Djoko-cli/haier-cchp21ebb-hotte-matter/docs/photos/1.jpg

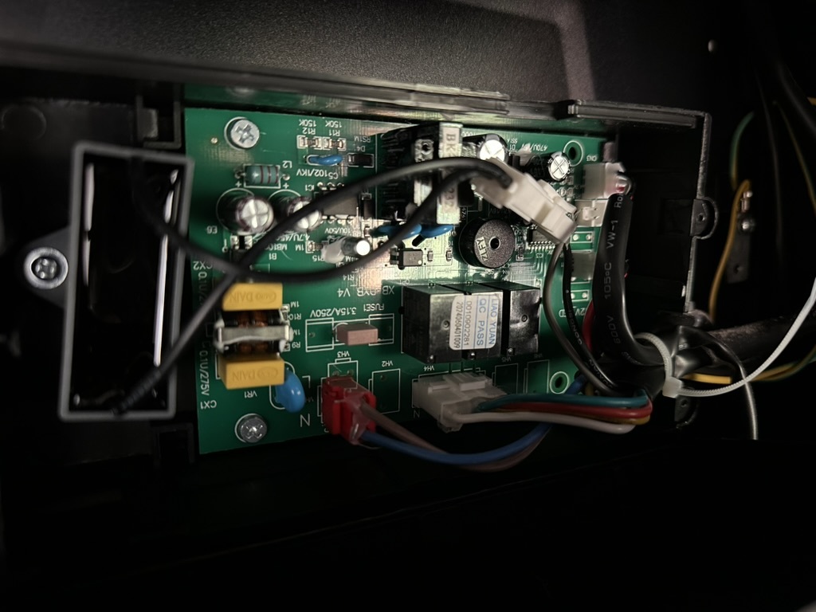
docs/photos/1.jpg
