Djoko-cli/haier-cchp21ebb-hotte-matter/docs/photos/etape0-relais.jpg

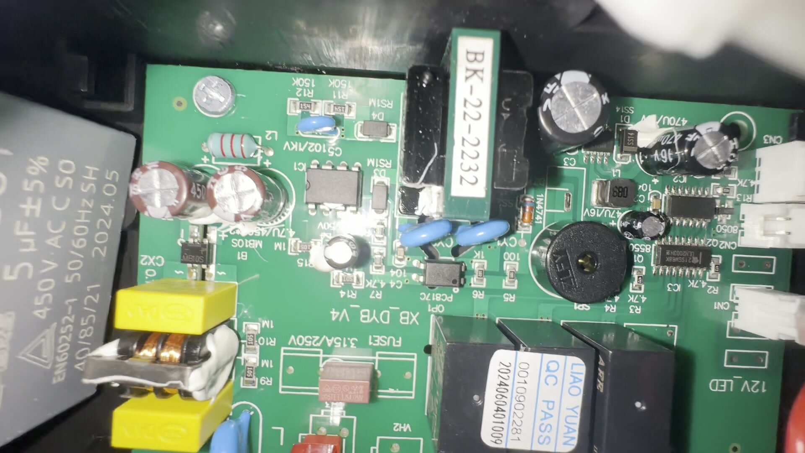
docs/photos/etape0-relais.jpg
