Djoko-cli/haier-cchp21ebb-hotte-matter/docs/RECONNAISSANCE.md

# Journal de la reconnaissance

Journal du sous-projet 1 (déroulé : §6 de
[SPEC-RECONNAISSANCE.md](SPEC-RECONNAISSANCE.md)). Chaque étape consigne ce
qu'elle a relevé : date, conditions, mesures, photos et décision. **On ne passe à
l'étape suivante que si son critère de sortie est rempli.**

Règles de sécurité : [SECURITE.md](SECURITE.md). Montage, points de test et
valeurs : [WIRING.md](WIRING.md).

**Comment remplir :**
- une ligne par mesure ; « Relevé » : la valeur lue, avec son unité ;
  « Décision » : la suite, ou **ARRÊT** (on ne raccorde rien, on ne met pas sous
  tension, on revient à la conception) ;
- les pinces se posent et se déplacent hotte débranchée (règle 4) ;
- photos dans `docs/photos/`, nom proposé `etapeN-sujet.jpg`, sans métadonnées
  EXIF ;
- ce journal est versé dans un **dépôt public** : ni SSID, ni mot de passe, ni
  clé, ni adresse, ni numéro de série.

## Installation et instruments

| Élément | Relevé |
|---|---|
| Hotte | Haier CCHP21EBB, fabrication 06/2024 |
| Prise et différentiel 30 mA (repère au tableau électrique) | |
| Multimètre : modèle ; calibre ohmmètre le plus élevé ; fréquence et rapport cyclique ? | |
| Batterie USB : modèle ; essai de 30 min, sonde en Wi-Fi, sans coupure (date, résultat) | Anker Prime Power Bank 250 W (99,54 Wh) ; 09/11/2026, 30 min avec le motif `krona`, un seul boot, aucun trou de plus de 0,3 s : OK ([BANC.md §7](BANC.md)) |
| Analyseur FX2 : reçu le ; version de PulseView | clone « Saleae » 24 MHz 8 voies (FX2, AliExpress), commandé le 27/09/2026 ; reçu le ____ ; PulseView ____ (pilote `fx2lafw` ; **pas** le logiciel Saleae Logic 2, qui refuse les clones) |
| Oscilloscope, optionnel (niveaux bas chiffrés aux étapes 5b et 7) : modèle, ou « aucun » | aucun : niveau bas jugé fonctionnellement (choix de l'utilisateur, 27/09) |
| Firmware de la sonde (`fw` de `hello`) | `0.1.0-8edfb6a` (banc 21, 10/11/2026) ; à relever de nouveau à l'étape 5 |
| Couleurs du câble de sortie : fil 1 `−`, fil 2 `+`, fil 3 `D_panneau`, fil 4 `D_carte` | prévu (UL1007 22 AWG commandé le 27/09) : noir `−`, rouge `+`, blanc `D_panneau`, marron `D_carte`, comme le câble d'origine du panneau (noir `−`, blanc `D`, rouge `+`) |
| `R_be` de l'étage d'écoute (100k par défaut ; changements notés à l'étape 5b) | |
| Carte de la sonde : modèle (le produit prévoit la SuperMini violette, antenne céramique) | |
| Point d'accès Wi-Fi pour M1 : pièce, distance à la hotte, canal 2,4 GHz (ni SSID ni adresse : dépôt public) | |
| Routeurs de bordure Thread : modèles, distance à la hotte | dans la même pièce, à moins de 5 m (l'utilisateur, 28/09) ; modèles : ____ |

## Tests du différentiel (règle 2)

Avant la première mise sous tension de chaque montage, juste avant de le poser,
hotte dans son état précédent, déjà contrôlé : hotte branchée, lumière allumée,
bouton T. **La lumière doit s'éteindre**, sinon **ARRÊT**. Réarmer, puis
débrancher pour poser le montage.

| Date | Avant quel montage | Lumière éteinte par T ? | Décision |
|---|---|---|---|
| | adaptateur (première mise sous tension : étape 2c) | | |
| | fuite en charge (étape 3a) | | |
| | sonde (étape 5) | | |
| | analyseur (étape 5b) | | |
| | étage d'injection (étape 7) | | |

## Journal des anomalies (règle 12)

Anomalie : déclenchement du différentiel ou du disjoncteur, odeur, fumée,
claquements de relais répétés, bip continu, panneau mort, fil chaud. On
débranche ; on ne réarme et on ne rebranche qu'une fois la cause comprise et
notée ici.

| Date, heure | Étape | Ce qui était branché ; ce qu'on a vu, entendu, senti | Cause comprise | Reprise (date) |
|---|---|---|---|---|
| | | | | |

## Étape −1 : observation d'usage

**Date :** 27/09/2026, vidéo de l'utilisateur `IMG_9091.MOV` (35 s, 19 h 43), analysée image par image (toutes les 0,5 s, puis toutes les 0,1 s pour le clignotement) et au spectrogramme pour les bips et le bruit du moteur. La vidéo n'est pas versée dans le dépôt (58 Mo) ; les états du panneau sont dans [photos/panneau-etats.jpg](photos/panneau-etats.jpg).

**Conditions :** hotte en usage normal, fermée ; aucun outil.

**Disposition du panneau**, de gauche à droite : **vitesse 3** (ventilateur à 5-6 pales), **vitesse 2** (4 pales), **vitesse 1** (3 pales), **lumière** (soleil), **marche** (⏻). L'ordre des vitesses est confirmé par le bruit du moteur (bande 100-1 500 Hz, en régime) : environ −39 dBFS en V1 (après 2 s d'accélération), −33 en V2, −29 en V3.

| # | Mesure | Calibre | Attendu | Relevé | Décision |
|---|---|---|---|---|---|
| 1 | depuis la veille, un appui sur une vitesse sans passer par « marche » | — | rien, un bip, ou un démarrage | **rien, et pas de bip** (réponses de l'utilisateur, 27/09) : une vitesse n'agit que si « marche » a été appuyée avant | une vitesse injectée depuis l'arrêt devra être précédée de « marche » (séquence de l'avenant). Sans bip, deux lectures restent possibles : le panneau n'envoie rien (il garde l'état « marche »), ou la carte reçoit la touche et l'ignore sans bip. La capture de l'étape 5 tranchera : une trame apparaît-elle sur `D` pour une vitesse appuyée sans marche ? |
| 2 | la lumière s'allume-t-elle sans « marche » ? | — | oui ou non | **oui** : à 16,7 s, lumière allumée voyant ⏻ éteint ; éteinte à 18,6 s. Elle reste aussi allumée quand on coupe la marche (33,0 s) | la lumière est indépendante de la marche |
| 3 | « marche » quand le moteur tourne | — | arrêt immédiat, **marche prolongée** (arrêt différé natif, comme les 15 min de la CDA : durée ?), ou rien | **marche prolongée** (27,7 s, en V3) : le moteur continue à la même vitesse, le voyant V3 reste fixe, le voyant ⏻ **clignote à 1 Hz** (0,5 s allumé, 0,5 s éteint). Durée : **15 min** (réponse de l'utilisateur, 27/09). Dans la vidéo, interrompue à 31,2 s par un appui sur V3, qui arrête le moteur tout de suite ; le voyant ⏻ redevient alors fixe (marche maintenue) | **arrêt différé natif de 15 min** : à exploiter au sous-projet 2 |
| 4 | nouvel appui sur la vitesse active | — | | **arrêt du moteur** (12,9 s, en V3) : voyant de vitesse éteint, marche maintenue (⏻ fixe) ; le moteur ralentit en environ 1,5 s | les vitesses sont des bascules sur elles-mêmes |
| 5 | l'état « armé » après « marche » s'éteint-il seul ? Au bout de combien de temps ? | — | | **non**, ou pas avant 30 min (réponse de l'utilisateur, 27/09) | « marche » peut rester armée longtemps : le produit ne peut pas compter sur une extinction seule |
| 6 | **voyants** : lesquels s'allument, et quand ? Fixes, clignotants, intensité ? Voyant de « marche » ? | — | | ⏻ **fixe** = marche ; ⏻ **clignotant à 1 Hz** = marche prolongée ; **un seul** voyant de vitesse à la fois, on passe directement de V1 à V2 puis V3 sans arrêt ; ☼ allumé = lampe allumée ; éteints, les pictogrammes restent visibles en gris | à comparer au panneau seul (étape 4) : qui pilote ces voyants ? |
| 7 | **bips** : lesquels, et quand ? (le buzzer est sur la carte : chaque bip prouve que la carte a reçu quelque chose) | — | | **un seul bip, toujours le même**, pour **chaque** appui (16 bips pour 16 appuis) : environ 200 ms à 4,11 kHz, qu'il s'agisse de marche, d'une vitesse ou de la lumière, avec ou sans marche | chaque appui du panneau passe par la ligne `D` jusqu'à la carte |
| 8a | appui long (3 s) sur la lumière : effet caché ? comment l'annuler ? | — | verrouillage, rappel de filtre, arrêt différé, ou rien | **rien** (réponse de l'utilisateur, 27/09) | aucune fonction cachée |
| 8b | appui long (3 s) sur « marche » | — | idem | **rien** | idem |
| 8c | appui long (3 s) sur la vitesse 1 | — | idem | **rien** | idem |
| 8d | appui long (3 s) sur la vitesse 2 | — | idem | **rien** | idem |
| 8e | appui long (3 s) sur la vitesse 3 | — | idem | **rien** | idem |
| 9 | **reprise après coupure** : vitesse 2 et lumière allumée, fiche débranchée 10 s, rebranchée : quel état revient ? | — | | **rien ne se rallume** ; un seul bip au rebranchement (réponse de l'utilisateur, 27/09) | l'état n'est pas gardé : après une coupure, la hotte est éteinte (moteur, lumière, marche). Le bip de mise sous tension vient de la carte |
| 10 | **délai prudent entre deux changements de vitesse**, d'après ce qu'on entend des relais | — | 3 s par défaut | pas mesuré : les relais ne se distinguent pas dans la vidéo. L'utilisateur a changé de vitesse toutes les 1,5 à 2,5 s sans incident | fixe la valeur de l'étape 7 |

**Chronologie de la vidéo du 27/09** (temps de la vidéo ; « bip » = pic à 4,11 kHz) :

| Temps | Appui | Effet observé |
|---|---|---|
| 1,8 s | marche | bip ; voyant ⏻ fixe |
| 3,9 s | marche | bip ; voyant ⏻ éteint |
| 5,8 s | marche | bip ; voyant ⏻ fixe |
| 7,6 s | V1 | bip ; voyant V1 ; le moteur accélère pendant environ 2 s |
| 9,8 s | V2 | bip ; voyant V2 à la place de V1 ; moteur plus fort |
| 11,5 s | V3 | bip ; voyant V3 ; moteur au plus fort |
| 12,9 s | V3 (active) | bip ; voyant V3 éteint ; le moteur s'arrête ; ⏻ reste fixe |
| 15,1 s | marche | bip ; voyant ⏻ éteint |
| 16,7 s | lumière | bip ; lampe et voyant ☼ allumés, sans marche |
| 18,6 s | lumière | bip ; lampe éteinte |
| 20,2 s | marche | bip ; voyant ⏻ fixe |
| 20,9 s | lumière | bip ; lampe allumée |
| 21,6 s | V1 | bip ; voyant V1 ; le moteur démarre |
| 24,0 s | V2 | bip ; voyant V2 |
| 25,8 s | V3 | bip ; voyant V3 |
| 27,7 s | marche (moteur en V3) | bip ; **marche prolongée** : le moteur continue, ⏻ clignote à 1 Hz |
| 31,2 s | V3 (active) | bip ; le moteur s'arrête ; ⏻ redevient fixe ; la lampe reste allumée |
| 33,0 s | marche | bip ; voyant ⏻ éteint ; la lampe reste allumée |
| 33,6 s | lumière | bip ; lampe éteinte |

**Complété le 27/09** par les réponses de l'utilisateur : lignes 1, 5, 8a à 8e, 9 et la durée de la marche prolongée (15 min). Seule la ligne 10 reste sans mesure : on garde les 3 s par défaut.

**Sortie :**
- [x] le tableau des comportements est rempli (27/09 : vidéo pour les lignes 2, 3, 4, 6 et 7, réponses de l'utilisateur pour 1, 5, 8 et 9 ; ligne 10 : 3 s par défaut).

## Étape −1b : marche prolongée (ajout du 28/09)

Complète les lignes 3 et 4 de l'étape −1 : les transitions de la marche
prolongée que la vidéo du 27/09 n'a pas montrées. L'étape 5 (lignes 7b1 à 7b5)
en capturera les trames.

**Date :**

**Conditions :** hotte en usage normal, fermée (l'adaptateur peut être en place,
`J1` fermé) ; un téléphone filme le panneau, avec le son ; chronomètre. On ne
touche qu'aux touches du panneau.

**Départ de chaque ligne :** hotte éteinte (⏻ éteint) ; « marche », V2, 10 s
d'attente ; puis « marche » moteur tournant : la prolongation commence (⏻
clignote), et l'on lance le chronomètre. **Retour à l'état éteint entre deux
lignes :** vitesse active, moteur arrêté (⏻ fixe), puis « marche ».

| # | Mesure | Calibre | Attendu | Relevé | Décision |
|---|---|---|---|---|---|
| 11 | fin de la prolongation, **lampe allumée avant le départ**, sans rien toucher ; vidéo de 14 min 30 à 16 min après l'appui | chronomètre ; vidéo | fin vers 15 min (ligne 3) ; état final inconnu | fin à ____ min ____ s ; moteur : ____ ; ⏻ : ☐ éteint ☐ fixe ☐ clignote ; voyant de vitesse : ____ ; lampe : ☐ allumée ☐ éteinte ; bip à la fin : ☐ oui ☐ non | transition « prolongée → fin » de l'automate. Pas de fin à 16 min : on filme jusqu'à la fin, 30 min au plus après l'appui, puis on éteint au panneau et on le note |
| 12 | vitesse active (V2), 5 s après le début de la prolongation | vidéo | état armé : moteur arrêté, ⏻ fixe (vidéo du 27/09, 31,2 s) | | confirme la ligne 3 |
| 13 | « marche », 5 s après le début de la prolongation | vidéo | inconnu : éteinte (sur la CDA, un 2e appui arrête : brief §1.2, ligne 25), état armé, prolongation relancée, ou rien | moteur : ____ ; ⏻ : ____ ; bip : ☐ oui ☐ non | transition de l'automate |
| 14 | autre vitesse (V3), 5 s après le début de la prolongation | vidéo | inconnu : V3 en marche normale (⏻ fixe), prolongation poursuivie en V3 (⏻ clignote), ou rien | moteur : ____ ; ⏻ : ____ ; bip : ☐ oui ☐ non | transition de l'automate |

**Sortie :**
- [ ] les lignes 11 à 14 sont remplies ; l'automate du sous-projet 2 reprend ces transitions.

## Étape 0 : photos, inventaire et cheminements

**Date :** 28/09/2026 (vidéos `IMG_9111` et `IMG_9112` de l'utilisateur, 15 h 19 et 15 h 22 ; lignes 1a à 4) ; lignes 5 et 6 : à faire.

**Conditions :** hotte débranchée depuis 5 min (débranchée à : ____).

| # | Mesure | Calibre | Attendu | Relevé | Décision |
|---|---|---|---|---|---|
| 1a | IC2 : marquage, nombre de broches | photo macro | SOP-14 sans marquage (comme la CDA) | SOP-14, sans marquage visible (`etape0-ic.jpg`) | comme la CDA : le microcontrôleur, protocole de `D` inconnu, à apprendre |
| 1b | IC3 : marquage, nombre de broches | photo macro | `ULN2003` | `ULN2003H`, SOP-16 (`etape0-ic.jpg`) | conforme : il commande les relais |
| 1c | IC4 : marquage, nombre de broches | photo macro | abaisseur, SOP-8 | `XL1509-5.0` (XLSEMI), SOP-8 : abaisseur 5 V, avec `D1` SS14 et `L1` 68 µH (`etape0-ic.jpg`) | côté basse tension : le `+` de `CN3` est sans doute à 5 V, à mesurer (3b) |
| 1d | relais : marquage | photo macro | 3 relais L, M, H | 3 relais noirs ; leur marquage est caché par une étiquette « LIAO YUAN QC PASS » (`etape0-relais.jpg`) | sans objet : on ne touche pas aux relais |
| 2a | `CN3` : fiche collée ? | visuel | | non : la fiche du panneau se débranche ; elle porte un dépôt de colle translucide à la sortie des fils (28/09) | on la tient par le boîtier, jamais par les fils ni par la colle |
| 2b | pas de `CN3`, entre les broches extrêmes | règle ou pied à coulisse en plastique | 5,0 mm : JST XH ; 4,0 mm : JST PH | 28/09 : fiche du panneau au pied à coulisse, **8,32 mm** (mesure difficile : la fiche déborde des mâchoires sur la photo) ; embase `CN3` photographiée à côté d'une règle : **environ 10,2 mm** (19,7 px/mm sur la règle, 203 px pour l'embase). Fiches techniques JST, 3 broches : XH = fiche 9,8 mm, embase 9,9 mm ; PH = fiche 7,8 mm, embase 7,9 mm | **JST XH, pas de 2,5 mm** : deux mesures sur photo avec règle concordent, l'embase `CN3` (environ 10,2 mm) et la fiche du panneau posée près de la règle (corps d'environ 10,4 mm, 2e photo du 28/09). Le PH (7,8 à 7,9 mm) est exclu ; la mesure de 8,32 mm au pied à coulisse était fausse. Achats : XH 3P et 4P ; les PH 3P sont inutiles |
| 3 | accès : comment retirer le filtre, où est le boîtier, comment s'ouvre son couvercle | — | | filtre : on tire la languette avant, il bascule vers le bas et se retire (`IMG_9112`) ; boîtier : plastique noir sous le moteur ; couvercle à charnière côté avant, clipsé côté moteur : on le tire vers soi, il bascule, sans outil (`IMG_9111`, 0 à 3 s) | accès sans outil, filtre retiré |
| 4 | trajet des fils du condensateur et du connecteur blanc, par rapport à `CN3` et au passage de sortie | photo | | boîtier ouvert, avant toute manipulation (`etape0-fils.jpg`) : condensateur du moteur CBB61 5 µF 450 V à gauche, gros connecteur blanc du moteur en bas à droite, `CN3` en haut à droite de la carte ; les câbles sortent par la droite du boîtier | à revoir avec le cheminement (ligne 6a) |
| 5a | câble du panneau : longueur libre | mètre | | | |
| 5b | comment sa fiche peut sortir du boîtier ; ruban et colliers à refaire à l'identique | photo | | | placement de l'adaptateur (WIRING.md §2) |
| 5c | connecteur intermédiaire sur le câble du panneau ? | visuel | | | |
| 5d | le panneau se démonte-t-il, sans forcer ? Si oui, référence de la puce tactile | visuel | | | décide si C est possible |
| 6a | cheminement possible du câble de sortie jusqu'au boîtier de mesure | photo | par exemple le long du câble du panneau vers l'avant, ou au bord du filtre sans pincement | | |
| 6b | longueur nécessaire du câble de sortie | mètre | | | |
| 6c | emplacement du boîtier de mesure | — | à côté de la hotte, visible, hors de l'aplomb de la plaque de cuisson | | 28/09 : l'utilisateur confirme le boîtier de mesure **provisoire, dehors**, le temps de la reconnaissance ; le module final ira dans le boîtier électronique de la hotte, en boîtier imprimé 3D (sous-projet 2) |

**Photos :**
- [x] Photo IC2, IC3, IC4 (macro) : `docs/photos/etape0-ic.jpg` (image de la vidéo `IMG_9111`, 37 s ; on y voit aussi `CN3`)
- [x] Photo relais : `docs/photos/etape0-relais.jpg` (`IMG_9111`, 10,5 s : vue d'ensemble de la carte)
- [ ] Photo `CN3` de près : `docs/photos/etape0-cn3.jpg`
- [x] Photo fils du condensateur et connecteur blanc, avant toute manipulation : `docs/photos/etape0-fils.jpg` (`IMG_9111`, 3,1 s)
- [ ] Photo câble du panneau, sa sortie, ruban et colliers : `docs/photos/etape0-cable.jpg`
- [ ] Photo cheminement choisi et emplacement du boîtier de mesure : `docs/photos/etape0-cheminement.jpg`

**Sortie :**
- [ ] le pas de `CN3` et les longueurs sont connus : connectique ☒ XH (28/09) ☐ PH ; longueurs : à relever ;
- [ ] on sait si le panneau s'ouvre : ☐ oui (C possible) ☐ non, ou résiné ;
- [ ] le cheminement est choisi, avec une photo.

## Étape 1 : test d'isolation

Procédure pas à pas : [SECURITE.md](SECURITE.md), « Procédure : étape 1 ».

**Date :** 28/09/2026. Multimètre de l'utilisateur, à calibre automatique : `OL` avec
« MΩ » pointes dans le vide, 0 pointes l'une contre l'autre (repères relevés
avant la mesure).

**Conditions :** hotte débranchée depuis 5 min ; broches rondes de la fiche
reliées par le fil à pinces crocodile ; `CN3` piqué par l'arrière avec
l'aiguille, ou, si la colle gêne, fiche du panneau retirée et pointe posée sur
la broche de `CN3` ; aucune partie métallique des pointes touchée.

| # | Mesure | Calibre | Attendu | Relevé | Décision |
|---|---|---|---|---|---|
| a1 | broches reliées vers `CN3 −` | le plus élevé (20 MΩ ou plus) | OL après 10 s (une valeur qui monte vers OL est normale) | OL (MΩ), calibre automatique | isolé |
| a2 | `CN3 −` vers broches reliées (cordons inversés) | idem | OL | OL (MΩ) | isolé |
| a3 | broches reliées vers `D` | idem | OL | OL (MΩ) | isolé |
| a4 | `D` vers broches reliées | idem | OL | OL (MΩ) | isolé |
| a5 | broches reliées vers `+` | idem | OL | OL (MΩ) | isolé |
| a6 | `+` vers broches reliées | idem | OL | OL (MΩ) | isolé |
| b | contact de terre de la fiche vers `CN3 −` | le plus élevé | OL : secondaire flottant ; environ 0 Ω : relié à la terre (pas un défaut, on le note) | 0 Ω : **le `−` de `CN3` est relié à la terre** | noté : pas un défaut |
| c0 | cordons court-circuités | 200 Ω | valeur à soustraire | 0 après quelques instants (calibre automatique) | rien à soustraire à cette résolution |
| c | contact de terre de la fiche vers la vis de terre de la carcasse (ou une vis nue) | 200 Ω | moins de 1 Ω, après soustraction | vers le point de masse prévu dans la hotte : fluctue un instant, puis 0 | moins de 1 Ω : liaison de terre bonne |

**Sortie :** ☒ feu vert pour construire l'adaptateur (28/09/2026) ☐ **ARRÊT** (raison : ____).
Aussi vu sur la carte (`etape0-ic.jpg`, `etape0-relais.jpg`) : transformateur `BK-22-2232`, optocoupleur `PC817C` et condensateurs Y `CY1` à la frontière, alimentation isolée comme prévu ; près de `CN3`, `R13` 4,7 kΩ et `R1` 1 kΩ (pull-up et résistance série de `D` ? à vérifier en 3c) ; `CN1` marqué `12V_LED`.

## Étape 2 : adaptateur et boîtier de mesure

**Date :**

**Conditions :** hotte débranchée depuis 5 min (on ouvre le boîtier).

| Construction | Relevé |
|---|---|
| connectique (XH ou PH, références) | |
| fiche et embase XH 4 broches du câble de sortie vers le boîtier de mesure (références) | |
| fil du câble de sortie (référence, tension, température) | |
| gaine (type, nombre d'épaisseurs) | |
| longueur du câble de sortie | |

Contrôles au multimètre **avant la pose** (WIRING.md §12, mêmes numéros).
Adaptateur et câble : hotte débranchée, adaptateur pas encore posé, fiche XH 4 br.
du câble de sortie enfichée sur le boîtier de mesure (sauf ligne 10).

| # | Mesure | Calibre | Attendu | Relevé | Décision |
|---|---|---|---|---|---|
| 1 | continuité côté carte vers côté panneau : `−`, `D` (`J1` fermé), `+` | 200 Ω | environ 0 Ω chacune | | sinon on corrige avant la pose |
| 2 | court-circuit `−`/`D`, `−`/`+`, `D`/`+` | le plus élevé | OL (100 à 200 kΩ entre `D` et `−` si l'étage d'écoute est relié) | | court-circuit : on corrige avant la pose |
| 3 | `TP−` vers la broche « − » (fil noir) de la fiche qui ira sur `CN3` | 200 Ω | environ 0 Ω | | sinon on corrige avant la pose |
| 4 | `TP+` vers la broche « + » (fil rouge) | 200 Ω | environ 0 Ω | | idem |
| 5 | `TP_Dc` vers la broche `D` de la fiche ; `TP_Dp` vers la broche `D` de l'embase | 200 Ω | environ 0 Ω | | idem |
| 6 | `J1` fermé : `TP_Dp` vers `TP_Dc` | 200 Ω | environ 0 Ω | | idem |
| 7 | `J2` ouvert : `TP+` vers la broche `5V` des barrettes | le plus élevé | OL | | idem |
| 8 | ordre des contacts de la fiche XH 3 br. identique à celui de la fiche du panneau (noir, blanc, rouge) | visuel | détrompeur du même côté | | idem |
| 9 | fiche XH 4 br. : contacts dans l'ordre `−`, `+`, `D_panneau`, `D_carte` (broches 1 à 4), comme l'embase du boîtier | visuel | détrompeur : elle n'entre que dans un sens | | idem |
| 10 | fiche XH 4 br. retirée : `TP−` vers la broche « − » de la fiche qui ira sur `CN3`, puis `TP_Dp` vers la broche `D` de l'embase de l'adaptateur | le plus élevé | OL (boîtier détaché) ; fiche remise ensuite | | idem |

Boîtier de mesure : sonde retirée des barrettes.

| # | Mesure | Calibre | Attendu | Relevé | Décision |
|---|---|---|---|---|---|
| 11 | `TP−` vers la broche `GND` des barrettes | 200 Ω | environ 0 Ω | | sinon on corrige avant la pose |
| 12 | broche `3V3` vers la broche 6 des barrettes | 20 kΩ | environ 10 kΩ (collecteur de Q1) | | idem |
| 13 | `TP_Dp` vers la broche 6 des barrettes, dans les deux sens | le plus élevé | OL dans un sens au moins (règle 10) | | valeur finie dans les deux sens : liaison du bus vers une GPIO, on corrige avant la pose |
| 14 | collecteur de Q1 sur la broche 6 ; le 4,7k de base de Q2 sur la broche 7 | visuel | GPIO6 et GPIO7 non interverties | | sinon on corrige avant la pose |
| 15 | brochage de Q1 et Q2 | visuel | conforme à la fiche du transistor (BC547 = C-B-E, 2N3904 = E-B-C) | | idem |
| 16 | coque de l'USB-C isolée ; USB-C accessible | visuel | | | idem |
| 17 | contrôle électrique du module (WIRING.md §9) | 20 V continu | broche 6 à environ 3,3 V, broche 7 à 0 V | 03/11 : broche 6 à 3,3 V, broche 7 à 0 V ; `3V3` à 3,3 V, `5V` à 5 V ; pas de continuité `5V`-`GND` (module seul, firmware `sonde` 0.1.0-5d01e4a, pointes sur les soudures du module) | conforme : on peut souder |

**Pose :**
- [ ] 1. fiche de l'adaptateur sur `CN3`, fiche du panneau sur l'embase de l'adaptateur ;
- [ ] 2. câble de sortie selon la règle 5 et le cheminement choisi à l'étape 0 ; sa fiche XH 4 br. enfichée sur le boîtier de mesure ;
- [ ] 3. couvercle fermé, en vérifiant qu'il ne pince rien ;
- [ ] 4. filtre remis, en vérifiant qu'il ne pince rien.

**Photos :**
- [ ] Photo adaptateur posé sur `CN3` : `docs/photos/etape2-adaptateur.jpg`
- [ ] Photo câble de sortie au passage de sortie : `docs/photos/etape2-cable.jpg`
- [ ] Photo boîtier de mesure en place : `docs/photos/etape2-boitier.jpg`

### Étape 2b : isolation revérifiée depuis les points de test

Procédure pas à pas : [SECURITE.md](SECURITE.md), « Procédure : étape 2b ».

**Date :**

**Conditions :** hotte débranchée, couvercle fermé, filtre remis ; fiche XH 4 br.
du câble de sortie enfichée sur le boîtier de mesure (retirée, tout lirait OL
sans rien prouver) ; broches de la fiche reliées.

| # | Mesure | Calibre | Attendu | Relevé | Décision |
|---|---|---|---|---|---|
| 1 | broches reliées vers `TP−` | le plus élevé (20 MΩ ou plus) | OL après 10 s | | sinon **ARRÊT** |
| 2 | `TP−` vers broches reliées | idem | OL | | idem |
| 3 | broches reliées vers `TP+` | idem | OL | | idem |
| 4 | `TP+` vers broches reliées | idem | OL | | idem |
| 5 | broches reliées vers `TP_Dp` | idem | OL | | idem |
| 6 | `TP_Dp` vers broches reliées | idem | OL | | idem |
| 7 | broches reliées vers `TP_Dc` | idem | OL | | idem |
| 8 | `TP_Dc` vers broches reliées | idem | OL | | idem |

**Où est le pull-up de `D` ?** `J1` ouvert (hotte débranchée, filtre retiré, sans
ouvrir le boîtier), chaque mesure dans les deux sens.

**Date :**

| # | Mesure | Calibre | Attendu | Relevé | Décision |
|---|---|---|---|---|---|
| p1 | `TP_Dp` vers `TP+` | 20 kΩ ou automatique | quelques kΩ : pull-up côté panneau | | |
| p2 | `TP_Dp` vers `TP−` | idem | l'étage d'écoute y ajoute 100 à 200 kΩ : n'indique rien | | |
| p3 | `TP_Dc` vers `TP+` | idem | quelques kΩ : pull-up côté carte | | |
| p4 | `TP_Dc` vers `TP−` | idem | | | |
| p5 | `J1` refermé, filtre remis | visuel | | | |

Conclusion : pull-up côté ☐ carte ☐ panneau ☐ aucun trouvé ; valeur environ
____ kΩ (sert à l'étape 4 et à la voie 2 si B).

**Nouveaux passages de la mesure 1** (après chaque ouverture du boîtier, et à la
sortie de l'étape 4) :

| Date | Pourquoi le boîtier a été ouvert | `TP−`, `TP+`, `TP_Dp`, `TP_Dc` : OL dans les deux sens ? | Décision |
|---|---|---|---|
| | | | |

### Étape 2c : essai à vide

**Date :**

**Conditions :** hotte branchée ; différentiel testé (tableau plus haut).

| # | Mesure | Calibre | Attendu | Relevé | Décision |
|---|---|---|---|---|---|
| 1 | touche lumière | — | exactement comme avant (étape −1) : lumière, voyant, bip | | |
| 2 | touche « marche » | — | comme avant | | |
| 3 | vitesse 1 | — | comme avant | | |
| 4 | vitesse 2 | — | comme avant | | |
| 5 | vitesse 3 | — | comme avant | | |

**Sortie :**
- [ ] les étapes 2b et 2c sont concluantes ;
- [ ] les photos du montage sont dans ce journal (étape 2).

## Étape 3 : mesures au multimètre

Toutes les pinces se posent et se déplacent **hotte débranchée** (règle 4), avec
des grippe-fils sur le boîtier de mesure. Sous tension, on ne fait que lire
l'afficheur et toucher les touches du panneau.

### 3a. Fuite en charge, avant tout Mac ou analyseur

Procédure pas à pas : [SECURITE.md](SECURITE.md), « Procédure : étape 3a ».

**Date :**

**Conditions :** fiche XH 4 br. du câble de sortie enfichée sur le boîtier ; COM
sur `TP−`, l'autre pince sur la vis de terre de la carcasse, résistance de
10 kΩ / 2 W en parallèle entre les deux pinces ; différentiel testé.

| # | Mesure | Calibre | Attendu | Relevé | Décision |
|---|---|---|---|---|---|
| 1 | tension aux bornes de 10 kΩ / 2 W, lue dans les 5 s après le branchement | tension alternative | 3 V au plus, soit 0,3 mA au plus | ____ V, soit ____ mA (tension / 10 kΩ) | au-delà de 5 V (0,5 mA), ou différentiel déclenché : **ARRÊT** ; entre 3 et 5 V : on le note, et on en rediscute avant de relier un Mac ou l'analyseur |

### 3b. Tensions

**Date :**

**Conditions :** hotte débranchée pour poser les pinces : COM sur `TP−`, V sur
`TP+` (lignes 1 à 7), puis V sur `TP_Dp` (lignes 8 à 18).

| # | Mesure | Calibre | Attendu | Relevé | Décision |
|---|---|---|---|---|---|
| 1 | `+` en veille | 20 V continu | environ 5 V ou environ 12 V, positif | | négatif : adaptateur inversé, **ARRÊT** |
| 2 | `+` après « marche » | 20 V continu | stable | | |
| 3 | `+` lumière allumée | 20 V continu | stable | | |
| 4 | `+` vitesse 1 | 20 V continu | stable | | |
| 5 | `+` vitesse 2 | 20 V continu | stable | | |
| 6 | `+` vitesse 3 | 20 V continu | stable | | |
| 7 | `+` pendant un appui bref (1 à 2 s) | 20 V continu | stable | | |
| 8 | `D` en veille (et fréquence, rapport cyclique si possible) | 20 V continu ; Hz ; % | voir la lecture ci-dessous | | |
| 9 | `D` après « marche » | idem | | | |
| 10 | `D` lumière allumée | idem | | | |
| 11 | `D` vitesse 1 | idem | | | |
| 12 | `D` vitesse 2 | idem | | | |
| 13 | `D` vitesse 3 | idem | | | |
| 14 | `D` pendant un appui bref sur la lumière | idem | | | |
| 15 | `D` pendant un appui bref sur « marche » | idem | | | |
| 16 | `D` pendant un appui bref sur la vitesse 1 | idem | | | |
| 17 | `D` pendant un appui bref sur la vitesse 2 | idem | | | |
| 18 | `D` pendant un appui bref sur la vitesse 3 | idem | | | |

Lecture (cocher ce qui s'applique) :

| Observation | Lecture probable | ☐ |
|---|---|---|
| `V(+,−)` négatif | adaptateur inversé : **ARRÊT** | ☐ |
| `+` ≈ 5 V | sortie de l'abaisseur IC4 : l'étape 4 est possible | ☐ |
| `+` ≈ 12 V | rail du flyback : on saute l'étape 4 | ☐ |
| `D` stable à `+`, avec des creux seulement pendant les appuis | trafic sur événement, repos haut : plutôt A | ☐ |
| `D` entre 40 et 60 % de `+` en permanence | trames continues : plutôt B | ☐ |
| `D` ≈ 0 V au repos, avec de l'activité | UART inversé, repos bas (type Krona) | ☐ |
| une tension continue stable, différente pour chaque touche maintenue | échelle de résistances | ☐ |

### 3c. Test du pull-up

**Date :**

**Conditions :** hotte débranchée pour poser 47 kΩ entre `TP_Dp` et `TP−` sur le
boîtier de mesure ; branchée pour la lecture ; débranchée pour la retirer.

| # | Mesure | Calibre | Attendu | Relevé | Décision |
|---|---|---|---|---|---|
| 1 | `D` au repos, sans la résistance (ligne 8 de 3b) | 20 V continu | | | |
| 2 | `D` au repos, avec 47 kΩ entre `TP_Dp` et `TP−` | 20 V continu | sur 5 V : chute d'environ 0,45 V (pull-up d'environ 4,7 kΩ) ; environ 0,9 V (pull-up d'environ 10 kΩ) ; aucune chute (push-pull, ou pull-up très fort) | | |
| 3 | chute = ligne 1 − ligne 2 ; pull-up estimé ≈ 47 kΩ × chute / ligne 2 | — | | | |
| 4 | résistance retirée, hotte débranchée | visuel | | | |

**Sortie :**
- [ ] `+` connu : ____ V ; ☐ étape 4 possible (`+` ≈ 5 V) ☐ étape 4 sautée (`+` ≈ 12 V) ;
- [ ] repos connu : ☐ haut ☐ bas ;
- [ ] première idée du trafic : ____.

## Étape 4 : panneau seul, hotte débranchée

Seulement si `+` ≈ 5 V. **Il n'y a aucun secteur** : la sonde peut être sur
l'USB du Mac. ☐ Étape sautée (`+` ≈ 12 V).

**Date :**

**Conditions :** hotte débranchée depuis 5 min, boîtier ouvert.

Capture par l'USB (lignes 5 à 10), un fichier par ligne, 30 s chacun :
`python3 tools/serie_enregistre.py <port> <scénario> "capture tout" --duree 30`
(port : `ls /dev/cu.usbmodem*` ; ni `pio device monitor` ni autre outil sur ce
port), qui écrit `logs/AAAA-MM-JJ-hhmm-<scénario>.jsonl` ; résumé à suivre avec
`tail -f logs/live.log`.

| # | Mesure | Calibre | Attendu | Relevé | Décision |
|---|---|---|---|---|---|
| 1 | fiche de l'adaptateur retirée de `CN3` (sinon le 5 V de la sonde alimenterait aussi la carte) | visuel | | | |
| 2 | polarité sans le panneau : fiche du panneau retirée de l'embase, `J2` fermé, USB de la sonde branché ; `TP+` par rapport à `TP−` | 20 V continu | de +4,5 à +5,3 V, positif (un port USB peut monter à 5,25 V) | | sinon **ARRÊT** ; puis débrancher l'USB |
| 3 | USB débranché : en option, 10 kΩ entre `TP_Dp` et `TP+`, si le pull-up est côté carte (étape 2b) | visuel | | ☐ posée ☐ non | |
| 4 | fiche du panneau sur l'embase, puis USB branché, sans toucher les touches (le circuit tactile se calibre) | — | | | |
| 5 | le panneau émet-il tout seul ? Comment ? (`etape4-repos`, sans toucher) | fichier de capture | | | |
| 6 | voyants quand on touche la lumière (`etape4-lumiere`) | — | s'allument seuls : le panneau pilote ses voyants ; restent éteints : la carte les pilote (cas favorable) | | |
| 7 | voyants quand on touche « marche » (`etape4-marche`) | — | idem | | |
| 8 | voyants quand on touche la vitesse 1 (`etape4-v1`) | — | idem | | |
| 9 | voyants quand on touche la vitesse 2 (`etape4-v2`) | — | idem | | |
| 10 | voyants quand on touche la vitesse 3 (`etape4-v3`) | — | idem | | |

**Sortie, dans cet ordre :**
- [ ] 1. débrancher l'USB ;
- [ ] 2. ouvrir `J2` ; retirer la 10 kΩ si elle a été posée ;
- [ ] 3. remettre la fiche de l'adaptateur sur `CN3` ;
- [ ] 4. fermer le couvercle et remettre le filtre, sans rien pincer ;
- [ ] 5. refaire l'étape 2b, qui se mesure couvercle fermé et filtre remis (ligne
  ajoutée au tableau des nouveaux passages).

Le couvercle et le filtre passent avant l'étape 2b : elle se mesure ainsi, et
repère un câble pincé à la fermeture.

**Photos :**
- [ ] Photo montage du panneau seul : `docs/photos/etape4-montage.jpg`
- [ ] Photo voyants pendant un appui : `docs/photos/etape4-voyants.jpg`

## Étape 5 : capture en place

**Date :**

**Conditions :**
- [ ] banc validé (tâches 16 et 21 : critères 1, 2 sans l'analyseur, 3, 4 et 6 dans `BANC.md`) ;
- [ ] batterie vérifiée (30 min) : modèle et essai notés dans « Installation et instruments » ;
- [ ] contrôles de la règle 7 (étapes 1, 2b, 3a) et test du différentiel faits ;
- [ ] sonde sur son boîtier de mesure, fiche XH 4 br. du câble de sortie enfichée, **sur batterie** (modèle vérifié), `J2` ouvert ;
- [ ] session réseau par Wi-Fi ; RSSI au boîtier de mesure : ____ dBm.

Un fichier par scénario, 10 s chacun sauf 7b2, 7c1 et 7c2 (commandes sous le
tableau), dans cet ordre :
`python3 tools/hotte_udp.py enregistre hotte-sonde.local <scénario> "capture tout" --duree 10`,
qui écrit `logs/AAAA-MM-JJ-hhmm-<scénario>.jsonl` ; résumé à suivre avec
`tail -f logs/live.log`. La commande `capture tout` remet le mode `tout` : la
sonde garde en NVS le dernier mode choisi, peut-être `changements`.

| # | Mesure | Calibre | Attendu | Relevé | Décision |
|---|---|---|---|---|---|
| 1 | veille (`veille`) | — | un fichier de 10 s | | |
| 2 | marche (`marche`) | — | idem | | |
| 3 | lumière allumée (`lumiere-on`) | — | idem | | |
| 4 | lumière éteinte (`lumiere-off`) | — | idem | | |
| 5a | vitesse 1 (`v1`) | — | idem | | |
| 5b | vitesse 2 (`v2`) | — | idem | | |
| 5c | vitesse 3 (`v3`) | — | idem | | |
| 6 | arrêt (`arret`) : depuis V2 (moteur en marche depuis 10 s au moins) ; appui sur V2 vers 1 s ; moteur arrêté et ⏻ fixe, appui sur « marche » vers 6 s | — | idem ; hotte éteinte, ⏻ éteint, sans clignotement | | ⏻ qui clignote : « marche » est partie moteur tournant ; on éteint (V2, puis « marche ») et on refait le scénario |
| 6b | vitesse appuyée **sans** marche (`v-sans-marche`) : marche éteinte, appui sur V2 | — | idem ; pas de bip (étape −1, ligne 1) | | une trame sur `D` : la carte reçoit la touche et l'ignore ; aucune trame : c'est le panneau qui garde l'état « marche » |
| 7 | chaque bip entendu (`bip-<touche>`) | — | idem | | |
| 7b1 | début de la marche prolongée (`prol-debut`) : « marche », V2, 10 s d'attente ; enregistrement lancé, appui sur « marche » vers 2 s | — | un fichier de 10 s ; moteur toujours en V2, ⏻ clignote à 1 Hz, bip (étape −1, ligne 3) | | trame de « marche » moteur tournant, identique ou non à celle de « marche » moteur arrêté. Une activité à 1 Hz sur `D` pendant le clignotement est un indice que la carte pilote ⏻ (test 4 de l'étape 6) |
| 7b2 | fin de la marche prolongée (`prol-fin`) : lampe allumée, « marche », V2, 10 s d'attente ; enregistrement de 17 min lancé (commande sous le tableau), appui sur « marche » vers 5 s, chronomètre lancé ; plus aucun appui ; vidéo du panneau de 14 min 30 à 16 min | chronomètre ; vidéo | fin vers 15 min ; état final : celui de l'étape −1b, ligne 11 | fin à ____ min ____ s (heure du Mac : ____) ; moteur : ____ ; ⏻ : ____ ; lampe : ____ ; bip : ☐ oui ☐ non ; trame à la fin : ☐ oui ☐ non | test 6 de l'étape 6. Pas de fin à 17 min : nouvel enregistrement (`prol-fin-suite`) et vidéo jusqu'à la fin, 30 min au plus après l'appui |
| 7b3 | vitesse active pendant la prolongation (`prol-vactive`) : « marche », V2, 10 s d'attente ; enregistrement lancé ; « marche » vers 1 s, puis V2 vers 6 s | — | un fichier de 10 s ; moteur arrêté, ⏻ fixe, bip (étape −1, ligne 3) | | trames de la transition « prolongée → armée » |
| 7b4 | « marche » pendant la prolongation (`prol-marche`) : même départ ; « marche » vers 1 s, puis de nouveau « marche » vers 6 s | — | un fichier de 10 s ; effet relevé à l'étape −1b, ligne 13 (sinon, le noter ici) | | trames de cette transition |
| 7b5 | autre vitesse pendant la prolongation (`prol-autre-v`) : même départ ; « marche » vers 1 s, puis V3 vers 6 s | — | un fichier de 10 s ; effet relevé à l'étape −1b, ligne 14 (sinon, le noter ici) | | trames de cette transition |
| 7c1 | repos moteur tournant (`repos-v2`) : « marche », V2, lampe allumée, 10 s d'attente ; enregistrement de 60 s, **sans aucun appui** | — | un fichier de 60 s : trames périodiques, ou silence | réceptions en 60 s : ____ ; période : ____ s | test 5 de l'étape 6 |
| 7c2 | repos armé (`repos-arme`) : « marche » seule (⏻ fixe, moteur arrêté), lampe éteinte ; 60 s sans appui | — | idem | réceptions en 60 s : ____ ; période : ____ s | test 5 : armée ou éteinte, l'automate doit le savoir pour choisir la séquence |
| 8 | panneau déconnecté (`panneau-off`) : **hotte débranchée**, filtre retiré (si cela ouvre le boîtier : 5 min d'attente), fiche du panneau retirée de l'embase ; couvercle fermé et filtre remis (règle 5), étape 2b si le boîtier a été ouvert ; puis hotte rebranchée | — | on voit si la carte émet seule | | |
| 8b | après `panneau-off` : **hotte débranchée**, filtre retiré (si cela ouvre le boîtier : 5 min d'attente), fiche du panneau remise sur l'embase ; couvercle fermé et filtre remis (règle 5), étape 2b si le boîtier a été ouvert | visuel | à la remise sous tension, le panneau marche comme avant (étape 2c) | | |
| 9 | compteurs de la sonde après la série : `debord`, `lignes_perdues`, `sautes` | — | 0 partout | | sinon on refait le scénario |

**Lignes 7b et 7c (ajout du 28/09).** Départ de chaque ligne : hotte éteinte
(⏻ éteint). Entre deux lignes, on revient à l'état éteint au panneau : vitesse
active, moteur arrêté (⏻ fixe), puis « marche ». Jamais « marche » moteur
tournant : elle lance la prolongation. Deux commandes changent :
- 7b2 : `python3 tools/hotte_udp.py enregistre hotte-sonde.local prol-fin "capture changements" --duree 1020`.
  Le mode `changements` garde le fichier petit si la carte répète ses trames.
  En mode `tout`, un trafic continu donnerait jusqu'à 90 Mo en 17 min
  (100 lignes par seconde). Une réception identique à la précédente n'est pas
  émise, mais elle se voit dans `etat.capture.rep_en_cours`. La ligne suivante
  remet `capture tout` ;
- 7c1 et 7c2 : `python3 tools/hotte_udp.py enregistre hotte-sonde.local <scénario> "capture tout" --duree 60`.

Pendant les 17 min de 7b2, on reste dans la pièce (règle 12). La batterie est
chargée avant la séance.

Captures versées dans `captures/`, une par scénario (l'outil refuse un fichier
qui contient une clé) :
- [ ] `python3 tools/verse_capture.py logs/<fichier>.jsonl etape5-<scénario>`

**Photos :**
- [ ] Photo sonde sur le boîtier de mesure, sur batterie : `docs/photos/etape5-sonde.jpg`

**Sortie :**
- [ ] un fichier par scénario, versé dans `captures/` ;
- [ ] les compteurs de la sonde sans perte ni débordement ;
- [ ] fin de séance : hotte débranchée, sonde et batterie retirées avant toute cuisson (règle 13).

## Étape 5b : validation croisée à l'analyseur

Obligatoire avant l'étape 6.

**Date :**

**Conditions :**
- [ ] différentiel testé avant de poser l'analyseur (tableau plus haut), puis hotte débranchée ;
- [ ] hotte débranchée pour poser les pinces : masse de l'analyseur **d'abord**, sur `TP−` ;
- [ ] voie 1 sur la sortie de l'étage d'écoute, le même nœud que GPIO6 (3,3 V) ;
- [ ] voie 2 sur `TP_Dp` à travers le diviseur (WIRING.md §8) : ☐ 47k/68k (`+` = 5 V) ☐ 100k/33k (`+` = 12 V) ;
- [ ] Mac sur batterie, sans aucun autre câble (règle 8), analyseur **en USB direct** (pas d'isolateur ADuM3160 : limité au Full Speed, il bride l'échantillonnage) ;
- [ ] USB de l'analyseur branché au Mac **hotte encore débranchée**, après les pinces (règle 4) ; puis hotte branchée ;
- [ ] PulseView, fréquence d'échantillonnage : ____ ;
- [ ] la sonde enregistre en même temps, par le Wi-Fi : `python3 tools/hotte_udp.py enregistre hotte-sonde.local etape5b-<scénario> "capture tout" --duree 10` (fichier : ____).

L'analyseur FX2 est numérique : il ne mesure pas de tension. Le niveau bas de
`D` (lignes 4 et 5) se juge donc fonctionnellement ; une mesure chiffrée, à
l'oscilloscope, est optionnelle.

| # | Mesure | Calibre | Attendu | Relevé | Décision |
|---|---|---|---|---|---|
| 1 | voie 1 : durées de la sonde contre celles de l'analyseur | — | écart de ±2 µs au plus, plus le quantum de 1 µs | | |
| 2 | voie 1 : trames décodées par la sonde et par l'analyseur | — | identiques | | |
| 3 | écarts entre réceptions (`t_us`) contre l'analyseur | — | quelques dizaines de µs | | |
| 4 | niveau bas de `D` pendant les trames du panneau | — | jugement fonctionnel : lignes 1 et 2 concluantes, capture propre, chaque impulsion de la voie 2 retrouvée sur la voie 1 ; si mesuré : sous 0,6 V | | sinon : relever le seuil (`R_be`, WIRING.md §5), puis refaire l'étape 5 |
| 5 | niveau bas de `D` pendant les trames de la carte | — | idem | | idem |
| 6 | voie 2 : temps de montée de `D` | — | c'est la tolérance de la voie 2 | | |

Instrument qui a donné les niveaux des lignes 4 et 5 : ☐ jugement fonctionnel
(analyseur) ☐ oscilloscope : ____.

Captures de la sonde versées dans `captures/` :
- [ ] `python3 tools/verse_capture.py logs/<fichier>.jsonl etape5b-<scénario>`

**Fin de séance, dans cet ordre (règle 8) :**
- [ ] 1. débrancher la hotte ;
- [ ] 2. retirer l'analyseur (USB et pinces) ;
- [ ] 3. ensuite seulement, rebrancher le chargeur du Mac.

**Photos :**
- [ ] Photo montage de l'analyseur : `docs/photos/etape5b-analyseur.jpg`
- [ ] Photo capture PulseView (copie d'écran) : `docs/photos/etape5b-pulseview.png`

**Sortie :**
- [ ] critères de la voie 1 remplis, niveaux bas jugés (lignes 4 et 5) : étape 6 permise ;
- [ ] le cas échéant : seuil relevé (`R_be` = ____) et étape 5 refaite.

## Étape 6 : décodage et choix de l'architecture

**Date :**

**Conditions :** captures des étapes 5 et 5b ; `tools/analyse.py`.

| # | Mesure | Calibre | Attendu | Relevé | Décision |
|---|---|---|---|---|---|
| 1 | seuil de silence choisi après coup (`analyse.py trames --silence`) | µs | | | |
| 2 | `analyse.py auto` : hypothèse retenue et taux d'erreur | — | UART (débits bas de 300 à 1 200 bauds compris, repos bas compris), distance d'impulsion (type WTC6534), ou Manchester | | |
| 3 | `analyse.py diff` : bits de chaque touche et de chaque état | — | | | |
| 4 | test 1 : après le relâchement, la trame revient-elle à « aucune touche » ? | — | oui : la carte détient l'état de la hotte | | |
| 5 | test 2 : la carte répond-elle après chaque trame ? Avec quel délai ? | — | | | |
| 6 | test 3 : y a-t-il des silences plus longs qu'une trame, où l'on pourrait injecter ? | — | | | |
| 7 | test 4 : la carte émet-elle son état ou un paquet de voyants ? | — | | | |
| 8 | test 5 : au repos sans appui (7b2, 7c1, 7c2), la carte répète-t-elle son état ? Avec quelle période ? | s | trames périodiques qui portent l'état (moteur, vitesse, ⏻, lampe), ou silence | | répété : au démarrage, le module du produit relira l'état sur `D` avant de publier. Silence : l'état ne se relit pas par `D` ; la parade (lecture d'état annexe) est à cadrer au sous-projet 2 |
| 9 | test 6 : la fin de la marche prolongée laisse-t-elle une trame sur `D` (7b2) ? | — | | | oui : le module du produit lira la fin sur le bus ; non : il la verra à la répétition suivante de l'état (test 5), ou, sans répétition, par la lecture d'état annexe (arrêt du moteur ; spec du produit, §5.9) |

### Décision de l'étape 6

Entrées (en croisant avec l'étape 4) :

| Entrée | Source | Relevé |
|---|---|---|
| voyants du panneau seul quand on touche | étape 4 | ☐ s'allument seuls ☐ restent éteints ☐ étape sautée : seul le test 4 renseigne |
| état ou paquet de voyants émis par la carte | test 4 | ☐ oui ☐ non |
| `D` en drain ouvert ou en push-pull | étapes 3c et 5b | |
| silences exploitables | test 3 | |
| trafic continu, ou réponse attendue dans un délai court | étape 3b, tests 2 et 3 | |
| le panneau s'ouvre ; il est résiné | étape 0 | |
| échelle de résistances au lieu d'un bus de données | étape 3b | |

Règle de choix (§4 de la spec) :

| Résultat de la reconnaissance | Choix | ☐ |
|---|---|---|
| **la carte pilote les voyants** (voyants éteints à l'étape 4, ou paquet de voyants émis par la carte), `D` en drain ouvert avec des silences exploitables | **A** | ☐ |
| **la carte pilote les voyants**, mais trafic continu, réponse attendue dans un délai court, ou `D` en push-pull | **B** | ☐ |
| **le panneau pilote ses voyants** (il les allume seul et la carte n'émet aucun état), ou `D` unidirectionnel sans état renvoyé | **C**, si le panneau s'ouvre | ☐ |
| le panneau pilote ses voyants **et** il est résiné | pas de solution propre qui respecte la contrainte des voyants : on en rediscute avec l'utilisateur, faits en main | ☐ |
| échelle de résistances au lieu d'un bus de données | **A**, avec une résistance commutée vers `−`, si la carte pilote les voyants | ☐ |

**Choix retenu :** ☐ A ☐ B ☐ C ☐ aucune (on en rediscute avec l'utilisateur)

**Argumentaire** (critère 3 du §1) :

> (à rédiger : faits relevés, règle appliquée, ce qui reste incertain)

**Avenant d'injection**, écrit quel que soit le choix, chiffré d'après
`PROTOCOL.md`, et relu par l'utilisateur avant l'étape 7 :

| Valeur fixée par l'avenant | Valeur |
|---|---|
| syntaxe de `injecte` | |
| durée basse maximale par impulsion (`bas_max_us`) | |
| durée totale maximale par trame (`total_max_us`) | |
| silence minimal avant d'émettre (`silence_min_us`) | |
| attente maximale (`attente_max_ms`) | |
| délai minimal entre deux changements d'état du moteur (`delai_min_ms`, d'après l'étape −1, ligne 10) | |
| séquence d'arrêt de l'étape 7 : signe qui confirme l'arrêt du moteur avant « marche » (trame d'état de la carte, ou constat de l'utilisateur) et attente maximale de ce signe | |
| pour B : le mode relais ; pour C : le prototype PhotoMOS | |

**Sortie :**
- [ ] `docs/PROTOCOL.md` est rédigé ;
- [ ] le choix est argumenté ci-dessus ;
- [ ] l'avenant est écrit (lien : ____) ;
- [ ] l'avenant est relu par l'utilisateur (date : ____).

## Étape 7 : premier essai d'injection

**En présence de l'utilisateur** (règle 11), sous tension, sonde sur batterie. L'utilisateur se
tient à portée de la fiche, voit le panneau, et débranche au moindre doute.

**Date :**

**Conditions :** choix ☐ A ☐ B ☐ C ; avenant relu ; ☐ critère 5 du banc validé
(collision détectée et émission arrêtée, `BANC.md`).

Préparation (choix A) :

| # | Mesure | Calibre | Attendu | Relevé | Décision |
|---|---|---|---|---|---|
| 1 | différentiel testé, hotte dans son état précédent (tableau plus haut), puis hotte débranchée | — | lumière éteinte par T | | sinon **ARRÊT** |
| 2 | hotte débranchée : étage d'injection monté (WIRING.md §6), contrôles avant pose faits ; voie 2 de l'analyseur sur `TP_Dp` par le diviseur, masse d'abord sur `TP−` | visuel | | | |
| 3 | USB branché, `injection monte 1` envoyé | — | réponse `ok` | | |
| 4 | charger les valeurs de l'avenant : `injection regle <nom> <valeur>` (USB, hotte débranchée), une commande par valeur | — | chacune acceptée | | refusée (hors bornes) : l'avenant sort de l'enveloppe de sécurité du firmware, on le revoit |
| 5 | `config` : valeurs de l'avenant chargées | — | égales à celles de l'avenant | | sinon on corrige avant d'aller plus loin |
| 6 | USB débranché, sonde passée sur batterie | visuel | | | |
| 7 | contrôles de la règle 7 à jour (étape 2b refaite si le boîtier a été ouvert) ; Mac sur batterie, sans aucun autre câble | — | | | |
| 8 | hotte branchée ; `injection on` envoyé par `hotte_udp.py`, depuis un terminal, après la confirmation que l'utilisateur tape lui-même : « je suis devant la hotte » (jamais un script ni un agent) | — | injection armée | | |
| 9 | niveau bas obtenu par l'injection, pendant les premiers essais | — | jugement fonctionnel : la carte réagit (bip), et l'impulsion se retrouve sur la voie 2 de l'analyseur et dans `relu_us` de l'événement `injection` ; si mesuré (oscilloscope) : sous 0,8 V | | sinon : on arrête, `injection off`, hotte débranchée, puis 470 Ω remplacées par 220 Ω |

Instrument qui a donné le niveau de la ligne 9 : ☐ jugement fonctionnel
☐ oscilloscope : ____.

Analyseur : pinces puis USB posés hotte débranchée (règle 4) ; fin de séance
comme à l'étape 5b : hotte débranchée, analyseur retiré, puis seulement le
chargeur du Mac (règle 8).

Essais, dans cet ordre, **20 fois sur 20 chacun**. Chaque essai se compte par son
événement `injection` (même `id` que la commande, résultat `ok`). Le firmware
impose le délai minimal entre deux changements d'état du moteur. Une case par
essai : « Essais réussis » si l'on entend le bip, voit l'effet (lumière ou
moteur) et retrouve la trame sur le bus ; « Voyants qui suivent » si **le voyant
du panneau change** comme il faut.

**L'arrêt** est une séquence de deux injections : la vitesse active, puis
« marche ». « Marche » ne part qu'après **la confirmation de l'arrêt du
moteur**, par le signe que fixe l'avenant (trame d'état de la carte si elle en
émet, sinon constat de l'utilisateur : voyant de vitesse éteint, ⏻ fixe, moteur
silencieux), et au moins `delai_min_ms` après la première injection.
**Jamais « marche » moteur tournant** : elle lancerait la marche prolongée
(⏻ clignote). Un essai compte deux événements `injection`. Il est réussi si
les deux sont `ok` et si la hotte finit éteinte : moteur arrêté, ⏻ éteint,
sans clignotement, lampe inchangée. Si ⏻ clignote, c'est un échec : on revient
à l'état éteint au panneau (vitesse active, puis « marche ») et on note la
cause.

| Action | Essais réussis | Voyants qui suivent | Total |
|---|---|---|---|
| touche lumière | ☐☐☐☐☐ ☐☐☐☐☐ ☐☐☐☐☐ ☐☐☐☐☐ | ☐☐☐☐☐ ☐☐☐☐☐ ☐☐☐☐☐ ☐☐☐☐☐ | ____ / 20 |
| vitesse 1 | ☐☐☐☐☐ ☐☐☐☐☐ ☐☐☐☐☐ ☐☐☐☐☐ | ☐☐☐☐☐ ☐☐☐☐☐ ☐☐☐☐☐ ☐☐☐☐☐ | ____ / 20 |
| vitesse 2 | ☐☐☐☐☐ ☐☐☐☐☐ ☐☐☐☐☐ ☐☐☐☐☐ | ☐☐☐☐☐ ☐☐☐☐☐ ☐☐☐☐☐ ☐☐☐☐☐ | ____ / 20 |
| vitesse 3 | ☐☐☐☐☐ ☐☐☐☐☐ ☐☐☐☐☐ ☐☐☐☐☐ | ☐☐☐☐☐ ☐☐☐☐☐ ☐☐☐☐☐ ☐☐☐☐☐ | ____ / 20 |
| « marche » puis une vitesse | ☐☐☐☐☐ ☐☐☐☐☐ ☐☐☐☐☐ ☐☐☐☐☐ | ☐☐☐☐☐ ☐☐☐☐☐ ☐☐☐☐☐ ☐☐☐☐☐ | ____ / 20 |
| arrêt : vitesse active, arrêt du moteur confirmé, puis « marche » (depuis V1, V2 et V3 à tour de rôle) | ☐☐☐☐☐ ☐☐☐☐☐ ☐☐☐☐☐ ☐☐☐☐☐ | ☐☐☐☐☐ ☐☐☐☐☐ ☐☐☐☐☐ ☐☐☐☐☐ | ____ / 20 |

Fichiers d'enregistrement des essais : ____.

**Si le choix est B** (on suit l'avenant) :
- [ ] voie 2 montée (WIRING.md §7), hotte débranchée ;
- [ ] hotte débranchée, filtre retiré (sans ouvrir le boîtier) : `J1` ouvert ; filtre
  remis avant de rebrancher (règle 5) ;
- [ ] mode relais transparent : le panneau marche à travers la sonde ;
- [ ] puis mêmes injections (tableau ci-dessus) et même critère.

**Si le choix est C** (on suit l'avenant) :
- [ ] prototype PhotoMOS sur une touche ; le critère porte sur la touche prototypée.

**Photos :**
- [ ] Photo étage d'injection monté : `docs/photos/etape7-injection.jpg`

**Sortie :**
- [ ] 20 fois sur 20 pour chaque action, et les voyants du panneau suivent ;
- [ ] aucun comportement anormal de la carte ;
- [ ] le vrai panneau fonctionne toujours après l'essai (chaque touche) ;
- [ ] `injection off` ; entre deux sessions, sonde et batterie retirées, `J1` fermé
  (règle 13).

## Mesure M1 pour le produit : radio comparative, hotte débranchée (ajout du 28/09)

Elle prépare le sous-projet 2 et ne conditionne aucune étape de la
reconnaissance (spec §6, « Mesure M1 »). On la fait avant le dessin du boîtier
et avant tout achat de carte.

**Date :**

**Conditions :**
- [ ] hotte **débranchée pendant toute la séance** (débranchée à : ____), fiche à vue ; boîtier ouvert après 5 min ;
- [ ] sonde (modèle : ____) seule, hors du boîtier de mesure, sur sa batterie vérifiée, dans un sachet non métallisé ;
- [ ] point d'accès noté dans « Installation et instruments » ; personne ne passe entre lui et la hotte pendant les relevés.

Une commande par position, 30 s après avoir posé la sonde et refermé :
`python3 tools/hotte_udp.py enregistre hotte-sonde.local m1-<position> "json reseau 10000" --duree 180`.
Médiane du RSSI d'un fichier :

```
python3 -c 'import json,sys,statistics as s
v=[l["l"]["wifi"]["rssi_dbm"] for l in map(json.loads,open(sys.argv[1])) if l["l"].get("t")=="reseau" and (l["l"].get("wifi") or {}).get("rssi_dbm") is not None]
print(len(v),"releves ; mediane",s.median(v),"dBm ; min",min(v),"; max",max(v)) if v else print("aucun releve")' logs/<fichier>.jsonl
```

Les fichiers restent dans `logs/` : seules les médianes vont dans ce journal.

| # | Mesure | Calibre | Attendu | Relevé | Décision |
|---|---|---|---|---|---|
| 1 | P0 (`m1-p0`) : sous la hotte, sur un support isolant posé sur la plaque éteinte et froide, environ 10 cm sous le filtre, à l'aplomb du boîtier électronique, bord de l'antenne vers l'avant de la hotte | RSSI Wi-Fi, médiane sur 3 min | 15 relevés au moins | médiane ____ dBm (min ____, max ____) | |
| 2 | P1a (`m1-p1a`) : dans le boîtier, à l'emplacement prévu du module (quart haut-droit), bord de l'antenne vers l'avant de la hotte ; couvercle fermé, filtre remis, aucun câble sortant | idem | | | aucun relevé : Wi-Fi perdu, la ligne 8 décide |
| 3 | P1b (`m1-p1b`) : même endroit, bord de l'antenne vers le bas (vers le filtre) | idem | | | idem |
| 4 | P0 de nouveau (`m1-p0bis`), comme à la ligne 1 | idem | à 3 dB au plus de la ligne 1 | | plus de 3 dB : série à refaire |
| 5 | *facultatif :* P1, meilleure orientation, couvercle fermé, **filtre retiré** (`m1-p1-sansfiltre`) | idem | | | dit si le filtre est la principale barrière |
| 6 | *facultatif, boîtier ouvert :* quart haut-droit photographié avec une règle en plastique, posée sans toucher la carte ni les zones interdites, dans deux directions (`docs/photos/m1-volume.jpg`) | photo | | | volume libre pour le dessin du boîtier ; évite une ouverture de plus |
| 7 | `A` = ligne 1 − meilleure des lignes 2 et 3 | dB | | `A` = ____ dB ; orientation retenue : ____ | |
| 8 | `R_T` : RSSI moyen du lien Thread vers le routeur de bordure, lu par la C6 du banc Matter en MED (`parent_rssi`), médiane sur 3 min, en P0 ; ou directement en P1 si la C6 du banc peut y être posée | dBm | | `R_T` = ____ dBm, en ☐ P0 ☐ P1 (date du banc : ____) | en attente tant que le banc Matter n'est pas prêt |
| 9 | `M` = ligne 8 − `A` + 104 (mesure en P0), ou ligne 8 + 104 (mesure directe en P1) | dB | | `M` = ____ dB | tableau ci-dessous |

| Marge `M` | Décision | ☐ |
|---|---|---|
| plus de 20 dB | SuperMini violette gardée ; routeur Thread par défaut | ☐ |
| de 10 à 20 dB | SuperMini gardée, en MED ; essai de 48 h du lien avant de figer le boîtier | ☐ |
| moins de 10 dB, ou Wi-Fi perdu en P1 sans mesure Thread directe | carte à antenne déportée (par exemple XIAO ESP32-C6, u.FL) vers une partie non métallique ; M1 refaite avec elle | ☐ |

À moins de 3 dB d'un seuil : série refaite ; si l'écart demeure, la branche la
plus prudente.

**Fin de séance, hotte toujours débranchée :**
- [ ] sonde, batterie et sachet retirés du boîtier et comptés ;
- [ ] couvercle fermé, filtre remis, sans rien pincer ;
- [ ] étape 2b refaite si l'adaptateur est posé (tableau des nouveaux passages) ;
- [ ] sonde remise sur le boîtier de mesure dans le même sens, si elle en venait.

**Sortie :**
- [ ] `A` et `M` notées ; carte décidée (tableau ci-dessus).

## Critères de sortie du sous-projet

- [ ] 1. **Protocole documenté** dans `docs/PROTOCOL.md` : couche physique
  (tension de `+`, niveau de repos, niveau bas de chaque émetteur, jugé à
  l'étape 5b, drain ouvert ou push-pull, pull-up et son côté), codage, trame de
  chaque action, qui détient l'état et qui pilote les voyants ; **validé par la
  capture croisée de l'étape 5b**.
- [ ] 2. **Injection prouvée** : lumière, chaque vitesse, « marche » puis vitesse,
  arrêt (vitesse active, arrêt du moteur confirmé, puis « marche »), 20 fois sur
  20 chacune, et les voyants du panneau suivent (avec C : la touche prototypée).
- [ ] 3. **Architecture du produit choisie** et argumentée ci-dessus, ou constat
  argumenté qu'aucune ne respecte la contrainte des voyants.
