Djoko-cli/haier-cchp21ebb-hotte-matter/docs/PROTOCOLE-JSON.md

# Protocole compagnon v1 : profil « hotte »

Ce document décrit le protocole machine de la **sonde de la ligne `D`**
(ESP32-C6, env `sonde`) **par différence** avec celui de la ScreenBar. La
référence est le protocole de `benq-screenbar-halo-matter` au commit
**`c58a506`** :
[docs/PROTOCOLE-JSON.fr.md](https://github.com/Djoko-cli/benq-screenbar-halo-matter/blob/c58a506/docs/PROTOCOLE-JSON.fr.md)
(noté « ScreenBar » ci-dessous, avec le numéro de section). Tout ce que ce
document ne dit pas est **identique** à la ScreenBar.

- Code : `src/json_out.*` (briques pures, testées sur l'hôte),
  `src/json_mode.*` (sessions, instantanés, événements), `src/cli.cpp`
  (lignes de l'hôte), `src/net_wifi.*` et `src/net_udp_wifi.*` (transport
  réseau), `src/h1_proto.*` (enveloppe H1, copiée de la ScreenBar),
  `src/injection_regles.*` (garde-fous de l'injection, testés sur l'hôte) et
  `src/injection.*` (émission).
- Vérification : `tools/json_check.py` contrôle toute ligne machine contre ce
  profil (capture série brute, ou `.jsonl` avec `--jsonl`). Les exemples des
  sections 8 et 9 sont vérifiés par
  `python3 tools/json_check.py --strict --exemples docs/PROTOCOLE-JSON.md`,
  lancé par `sh tools/tests/test_hote.sh`.
- État : transports USB et UDP sur le Wi-Fi (section 9) ; injection bornée
  de l'étape 7 (sections 5.1 et 6.2), avec la seule syntaxe d'avant
  l'avenant de l'étape 6 : `injecte durees ...`.

## 1. Ce qui ne change pas

| ScreenBar | Ici |
|---|---|
| §2 Tramage : RS + JSON compact ASCII + LF, 1 024 octets au plus, budget de pire cas de 896, découpage par le dernier RS, sens app → carte | identique, sauf le tampon d'émission de l'USB : **8 Ko** au lieu de 4 (section 2) |
| §3 Session : ouverture du port, **DTR = RTS = 0 en un seul appel** (§3.2), séquence de connexion, bail et `json ping`, battement, aucune persistance, écho et invite | identique ; la commande `json` a ses bornes en section 3 |
| §4 Enveloppe : `v`, `t`, `n`, `ms`, puis `bloc` ; entiers seulement | identique, plus `t_us` sur 64 bits (section 2) |
| §6 Commandes : préfixe `id=<n>`, message `reponse`, cadence de 20 lignes par seconde, une commande en vol | identique ; ce qui a une réponse sans texte est en section 5 |
| §9 Versionnage : `v` majeure, ajouts sans changer `v`, l'app ignore l'inconnu | identique ; `rev` = 4 |
| §5, §7, §8, §11, §12 : messages et exemples de la lampe | remplacés par les sections 4 à 8 |
| §10 Transport réseau : UDP sur Thread, enveloppe H1, liste blanche, profil distant | UDP sur le **Wi-Fi**, en IPv4, nom mDNS ; enveloppe H1 **identique** ; liste blanche et profil de la sonde (section 9) |

## 2. Écarts généraux

- **`appareil`** : nouveau champ de `hello` `identite`, `"hotte"` ici. Une app
  multi-appareils choisit sa vue d'après lui ; absent, il vaut `"screenbar"`.
- **`t_us` est un entier sur 64 bits** (`esp_timer_get_time()`, en µs depuis le
  démarrage). Il déroge à la convention « uint32 » de la ScreenBar (§4) ; il
  reste sûr en JSON jusqu'à 2^53 − 1 (285 ans). `Writer::u64` l'écrit ;
  `json_check.py` l'accepte jusqu'à 2^53 − 1.
- **Tampon d'émission de l'USB : 8 Ko** (`Serial.setTxBufferSize(8192)`), pour
  qu'une dizaine de lignes `trame` tiennent pendant que le Mac lit. Les règles
  de la ScreenBar §2.3 sont inchangées : une ligne qui ne tient pas est perdue
  et comptée, jamais écrite à moitié ; une ligne périodique ne part que s'il
  reste ensuite 1 024 octets libres.
- **`rev` = 4** : la révision de la ScreenBar au commit `c58a506`, dont le
  profil hotte part. `build` = `sonde`, `reseau_build` = `aucun`.
- **Codes de `reponse`** : `ok`, `accepte`, `en_cours`, `execute` (avec `ok`
  vrai) ; `usage`, `refuse`, `inconnue`, `trop_long`, `cadence`, `interdite`,
  `deja_traite` (avec `ok` faux). Les codes de la lampe (`differe`,
  `radio_absente`, `radio_perdue`) n'existent pas ici. `suite` ne prend
  qu'une valeur, `injection`, avec le code `accepte`.

## 3. Session : la commande `json`

Comme la ScreenBar §3.4, avec ces bornes :

| Commande | Effet | Bornes (USB) |
|---|---|---|
| `json` | état de la session, en texte | |
| `json 1 [bail <s>]` | mode machine ; `hello`, `config` et l'instantané complet par la file des périodiques, puis la `reponse` | bail 0 (aucun) ou 10..600 s, défaut 30 |
| `json 0` | retour au mode humain : `fin`, puis l'invite | |
| `json etat` | instantané : `etat` (4 blocs) et `compteurs` | |
| `json hello` | `hello` (2 blocs) et `config` | |
| `json ping` | renouvelle le bail ; la `reponse` porte `bail_s` et `up_s` | |
| `json periode <ms>` | période des `etat` | 0 ou 200..60000, défaut **1 000** |
| `json compteurs <ms>` | période des `compteurs` | 0 ou 200..60000, défaut **1 000** |
| `json reseau <ms>` | période des `reseau` (bloc `ip`, section 4.6) | 0 ou 1000..60000, défaut **5 000** |
| `json trames 0\|1` | événements `trame` | défaut 1 |
| `json log 0\|1` | annonces du firmware en messages `log` | défaut 0 |
| `json cle ...` | clé du transport réseau (section 9.3) | USB seulement ; `nouvelle` avec un `id` seulement |

`json trames 0` coupe l'envoi des `trame` à cette session ; `capture off`
arrête la capture elle-même. Les trames ne se coupent jamais seules (écart à
la ScreenBar §10.5 : elles sont la raison d'être de la sonde).

Le bail compte comme à la ScreenBar (§3.5). Pour un enregistrement long par
l'USB, `tools/serie_enregistre.py` ouvre la session par `json 1 bail 0` et la
ferme par `json 0`.

## 4. Messages périodiques et de session

Les blocs `etat` portent `boot` et `up_s` en tête, comme à la ScreenBar : ils
servent de battement (`hb` toutes les 2 s si `periode_ms` vaut 0 ou plus de
2 000) et révèlent un redémarrage (§3.6).

### 4.1 `hello`

**Bloc `base`** : **tous** les champs de la ScreenBar §5.1, dans le même ordre.
Valeurs propres : `build` = `sonde`, `reseau_build` = `aucun` (pas de réseau
Matter ; le transport UDP est dit par `caps`), `env` = `sonde`,
`session.transport` = `usb` ou `udp`. `fw` doit égaler `fw_desc`.

**Bloc `identite`** : **tous** les champs de la ScreenBar, puis `appareil`,
puis `caps`.

| Champ | Valeur |
|---|---|
| `mac` | MAC-48 d'usine, 12 hexa |
| `id.fabricant` | `Djoko-CLI` |
| `id.produit` | `Sonde hotte Haier` |
| `id.serie` | `HOTTE-` + MAC en 12 hexa majuscules |
| `id.nom` | `Sonde hotte` |
| `id.hw`, `id.hw_txt` | `1`, `C6 SuperMini, etages v1` |
| `appareil` | `hotte` |
| `caps` | `sonde` (capture de la ligne `D`), `injection` (présente dans ce build), `trames`, `log`, `udp` (transport UDP, section 9), `cle` (`json cle`), `mdns` (résoudre `reseau.ip.mdns.nom` au lieu de `srp.nom`) |

### 4.2 `config`

Émise avec `hello`, et de nouveau après chaque `capture tout`,
`capture changements`, `seuils <valeurs>`, `injection monte 0|1` ou
`injection regle <nom> <valeur>` accepté, même si les valeurs ne changent pas
(`sondeAppliquer`). `capture on` et `capture off` ne changent pas la `config` :
l'état se lit dans `etat.capture.active` ; de même, `injection on` et
`injection off` se lisent dans `etat.injection.armee`.

| Champ | Type | Sens |
|---|---|---|
| `capture.gpio` | entier | broche d'écoute (6) |
| `capture.resol_hz` | entier | 1 000 000 ou 500 000 |
| `capture.filtre_us` | entier 0..3 | filtre anti-parasites du RMT |
| `capture.silence_us` | entier | silence de fin de réception : 1 000 µs à 32 767 ticks |
| `capture.mode` | `tout` ou `changements` | mode d'émission (spec §8.2) |
| `capture.inverse` | booléen | étage d'écoute inverseur : les niveaux publiés sont ceux **du bus** |

Objet `injection` : les valeurs de l'avenant de l'étape 6 (spec §6), et avant
lui les valeurs par défaut ci-dessous. Elles se règlent par l'USB seulement
(`injection regle <nom> <valeur>`, section 5.1), sont vérifiées avant d'être
écrites en NVS (espace `hotte`, clé `inj_params`), et de nouveau au démarrage :
un jeu hors bornes y est remplacé tout entier par les valeurs par défaut.

| Champ | Bornes | Défaut | Sens |
|---|---|---|---|
| `injection.gpio` | | 7 | base de l'étage d'injection |
| `injection.bas_max_us` | 10..20 000 | 3 000 | durée basse maximale d'une impulsion |
| `injection.total_max_us` | 100..200 000, et au moins `bas_max_us` | 200 000 | durée totale maximale d'une trame injectée (la borne haute est le défaut : `relu_us` n'est jamais tronqué, section 6.2) |
| `injection.silence_min_us` | 1 000..1 000 000 | 20 000 | silence exigé avant d'émettre : aucun front, bus haut |
| `injection.attente_max_ms` | 10..10 000 | 1 000 | attente maximale de ce silence, puis résultat `delai` |
| `injection.delai_min_ms` | 1 000..60 000 | 3 000 | délai minimal entre deux injections (toutes, avant l'avenant) |
| `injection.arme_max_s` | 10..600 | 600 | désarmement automatique après `injection on` |
| `injection.tol_us` | 1..500 | 20 | tolérance de la surveillance des fronts (délai des étages, mesuré au banc) |

### 4.3 `etat`

Période `periode_ms` (1 000 ms sur l'USB). Quatre blocs.

**Bloc `bus`** :

| Champ | Type | Sens |
|---|---|---|
| `repos` | `haut`, `bas` ou null | niveau du bus lu hors réception (aucun front depuis le silence de fin) ; null s'il n'a jamais été lu |
| `fronts` | entier | fronts de la ligne vus depuis le démarrage (interruption GPIO) |
| `derniere_ms` | entier ou null | âge du dernier front ; null avant le premier |
| `receptions_s` | entier | réceptions pendant la dernière seconde complète |

**Bloc `capture`** :

| Champ | Type | Sens |
|---|---|---|
| `active` | booléen | canal RMT en réception (`capture on`, `capture off`) |
| `mode` | `tout` ou `changements` | |
| `debord` | entier | blocs perdus depuis le démarrage, tampon circulaire plein |
| `rep_en_cours` | entier | mode `changements` : réceptions identiques depuis la dernière émise |

**Bloc `injection`** :

| Champ | Type | Sens |
|---|---|---|
| `montee` | booléen | étage d'injection déclaré monté (`injection monte 1`, NVS) |
| `armee` | booléen | injection armée (`injection on`) ; fausse au démarrage, et d'elle-même après `arme_max_s` |
| `arme_reste_s` | entier 0..600 | secondes avant le désarmement automatique ; 0 si désarmée |
| `derniere` | objet ou null | dernière injection terminée depuis le démarrage : `id` (celui de la commande dans sa session, ou null) et `resultat` (section 6.2) ; null avant la première |

**Bloc `sys`** : un objet `sys` **identique** à celui de la ScreenBar (§5.3,
bloc `sante`) : `heap`, `heap_min`, `heap_bloc`, `pile_boucle`,
`boucle_max_ms`, `json_perdus`, `json_trop_longs`, `rejets`, comptés pour la
session qui reçoit la ligne.

### 4.4 `compteurs`

Période `compteurs_ms` (1 000 ms sur l'USB). Un bloc, `sonde`, de compteurs
cumulés depuis le démarrage (l'app trace des différences) :

| Champ | Sens |
|---|---|
| `receptions` | réceptions commencées (numéro `num` de la dernière) |
| `parties` | parties produites par le découpeur (lignes `trame` possibles) |
| `blocs`, `symboles` | blocs et symboles rendus par le pilote RMT, perdus compris |
| `debord` | blocs perdus, tampon circulaire plein |
| `rep` | mode `changements` : réceptions identiques non émises |
| `lignes_perdues` | lignes machine perdues, toutes sessions (tampon d'émission plein, retard, file pleine) |
| `sautes` | lignes `trame` non produites, toutes sessions (plafond de 100 par seconde) |
| `rejets` | lignes de l'hôte refusées, toutes origines (`trop_long`, `cadence`, `interdite`) |

Critère 4 du banc (spec §10) : `lignes_perdues`, `debord` et `sautes` à 0.

### 4.5 `hb` et `fin`

Identiques à la ScreenBar §5.6.

### 4.6 `reseau`

Période `reseau_ms` (5 000 ms sur l'USB, 30 000 ms à distance). Un bloc,
`ip`, avec le **schéma de la ScreenBar** (§5.5, bloc `ip`), plus `mdns` et
`wifi`. Il part aussi sur l'USB : l'app y lit l'adresse, le nom et
l'empreinte de la clé avant d'ouvrir une session réseau.

| Champ | Sens |
|---|---|
| `frais_ms` | 0 : les valeurs sont lues à la production de la ligne |
| `srp` | toujours null : pas de SRP, le nom se résout en mDNS (`mdns.nom`) |
| `adresses` | l'adresse IPv4 de la station (`type` `autre`, `pref` vrai) ; vide sans Wi-Fi |
| `udp.port` | 5480 |
| `udp.ouvert` | socket ouvert : une clé existe, et le Wi-Fi a eu une adresse depuis le démarrage |
| `udp.empreinte` | empreinte de la clé (section 9.3), null sans clé |
| `udp.sessions`, `udp.provisoire` | sessions H1 établies (0..2), poignée de main en cours |
| `udp.rx`, `udp.rejets`, `udp.rx_perdus`, `udp.defis` | messages acceptés ; datagrammes refusés en silence (forme, clé, sid, MAC, rejeu, limite des `DEFI`) ; perdus avant lecture (plus de 256 octets, erreur de lwIP) ; `DEFI` émis |
| `udp.tx`, `udp.tx_perdus`, `udp.tx_erreurs` | datagrammes remis à lwIP ; perdus après leur mise en file (4 s sans départ, refus durable de lwIP, file vidée par un changement de clé, session partie) ; refus de lwIP (une fois par datagramme). Une ligne qui ne trouve pas de place dans la file compte dans le `json_perdus` de sa session et dans `compteurs.sonde.lignes_perdues` |
| `udp.tampons_libres`, `udp.tampons_min` | toujours null (tampons d'OpenThread : sans objet) |
| `mdns.nom` | `hotte-sonde.local` |
| `wifi.connecte` | station connectée, avec une adresse |
| `wifi.rssi_dbm`, `wifi.ip` | force du signal du point d'accès et adresse IPv4 ; null hors connexion |
| `wifi.canal`, `wifi.pa` | canal du point d'accès (1 à 14) et son empreinte : 4 chiffres hexadécimaux en minuscules, tirés de son BSSID (FNV-1a 32 bits replié sur 16 bits). Deux points d'accès du même réseau se distinguent sans que leur adresse MAC sorte de la sonde ; null hors connexion. Ajout du 09/11/2026 : absents des captures antérieures |
| `wifi.balayage` | balayage fait une fois au démarrage, avant la première connexion (actif, tous les canaux, 120 ms par canal). `vus` : points d'accès captés, tous réseaux confondus (255 au plus) ; `points` : ceux du réseau de la sonde, 4 au plus, du plus fort au plus faible, chacun avec `canal`, `pa` (même empreinte que `wifi.pa`) et `rssi_dbm`. Dit ce que la sonde voyait quand elle a choisi son point d'accès (banc 21 : sur batterie, elle rejoignait parfois un point d'accès lointain). null sans balayage (identifiants absents, échec) ; admis hors connexion. Ajout du 10/11/2026 : absent des captures antérieures |
| `wifi.pertes` | connexions perdues depuis le démarrage |

Pire cas : environ 785 octets.

## 5. Commandes de l'app

Même forme que la ScreenBar §6 : texte de la console préfixé par `id=<n> `.

| Commande avec `id` | Déroulement | Messages |
|---|---|---|
| famille `json` | comme la ScreenBar | lignes produites, puis `reponse` `fin` |
| `capture on\|off\|tout\|changements`, `seuils <filtre_us> [silence_us] [resol_hz]` | **sans texte** : la réponse porte le résultat | `reponse` `fin` : `ok` (avec un `msg` si le mode n'a pas pu être écrit en NVS), `usage` (mot inconnu ou valeur hors bornes, avec `msg`) ou `refuse` (RMT ou NVS en échec) ; puis `config` après `tout`, `changements` et `seuils` |
| `injection on\|off`, `injection monte 0\|1`, `injection regle <nom> <valeur>` | **sans texte** (section 5.1) | `reponse` `fin` : `ok` (`on` porte un `msg`), `usage` (avec `msg`) ou `refuse` (`on` sans étage monté, NVS en échec) ; puis `config` après `monte` et `regle` |
| `injecte durees <d1> <d2> ...` | **asynchrone**, sans texte (section 5.1) | `reponse` `fin` tout de suite : `accepte` avec `suite` = `injection`, ou `refuse` (`msg` : `non montee`, `non armee`, `delai minimal`), ou `usage` (syntaxe, bornes) ; puis, si acceptée, l'événement `injection` avec le même `id` (section 6.2) |
| toute autre commande (`info`, `bus`, `stats`, `help`, `seuils` seul, `injection` seul...) | inchangée : texte humain | `reponse` `debut`, le texte, puis `reponse` `fin` `execute` (ou `inconnue`) |

Sans `id`, rien ne change : texte humain, aucune `reponse`. `seuils` vérifie
toutes les valeurs **avant** d'écrire en NVS (spec §8.2).

### 5.1 Injection

Spec §8.3 et §8.4. Tous les garde-fous sont dans le firmware.

- **`injecte durees <d1> <d2> ...`** : la seule syntaxe avant l'avenant de
  l'étape 6. Durées en µs, entiers > 0, alternées, la première au niveau
  **bas** du bus ; 64 au plus (et la ligne fait 127 caractères au plus) ;
  chaque durée basse (rang pair) au plus `bas_max_us`, la somme au plus
  `total_max_us`. Sinon `usage`, avec un `msg`.
- **Refus**, dans cet ordre : `non montee` (`injection monte 1` jamais
  envoyé), `non armee`, `delai minimal` (moins de `delai_min_ms` depuis la fin
  de la dernière émission ; une injection encore en attente du silence compte
  aussi).
- **Acceptée** : elle attend le silence (`silence_min_us` sans front, bus
  haut), part en une seule transaction RMT sur GPIO7 (GPIO7 haut = bus tiré
  bas, par Q2), sous la surveillance des fronts de GPIO6, puis l'événement
  `injection` donne le résultat (section 6.2).
- **`injection on`** n'arme que si l'étage est déclaré monté. L'injection est
  désarmée au démarrage, par `injection off`, par `injection monte 0`, et
  d'elle-même après `arme_max_s` (annonce `log` `injection`). Une injection
  en attente du silence n'est pas émise si l'injection est désarmée entre-temps
  (résultat `erreur`).
- **`injection monte 0|1`** et **`injection regle <nom> <valeur>`** (noms :
  les champs de `config.injection`, sauf `gpio`) : USB seulement, vérifiés avant
  la NVS. `injection` seul affiche l'état et les valeurs en texte.
- À distance, seuls `injection on|off` et `injecte ...` passent (section 9.4) ;
  `tools/hotte_udp.py` n'envoie `injection on` qu'après une confirmation tapée
  dans un terminal, la phrase exacte « je suis devant la hotte » (règle 11 de la
  spec) ; sans terminal (script, agent), il refuse.

## 6. Événements

Plafonds par type et par session (au-delà, l'événement n'est pas produit pour
cette session, ne consomme pas de `n`, et le suivant du même type porte
`sautes`) :

| Type | Plafond | Condition |
|---|---|---|
| `trame` | 100 par seconde | `json trames 1` (défaut) |
| `log` | 20 par seconde | `json log 1` |
| `injection` | aucun | toujours ; `id` pour la seule session qui a envoyé la commande |

### 6.1 `trame` : une partie de réception

La sonde ne découpe pas en trames : elle publie des **parties** horodatées de
durées consécutives. Une réception va du premier front jusqu'au silence de
fin ; au-delà de 110 durées, elle part en plusieurs parties au fil de l'eau.
Le découpage en trames se fait sur le Mac (`tools/analyse.py`).

| Champ | Type | Sens |
|---|---|---|
| `num` | entier | numéro de réception depuis le démarrage (à partir de 1) |
| `part` | entier | rang de la partie dans la réception (à partir de 0) |
| `fin` | booléen | dernière partie de la réception |
| `t_us` | entier 64 bits | début de la partie (µs depuis le démarrage) |
| `niv0` | `haut` ou `bas` | niveau **du bus** pendant `dur_us[0]` ; les niveaux alternent ensuite |
| `dur_us` | tableau d'entiers ≥ 1 | 110 durées au plus, en µs ; vide seulement pour clore une réception (`fin`) ou signaler une perte (`debord`) |
| `debord` | booléen | des symboles ont été perdus juste avant cette partie (tampon plein) |
| `rep` | entier, facultatif | mode `changements` : réceptions identiques non émises avant celle-ci |
| `sautes` | entier, facultatif | lignes `trame` non produites (plafond) depuis la précédente produite pour cette session |

Règles :
- **Les parties d'une réception sont produites ou sautées ensemble** : le
  plafond se juge à la première partie vue de chaque réception.
- `t_us` : heure de fin du bloc RMT, moins la somme de ses durées, moins le
  silence si c'est la dernière partie (spec §8.2). La partie suivante d'une
  même réception commence à la fin de la précédente.
- Pire cas : 860 octets (110 durées de 65 534 µs, compteurs au maximum), sous
  le budget de 896 (test hôte `test_json`).

### 6.2 `injection` : fin d'une injection

Suit la `reponse` `accepte` d'un `injecte` : une ligne par demande acceptée,
vers chaque session en mode machine. Seule la session qui a envoyé la commande
reçoit son `id`, même hors mode machine si la commande en portait un ; les
autres voient `id` null (mêmes règles que la `livraison` de la ScreenBar §7.3).
Une commande de la console sans `id`, en mode humain, reçoit le résultat en
texte : `injection : ok, attente 412 us ; emises 750 750 750 2250 ; relues 752 748 751`.

| Champ | Type | Sens |
|---|---|---|
| `id` | entier ou null | id de la commande dans la session qui l'a envoyée ; null dans les autres sessions, et pour une commande de la console sans id |
| `cmd` | chaîne, 40 caractères au plus | la commande |
| `resultat` | `ok`, `collision`, `delai`, `erreur` | voir ci-dessous |
| `niv0` | `bas` | niveau du bus pendant `dur_us[0]` (toujours `bas` avec `injecte durees`) |
| `dur_us` | tableau de 1 à 64 entiers | durées demandées, en µs : émises en entier si `ok`, jusqu'à l'arrêt si `collision`, pas du tout si `delai` ou `erreur` |
| `attente_us` | entier | de l'acceptation au début de l'émission (ou à l'abandon) |
| `relu_us` | tableau de 64 entiers au plus | durées entre fronts successifs lus sur GPIO6 pendant l'émission, depuis son premier front : n − 1 valeurs pour n durées en nombre pair (le dernier palier haut se fond dans le repos), n en nombre impair ; vide si rien n'a été émis |

Résultats :
- **`ok`** : émise en entier, sans front anormal. Sans aucune durée relue, un
  `log` `injection` le signale (étage d'injection, ligne ou étage d'écoute à
  vérifier).
- **`collision`** : un front anormal pendant l'émission (le bus change de
  niveau loin de tout front programmé, à `tol_us` près, vers un autre niveau
  que celui émis), ou un premier front qui n'est pas celui de l'émission (vers
  le haut, ou plus de 500 µs après le départ). L'émission est arrêtée tout de
  suite (`rmt_disable`) et GPIO7 revient à l'état bas ; `relu_us` s'arrête au
  front anormal.
- **`delai`** : le bus ne s'est pas tu dans `attente_max_ms` ; rien n'est émis.
- **`erreur`** : rien n'est émis, ou l'émission n'a pas pu finir (RMT
  indisponible, interruption des fronts absente, injection désarmée ou étage
  déclaré démonté pendant l'attente du silence) ; un `log` `injection` en
  donne la cause.

La trame injectée est aussi capturée comme toute trame du bus (`trame`,
section 6.1) : c'est ainsi qu'on « retrouve la trame sur le bus » (spec §6,
étape 7). La ligne tient le budget de 896 octets : à la borne haute de
`total_max_us` (200 000 µs), une commande `injecte` de 64 durées garde toutes
ses durées relues (test hôte `test_json`). `relu_us` ne serait coupé qu'au-delà
du budget, ce qu'aucune commande acceptée n'atteint.

### 6.3 `log` : annonces du firmware

Comme la ScreenBar §7.10, avec `src` = `sonde`, `capture`, `injection` ou
`reseau`, et `niv` = `notice` ou `trace`. Les modules y passent leurs
annonces par `jsonLog()` (Wi-Fi, injection : avec eux) ; sans `json log 1`,
elles restent du texte.

Une annonce part sans `json log 1` : si des réglages lus en NVS au démarrage
étaient hors bornes (remplacés par leur valeur par défaut, spec §8.2), chaque
ouverture de session (`json 1`) le dit par un `log` `sonde` `notice`, après
l'instantané et sa réponse, hors plafond (exemple en 8.3). Le texte
`[reglages] ...` du démarrage part en général avant que l'app n'ouvre le port.

## 7. Débit sur l'USB

| Situation | Débit |
|---|---|
| Au repos (`etat` et `compteurs` à 1 Hz, tailles de la section 8) | ~0,7 Ko/s |
| Trames de type WTC (une réception de 33 durées toutes les 100 ms, 258 octets par ligne) | + ~2,6 Ko/s |
| Plafond des trames (100 lignes pleines par seconde) | + ~86 Ko/s |

L'USB full-speed n'est pas le goulot : ce sont le tampon de 8 Ko et la
lecture du Mac. Une ligne perdue se voit à un trou de `n` et dans
`lignes_perdues`.

## 8. Exemples

`<RS>` note l'octet 0x1E ; le LF final est omis. Chaque ligne `<RS>{...}` est
vérifiée par `json_check.py --strict --exemples`.

### 8.1 Connexion

App → sonde (`\x15` : l'octet 0x15, Ctrl-U, suivi de LF) :

```
\x15
id=1 json 1
```

Sonde → app :

```
<RS>{"v":1,"t":"hello","n":0,"ms":12031,"bloc":"base","rev":4,"fw":"0.1.0-1a2b3c4","fw_desc":"0.1.0-1a2b3c4","date":"Sep 27 2026","heure":"14:02:11","env":"sonde","build":"sonde","reseau_build":"aucun","puce":"esp32c6","idf":"v5.5.5","arduino":"3.3.12","boot":"3FA2C901","reset":"mise_sous_tension","reset_n":1,"up_s":12,"session":{"transport":"usb","periode_ms":1000,"compteurs_ms":1000,"reseau_ms":5000,"bail_s":30,"trames":true,"log":false},"limites":{"ligne_max":1024,"cmd_max":127}}
<RS>{"v":1,"t":"hello","n":1,"ms":12032,"bloc":"identite","boot":"3FA2C901","mac":"F0F5BD012345","id":{"fabricant":"Djoko-CLI","produit":"Sonde hotte Haier","serie":"HOTTE-F0F5BD012345","nom":"Sonde hotte","hw":1,"hw_txt":"C6 SuperMini, etages v1"},"appareil":"hotte","caps":["sonde","injection","trames","log","udp","cle","mdns"]}
<RS>{"v":1,"t":"config","n":2,"ms":12033,"capture":{"gpio":6,"resol_hz":1000000,"filtre_us":1,"silence_us":5000,"mode":"tout","inverse":true},"injection":{"gpio":7,"bas_max_us":3000,"total_max_us":200000,"silence_min_us":20000,"attente_max_ms":1000,"delai_min_ms":3000,"arme_max_s":600,"tol_us":20}}
<RS>{"v":1,"t":"etat","n":3,"ms":12034,"bloc":"bus","boot":"3FA2C901","up_s":12,"repos":"haut","fronts":1520,"derniere_ms":3,"receptions_s":10}
<RS>{"v":1,"t":"etat","n":4,"ms":12035,"bloc":"capture","boot":"3FA2C901","up_s":12,"active":true,"mode":"tout","debord":0,"rep_en_cours":0}
<RS>{"v":1,"t":"etat","n":5,"ms":12036,"bloc":"injection","boot":"3FA2C901","up_s":12,"montee":false,"armee":false,"arme_reste_s":0,"derniere":null}
<RS>{"v":1,"t":"etat","n":6,"ms":12037,"bloc":"sys","boot":"3FA2C901","up_s":12,"sys":{"heap":247812,"heap_min":241600,"heap_bloc":110580,"pile_boucle":5316,"boucle_max_ms":2,"json_perdus":0,"json_trop_longs":0,"rejets":0}}
<RS>{"v":1,"t":"compteurs","n":7,"ms":12038,"bloc":"sonde","receptions":118,"parties":118,"blocs":118,"symboles":1947,"debord":0,"rep":0,"lignes_perdues":0,"sautes":0,"rejets":0}
<RS>{"v":1,"t":"reseau","n":8,"ms":12039,"bloc":"ip","frais_ms":0,"srp":null,"adresses":[{"adr":"192.0.2.42","type":"autre","pref":true}],"udp":{"port":5480,"ouvert":true,"empreinte":"630DCD29","sessions":0,"provisoire":false,"rx":0,"rejets":0,"rx_perdus":0,"defis":0,"tx":0,"tx_perdus":0,"tx_erreurs":0,"tampons_libres":null,"tampons_min":null},"mdns":{"nom":"hotte-sonde.local"},"wifi":{"connecte":true,"rssi_dbm":-58,"ip":"192.0.2.42","canal":6,"pa":"3f2a","pertes":0,"balayage":{"vus":7,"points":[{"canal":6,"pa":"3f2a","rssi_dbm":-58},{"canal":1,"pa":"9c1e","rssi_dbm":-88}]}}}
<RS>{"v":1,"t":"reponse","n":9,"ms":12040,"id":1,"etape":"fin","cmd":"json 1","ok":true,"code":"ok","duree_ms":9,"bail_s":30,"up_s":12}
```

Puis `etat` et `compteurs` chaque seconde, `reseau` toutes les 5 s, et les
`trame`.

### 8.2 Trames

Une réception courte, d'une partie (motif `wtc` du banc : départ de 2T bas,
16 bits, T = 750 µs ; le dernier 1T haut se fond dans le repos) :

```
<RS>{"v":1,"t":"trame","n":214,"ms":15506,"num":57,"part":0,"fin":true,"t_us":15472110,"niv0":"bas","dur_us":[1500,749,751,748,748,752,748,750,752,748,752,749,748,748,751,751,2248,749,748,752,751,748,752,748,749,752,748,752,752,751,748,749,748],"debord":false}
```

Une longue réception (motif `rafale` : un front toutes les 100 µs) part en
parties de 110 durées, sans `fin` jusqu'au silence :

```
<RS>{"v":1,"t":"trame","n":301,"ms":16020,"num":61,"part":0,"fin":false,"t_us":16003300,"niv0":"haut","dur_us":[102,99,100,101,99,102,98,102,100,102,99,98,102,102,99,100,98,102,98,102,98,102,99,101,102,101,100,101,102,101,100,100,99,99,99,98,102,100,102,101,100,101,100,102,98,98,102,101,99,100,99,101,101,98,98,102,102,100,100,100,102,101,102,101,98,98,100,101,98,98,100,102,101,100,101,100,98,101,100,99,102,98,101,98,99,100,99,99,101,101,101,98,99,101,101,102,100,99,101,102,100,101,100,101,99,99,98,99,99,99],"debord":false}
```

Mode `changements` : douze réceptions identiques n'ont pas été émises avant
celle-ci. Plus loin, 37 lignes ont été sautées (plafond de 100 par seconde),
et un bloc a été perdu juste avant la partie :

```
<RS>{"v":1,"t":"trame","n":420,"ms":31002,"num":190,"part":0,"fin":true,"t_us":30975310,"niv0":"bas","dur_us":[1500,750,750,750,2250,751],"debord":false,"rep":12}
<RS>{"v":1,"t":"trame","n":988,"ms":52001,"num":4102,"part":0,"fin":false,"t_us":51990112,"niv0":"haut","dur_us":[100,101,99,100],"debord":true,"rep":0,"sautes":37}
```

### 8.3 Réglages de capture

```
id=2 capture changements
id=3 seuils 2 40000
```

```
<RS>{"v":1,"t":"reponse","n":502,"ms":40002,"id":2,"etape":"fin","cmd":"capture changements","ok":true,"code":"ok","duree_ms":14}
<RS>{"v":1,"t":"config","n":503,"ms":40003,"capture":{"gpio":6,"resol_hz":1000000,"filtre_us":1,"silence_us":5000,"mode":"changements","inverse":true},"injection":{"gpio":7,"bas_max_us":3000,"total_max_us":200000,"silence_min_us":20000,"attente_max_ms":1000,"delai_min_ms":3000,"arme_max_s":600,"tol_us":20}}
<RS>{"v":1,"t":"reponse","n":510,"ms":40410,"id":3,"etape":"fin","cmd":"seuils 2 40000","ok":false,"code":"usage","msg":"seuils : silence 40000 us hors bornes a 1000000 Hz (1000..32767)","duree_ms":0}
```

Une valeur hors bornes lue en NVS au démarrage (écrite par un autre firmware,
par exemple) est remplacée par sa valeur par défaut. Chaque `json 1` le dit
ensuite, juste après sa réponse, même sans `json log 1` :

```
<RS>{"v":1,"t":"log","n":1208,"ms":305012,"src":"sonde","niv":"notice","txt":"1 valeur(s) hors bornes en NVS : valeurs par defaut"}
```

### 8.4 Commande à texte, refus

```
id=4 stats
```

```
<RS>{"v":1,"t":"reponse","n":530,"ms":42002,"id":4,"etape":"debut","cmd":"stats","ok":true,"code":"en_cours"}
receptions 1204, parties 1204, blocs 1204, symboles 20468, debord 0 (blocs perdus, tampon plein)
<RS>{"v":1,"t":"reponse","n":531,"ms":42003,"id":4,"etape":"fin","cmd":"stats","ok":true,"code":"execute","duree_ms":1}
<RS>{"v":1,"t":"reponse","n":588,"ms":43010,"id":25,"etape":"fin","cmd":"json ping","ok":false,"code":"cadence","msg":"plus de 20 lignes par seconde : rien n'est execute","duree_ms":0}
```

### 8.5 Mode `log`, battement, fin de session

Après `id=5 json log 1`, `id=6 json periode 0` et `id=7 json compteurs 0`
(battement `hb` toutes les 2 s), l'app se tait ; 30 s après sa dernière ligne,
le bail rend le mode humain.

```
<RS>{"v":1,"t":"log","n":640,"ms":200100,"src":"capture","niv":"notice","txt":"[capture] echec du RMT ('capture on' pour reessayer)"}
<RS>{"v":1,"t":"hb","n":641,"ms":202000,"boot":"3FA2C901","up_s":202,"json_perdus":0}
<RS>{"v":1,"t":"fin","n":662,"ms":231400,"cause":"bail"}
json : mode machine coupe (hote muet depuis 30 s)
>
```

### 8.6 Injection

Par l'USB, étage monté (au banc, tâche 24) ; `injection monte 1` a été envoyé
une fois (NVS) :

```
id=40 injection on
id=41 injecte durees 750 750 750 2250
id=42 injecte durees 750
```

L'injection est armée pour 600 s. La première demande est acceptée ; le bus est
au repos, elle part aussitôt. Ses trois premiers paliers sont relus (le dernier,
haut, se fond dans le repos), puis la capture rend la même trame. La seconde
arrive dans les 3 s : délai minimal.

```
<RS>{"v":1,"t":"reponse","n":898,"ms":122500,"id":40,"etape":"fin","cmd":"injection on","ok":true,"code":"ok","msg":"injection armee pour 600 s ('injection off' pour desarmer)","duree_ms":0}
<RS>{"v":1,"t":"reponse","n":900,"ms":123001,"id":41,"etape":"fin","cmd":"injecte durees 750 750 750 2250","ok":true,"code":"accepte","duree_ms":0,"suite":"injection"}
<RS>{"v":1,"t":"injection","n":901,"ms":123006,"id":41,"cmd":"injecte durees 750 750 750 2250","resultat":"ok","niv0":"bas","dur_us":[750,750,750,2250],"attente_us":412,"relu_us":[752,748,751]}
<RS>{"v":1,"t":"trame","n":902,"ms":123011,"num":2204,"part":0,"fin":true,"t_us":123001455,"niv0":"bas","dur_us":[751,749,751],"debord":false}
<RS>{"v":1,"t":"etat","n":903,"ms":124000,"bloc":"injection","boot":"3FA2C901","up_s":124,"montee":true,"armee":true,"arme_reste_s":599,"derniere":{"id":41,"resultat":"ok"}}
<RS>{"v":1,"t":"reponse","n":905,"ms":124100,"id":42,"etape":"fin","cmd":"injecte durees 750","ok":false,"code":"refuse","msg":"injecte : delai minimal (3000 ms entre deux injections)","duree_ms":0}
```

Collision (critère 5 du banc) : le générateur tire la ligne 500 µs toutes les
50 ms ; son impulsion tombe dans le second palier haut de 20 ms. L'émission
s'arrête au front anormal : la dernière impulsion basse n'est jamais émise.
Puis une demande pendant un trafic continu (motif `wtc`, pauses de 6 ms) :
aucun silence de 20 ms en 1 s. Une autre session, ouverte en même temps, voit
la même injection sans son `id`.

```
<RS>{"v":1,"t":"injection","n":1210,"ms":161052,"id":43,"cmd":"injecte durees 500 20000 500 20000 500","resultat":"collision","niv0":"bas","dur_us":[500,20000,500,20000,500],"attente_us":19630,"relu_us":[502,19998,503,8012]}
<RS>{"v":1,"t":"injection","n":1388,"ms":170230,"id":44,"cmd":"injecte durees 1000","resultat":"delai","niv0":"bas","dur_us":[1000],"attente_us":1000204,"relu_us":[]}
<RS>{"v":1,"t":"injection","n":77,"ms":161052,"id":null,"cmd":"injecte durees 500 20000 500 20000 500","resultat":"collision","niv0":"bas","dur_us":[500,20000,500,20000,500],"attente_us":19630,"relu_us":[502,19998,503,8012]}
```

Refus : sans `injection on`, et `injection regle` à distance (USB seulement) :

```
<RS>{"v":1,"t":"reponse","n":52,"ms":95012,"id":8,"etape":"fin","cmd":"injecte durees 750 750","ok":false,"code":"refuse","msg":"injecte : non armee ('injection on')","duree_ms":0}
<RS>{"v":1,"t":"reponse","n":53,"ms":95230,"id":9,"etape":"fin","cmd":"injection regle tol_us 30","ok":false,"code":"interdite","msg":"interdite a distance (10.5) : USB seulement","duree_ms":0}
```

## 9. Transport réseau : UDP sur le Wi-Fi

Par différence avec la ScreenBar §10 (UDP sur Thread). Client de banc :
`tools/hotte_udp.py` (clé par l'USB, session, enregistrement).

### 9.1 Chemin et découverte

- La sonde est une **station Wi-Fi** (`src/net_wifi.*`). Les identifiants se
  posent par `wifi <ssid> <mdp>`, par l'USB seulement ; ils sont vérifiés avant
  d'être écrits dans l'espace NVS `hotte` (clés `wifi_ssid` et `wifi_mdp`). Le
  modem ne dort jamais (`WiFi.setSleep(false)`, spec §8.7). Tant que la
  connexion manque, nouvel essai toutes les 10 s. Sans identifiants, la radio
  reste éteinte.
- **IPv4** en v1. Le Mac joint la sonde par son nom mDNS,
  **`hotte-sonde.local`** (cap `mdns`, `reseau.ip.mdns.nom`), ou par son
  adresse (`reseau.ip.wifi.ip`, commande `info`). Pas de SRP : `srp` vaut null.
- Les annonces du Wi-Fi (connexion, perte) partent en `log`, `src` `reseau`,
  avec `json log 1` ; sinon en texte sur l'USB.

### 9.2 Datagrammes

- Port **5480**, socket UDP de lwIP (`src/net_udp_wifi.*`). Il s'ouvre dès
  qu'une clé existe et que le Wi-Fi a une adresse, puis reste ouvert tant que
  la clé existe. Sans clé, lwIP répond « port injoignable ».
- Un message = un datagramme : en-tête H1 puis l'objet JSON seul (sans RS ni
  LF), ou la ligne de commande de l'app. 1 078 octets au plus (56 + 1 022),
  sous la MTU de 1 500 du Wi-Fi. La sonde jette tout datagramme reçu de plus
  de 256 octets (`udp.rx_perdus`).
- Tout se passe dans la tâche `loop` : lecture non bloquante (4 datagrammes par
  tour au plus ; lwIP en garde 6 en attente), commandes, émission. `h1::Peer`
  porte l'adresse de l'app en IPv4 mappée (`::ffff:a.b.c.d`).
- Émission : file de **32 datagrammes**, partagée par les sessions, remis à
  lwIP sans attente, 4 par tour au plus.
  - Débit moyen plafonné à **50 000 octets/s**, crédit de **8 192**.
  - Pas partis en 4 s (Wi-Fi coupé) : perdus et comptés (`udp.tx_perdus`).
  - File pleine : la ligne est perdue et comptée (`json_perdus`,
    `lignes_perdues`), jamais attendue.
  - Le `DEFI` d'une poignée de main passe en tête, hors plafond.
- Un événement fréquent (`trame`, `log`) vers une session réseau n'est produit
  que s'il reste deux datagrammes libres : la place d'une ligne périodique ou
  d'une réponse après lui. Sinon, il est perdu (trou de `n`, `lignes_perdues`).
- Le reste est **identique** à la ScreenBar §10.2 :
  - `id` strictement croissants dans une session H1 ;
  - les 8 dernières `reponse` gardées par session ; un `id` renvoyé est servi
    depuis ce cache, sans nouvelle exécution ; un `id` déjà traité reçoit
    `deja_traite` ;
  - 6 s de retard admis dans la file des périodiques ; sessions servies à tour
    de rôle.

### 9.3 Authentification

**Enveloppe H1 identique** à la ScreenBar §10.4 : poignée de main `SALUT` /
`DEFI`, HMAC-SHA256, 2 sessions établies et une provisoire, fenêtre de 32,
2 `DEFI` par seconde au plus, oubli après 10 min, place libérée par `json 0`.
Code : `src/h1_proto.*` et `src/h1_crypto.cpp`, copiés tels quels.

Écarts :
- la clé est gardée en NVS dans l'espace **`hotte`**, clé **`cle`** (32
  octets) ;
- elle se crée par `id=<n> json cle nouvelle <64 hexa>`, **par l'USB
  seulement**. Sur le Mac, `python3 tools/hotte_udp.py cle <port>` le fait et
  range la clé dans `~/.config/hotte-sonde/cle` (droits 0600), sans jamais
  l'afficher : seule l'empreinte l'est ;
- ni trousseau, ni effacement à une remise à zéro Matter (pas de Matter).
  `json cle efface` coupe le transport.

Vecteurs : les mêmes que la ScreenBar §10.4, `tools/tests/test_h1.cpp` et
`tools/tests/test_hotte_udp.py`.

```
PSK  000102030405060708090A0B0C0D0E0F101112131415161718191A1B1C1D1E1F
kid  630DCD29
na   A0A1A2A3A4A5A6A7A8A9AAABACADAEAF      nc  505152535455565758595A5B5C5D5E5F      sid 1234ABCD
SALUT  H1 SALUT 630DCD29 A0A1A2A3A4A5A6A7A8A9AAABACADAEAF 52D853E3FFE9E9CCEFFA98BB5304B32D
DEFI   H1 DEFI 1234ABCD 505152535455565758595A5B5C5D5E5F BFF13F71B42243E6017D2807F8E6171F
Ks   20D6D83D97ED44F2BBF8CE56389BD475CBE2B625CE6CE24768B6B4C1C625012F
A 1  H1 1234ABCD 1 FD97A0C9E604524B49C763452D0310CE id=1 json 1
C 1  H1 1234ABCD 1 347A2E6A129BC822ECFF39BEC910451C {"v":1,"t":"hb","n":7,"ms":1234}
```

### 9.4 Commandes à distance : liste blanche

Toute ligne reçue par le réseau porte un `id` ; sans lui, elle est ignorée et
comptée dans `rejets`. Sont autorisées (`jsonp::remoteRefusal`,
`src/json_out.cpp`) :
- `json 1 [bail 10..120]`, `json 0`, `json etat`, `json hello`, `json ping` ;
- `json periode 2000..60000`, `json compteurs 0|1000..60000`,
  `json reseau 0|10000..60000`, `json trames 0|1`, `json log 0|1` ;
- `capture on|off|tout|changements`, `seuils <valeurs>` (bornés, sans texte) ;
- `injection on|off`, `injecte ...` (section 5.1).

Tout le reste reçoit la `reponse` `interdite`, et rien n'est exécuté : en
particulier `json` seul, `json cle ...`, `wifi`, `injection` seul,
`injection monte`, `injection regle`, `reboot`, `bus`, `stats`, `info` et
`help`.

### 9.5 Profil distant

Il s'écarte volontairement de la ScreenBar §10.6 (spec §8.5) : ici, le Wi-Fi a
de la marge, et les trames sont la raison d'être de la sonde.

| Réglage | USB | UDP (Wi-Fi) |
|---|---|---|
| `periode_ms` (`etat`) | 1 000 | 2 000 |
| `compteurs_ms` | 1 000 | 5 000 |
| `reseau_ms` | 5 000 | 30 000 |
| `trames` après `json 1` | oui | oui, sans coupure automatique |
| plafond des `trame` | 100 par seconde | 100 par seconde, puis `sautes` |
| file d'émission | tampon de 8 Ko | 32 datagrammes, 50 000 octets/s, crédit de 8 192 |

`hello.base.session.transport` vaut `udp`. Débit : moins d'un Ko/s au repos ;
motif `krona` du banc (`seuils 1 19000`, une quinzaine de lignes `trame` de
~250 octets par seconde) : ~4 Ko/s. Au plafond des trames (100 lignes pleines
par seconde, ~86 Ko/s), la file se remplit : les lignes en trop sont perdues et
comptées.

### 9.6 Exemples

Datagrammes, en texte (l'en-tête H1, puis la charge) :

```
app   -> sonde : H1 SALUT 630DCD29 A0A1A2A3A4A5A6A7A8A9AAABACADAEAF 52D853E3FFE9E9CCEFFA98BB5304B32D
sonde -> app   : H1 DEFI 1234ABCD 505152535455565758595A5B5C5D5E5F BFF13F71B42243E6017D2807F8E6171F
app   -> sonde : H1 1234ABCD 1 FD97A0C9E604524B49C763452D0310CE id=1 json 1
sonde -> app   : H1 1234ABCD 1 <mac> {"v":1,"t":"hello","n":0,...}
```

Objets portés par les datagrammes de la sonde, notés comme des lignes machine
pour être vérifiés : le `hello` d'une session réseau, un refus de la liste
blanche, un `id` déjà traité.

```
<RS>{"v":1,"t":"hello","n":0,"ms":80210,"bloc":"base","rev":4,"fw":"0.1.0-1a2b3c4","fw_desc":"0.1.0-1a2b3c4","date":"Sep 27 2026","heure":"14:02:11","env":"sonde","build":"sonde","reseau_build":"aucun","puce":"esp32c6","idf":"v5.5.5","arduino":"3.3.12","boot":"3FA2C901","reset":"mise_sous_tension","reset_n":1,"up_s":80,"session":{"transport":"udp","periode_ms":2000,"compteurs_ms":5000,"reseau_ms":30000,"bail_s":30,"trames":true,"log":false},"limites":{"ligne_max":1024,"cmd_max":127}}
<RS>{"v":1,"t":"reponse","n":41,"ms":95002,"id":6,"etape":"fin","cmd":"reboot","ok":false,"code":"interdite","msg":"interdite a distance (10.5) : USB seulement","duree_ms":0}
<RS>{"v":1,"t":"reponse","n":42,"ms":95510,"id":4,"etape":"fin","cmd":"json ping","ok":false,"code":"deja_traite","msg":"id deja traite (reponse plus disponible) : rien n'est reexecute","duree_ms":0}
```

Clé, par l'USB (`tools/hotte_udp.py cle` : l'aléa de l'app n'est jamais
renvoyé, la clé ne part qu'une fois) :

```
id=900417 json cle nouvelle 5A0C...(64 hexa)
```

```
<RS>{"v":1,"t":"reponse","n":12,"ms":5012,"id":900417,"etape":"fin","cmd":"json cle nouvelle","ok":true,"code":"ok","msg":"nouvelle cle : les sessions reseau tombent","duree_ms":3,"cle":"000102030405060708090A0B0C0D0E0F101112131415161718191A1B1C1D1E1F","empreinte":"630DCD29"}
<RS>{"v":1,"t":"reponse","n":13,"ms":5230,"id":900418,"etape":"fin","cmd":"json cle","ok":true,"code":"ok","duree_ms":0,"empreinte":"630DCD29"}
```
