Djoko-cli/haier-cchp21ebb-hotte-matter/docs/AJOUTS-RECONNAISSANCE.md

# Ajouts à la reconnaissance (a) à (d) et correction F1, prêts à insérer

**Versé le 29/09/2026** dans SPEC-RECONNAISSANCE.md, RECONNAISSANCE.md et
SECURITE.md : ce sont eux qui font foi désormais. F1 était déjà appliqué dans
WIRING.md ; D4 est retiré par l'amendement.

28/09/2026, revu le 28/09 au soir. Ajouts approuvés par l'utilisateur : (a) marche
prolongée, (b) arrêt de l'étape 7, (c) repos de 60 s, (d) mesure sans risque.
**L'amendement de l'utilisateur du 28/09 au soir réduit (d) à la mesure radio
comparative M1** : le relevé de température en cuisson (l'ancienne M2) et
l'achat du thermomètre sont retirés. S'y ajoute une correction factuelle liée,
confirmée par l'utilisateur le 29/09 : le repérage de la SuperMini violette dans WIRING.md
(F1).

## 0. Mode d'emploi

- **Fichiers visés :** `docs/SPEC-RECONNAISSANCE.md` (« SPEC »),
  `docs/RECONNAISSANCE.md` (« JOURNAL »), `docs/SECURITE.md` (« FICHE ») et
  `docs/WIRING.md` (« WIRING »).
- **Numéros de ligne :** ceux du commit `efdece4`. Chaque bloc cite aussi sa
  ligne d'ancrage mot pour mot : c'est elle qui fait foi.
- **Ordre d'application :** dans chaque fichier, du bas vers le haut, pour que
  les numéros restent justes. Sinon, on se fie aux ancres citées. Quand deux blocs
  visent le même endroit, l'ordre est indiqué (« juste après le bloc X »).
- **« Insérer après »** ajoute le texte sans rien retirer. **« Remplacer »**
  retire les lignes citées et met le texte donné à leur place.
- Les numéros des nouvelles lignes suivent l'usage du journal (`6b`, `8a`,
  `a1`). L'étape 5 garde ses numéros 8 et 9.
- **SPEC fait foi** : chaque règle nouvelle y figure, et la FICHE la reprend.

| Bloc | Fichier | Endroit |
|---|---|---|
| A1 | SPEC | §6, nouvelle étape −1b, après la ligne 269 |
| A2 | JOURNAL | nouvelle étape −1b, après la ligne 113 |
| A3 | SPEC | §6, étape 5 : ligne 470 remplacée, puis scénario 7b après la ligne 477 |
| A4 | JOURNAL | étape 5 : ligne 429 remplacée, lignes 7b1 à 7b5 après la ligne 446 |
| A5 | SPEC | §6, étape 6 : test 6, juste après le bloc C3 |
| A6 | JOURNAL | étape 6 : ligne 9 du tableau, juste après le bloc C4 |
| A7 | SPEC | §1, « Hors périmètre », ligne 65 remplacée |
| B1 à B4 | SPEC | §1 (lignes 52-55), étape 5 (ligne 476), étape 6 (après la ligne 539), étape 7 (ligne 562) |
| B5 à B8 | JOURNAL | étape 5 (ligne 444), avenant (après la ligne 567), étape 7 (après les lignes 612 et 621), critères de sortie (lignes 652-654) |
| C1 | SPEC | §6, étape 5 : scénario 7c, juste après le bloc A3 |
| C2 | JOURNAL | étape 5 : lignes 7c1 et 7c2, juste après le bloc A4 |
| C3 | SPEC | §6, étape 6 : test 5, après la ligne 528 |
| C4 | JOURNAL | étape 6 : ligne 8 du tableau, après la ligne 525 |
| AC | JOURNAL | étape 5 : commandes des lignes 7b et 7c, après la ligne 449 |
| D1 | SPEC | §6, mesure M1, après la ligne 578 |
| D2 | SPEC | §5, règles 3 (après la ligne 175) et 13 (après la ligne 230) |
| D3 | SPEC | §1, « Hors périmètre », ligne 62 remplacée |
| D5 | JOURNAL | « Installation et instruments », après la ligne 33 |
| D6 | JOURNAL | nouvelle section M1, après la ligne 643 |
| D7 | FICHE | règles 3 (après la ligne 35) et 13 (après la ligne 86), liste avant mise sous tension (après la ligne 111) |
| E1 à E3 | SPEC | statut (après la ligne 8), §13 (après la ligne 1041), §14 (après la ligne 1052) |
| F1 | WIRING | **appliqué le 29/09**, sous une forme plus complète : nouveau §9 de WIRING.md |

L'amendement du 28/09 au soir retire le bloc D4 (achat du thermomètre) et la
partie M2 des blocs D1, D2, D5, D6 et D7, dont l'ajout au test du différentiel.
Les autres numéros ne changent pas.

---

## (a) Marche prolongée

Ce que l'on sait déjà (JOURNAL, étape −1, ligne 3) : en V3, « marche » moteur
tournant lance 15 min de marche prolongée, avec ⏻ qui clignote à 1 Hz ; la
vitesse active l'interrompt (retour à l'état armé). Ce qui manque : sa fin
(état final, bip, voyant, trame), « marche » et une autre vitesse pendant la
prolongation, et les trames de toutes ces transitions.

Deux temps :
- **étape −1b** (A1, A2) : observation sans montage, faisable tout de suite.
  L'automate `hotte_etat` (point 2 de l'ordre de l'utilisateur) a besoin de ces
  transitions avant l'étape 5 ;
- **étape 5, scénario 7b** (A3, A4) : les trames des mêmes transitions.

### A1. SPEC, §6 : nouvelle étape −1b

**Insérer après la ligne 269 :** `**Sortie :** le tableau des comportements est rempli dans `RECONNAISSANCE.md`.`
(avant la ligne 271, `### Étape 0 : photos, inventaire et cheminements`) :

````markdown

### Étape −1b : marche prolongée (ajout du 28/09)

- **État de la hotte :** en usage normal, fermée. L'adaptateur peut être en
  place, `J1` fermé.
- **Outils :** un téléphone qui filme le panneau, avec le son ; un chronomètre.

Elle complète les points 3 et 4 de l'étape −1. **Départ de chaque essai :**
hotte éteinte, puis « marche », V2, et, 10 s après, « marche » moteur tournant :
la marche prolongée commence (⏻ clignote). Relever :

11. **Sa fin**, lampe allumée avant le départ, sans rien toucher : au bout de
    combien de temps ? Quel état final (moteur, ⏻, voyant de vitesse, lampe) ?
    Un bip ?
12. **Une touche 5 s après le début de la prolongation**, une par essai : la
    vitesse active (vue le 27/09 : retour à l'état armé), « marche », puis une
    autre vitesse (V3).

Entre deux essais, on ramène la hotte à l'état éteint : vitesse active, moteur
arrêté, puis « marche ».

**Sortie :** les transitions de la marche prolongée sont notées dans
`RECONNAISSANCE.md`. L'automate du sous-projet 2 les reprend, et l'étape 5 en
capture les trames (scénario 7b).
````

### A2. JOURNAL : nouvelle étape −1b

**Insérer après la ligne 113 :** `- [x] le tableau des comportements est rempli (27/09 : vidéo pour les lignes 2, 3, 4, 6 et 7, réponses de l'utilisateur pour 1, 5, 8 et 9 ; ligne 10 : 3 s par défaut).`
(avant la ligne 115, `## Étape 0 : photos, inventaire et cheminements`) :

````markdown
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
