Djoko-cli/haier-cchp21ebb-hotte-matter/docs/superpowers/plans/2026-11-04-phase-4-bancs-de-la-sonde.md

# Phase 4 : bancs de la sonde

Feuille de route : [../specs/2026-11-04-feuille-de-route.md](../specs/2026-11-04-feuille-de-route.md).
Le détail de chaque banc est dans sa tâche d'origine (plans de la phase 1, où
elle est marquée « reportée en phase 4 ») ; les résultats vont dans
[BANC.md](../../BANC.md). Aucune liaison avec la hotte.

### Tâche 1 : Préparer le banc (FABRICATION §5.4 et §10)

- [x] Générateur prêt : nanoESP32-C6 (MUSE LAB) en attendant une SuperMini, barrettes soudées, firmware `generateur` flashé, console vérifiée (04/11)
- [x] Banc de la tâche 16 monté sur la breadboard (§10), contrôles hors tension conformes, plus 7 mesures de placement (05/11)

### Tâche 2 : Banc 16 : validation de la sonde par l'USB

Détail : [2026-09-27-phase-1e-banc.md](2026-09-27-phase-1e-banc.md), tâche 16.
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
