Djoko-cli/haier-cchp21ebb-hotte-matter/docs/superpowers/plans/2026-11-04-phase-5-reconnaissance-sur-la-hotte.md

# Phase 5 : reconnaissance sur la hotte

Feuille de route : [../specs/2026-11-04-feuille-de-route.md](../specs/2026-11-04-feuille-de-route.md).
Le journal qui fait foi est [RECONNAISSANCE.md](../../RECONNAISSANCE.md) ; les
étapes sont décrites dans [SPEC-RECONNAISSANCE.md](../../SPEC-RECONNAISSANCE.md) §6,
et la sécurité dans [SECURITE.md](../../SECURITE.md). Jamais de 230 V touché sous
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
