Djoko-cli/haier-cchp21ebb-hotte-matter/docs/photos/3.jpg

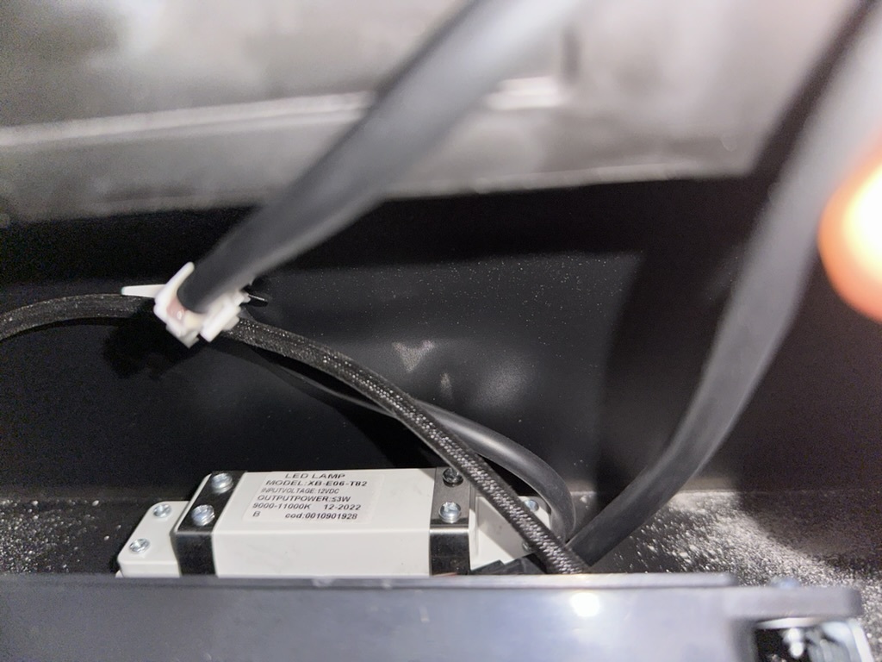
docs/photos/3.jpg
