Djoko-cli/haier-cchp21ebb-hotte-matter/docs/photos/4.jpg

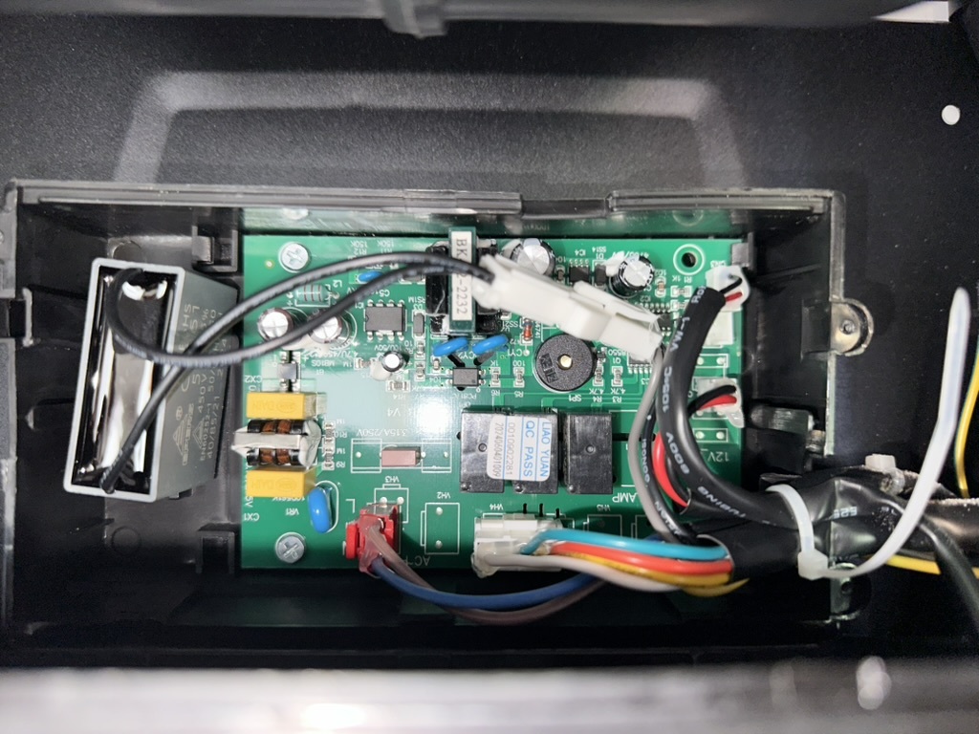
docs/photos/4.jpg
