Djoko-cli/haier-cchp21ebb-hotte-matter/docs/photos/6.jpg

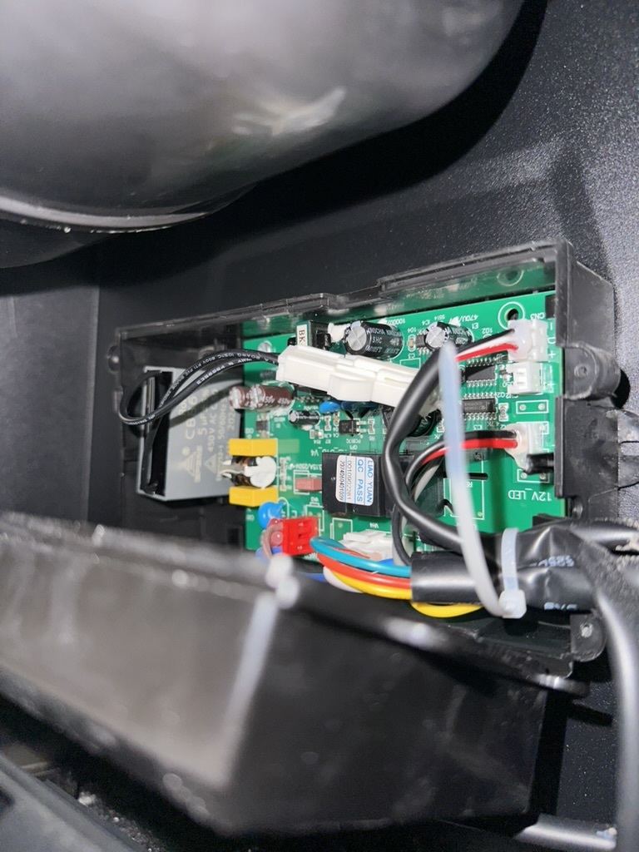
docs/photos/6.jpg
