Djoko-cli/haier-cchp21ebb-hotte-matter/docs/photos/etape0-ic.jpg

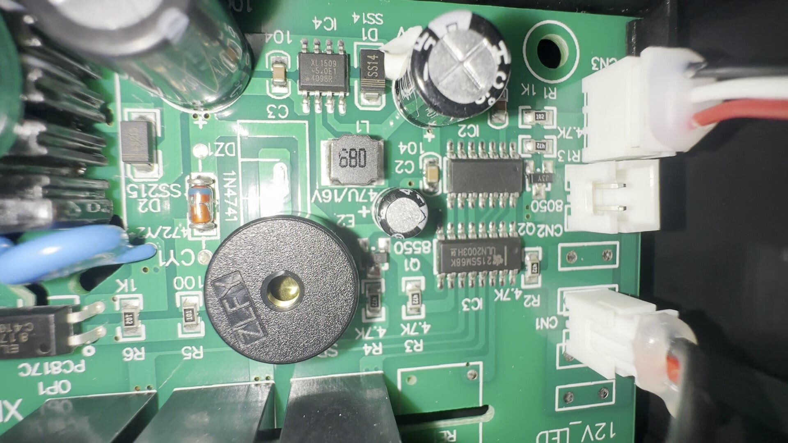
docs/photos/etape0-ic.jpg
