Djoko-cli/haier-cchp21ebb-hotte-matter/docs/photos/panneau-etats.jpg

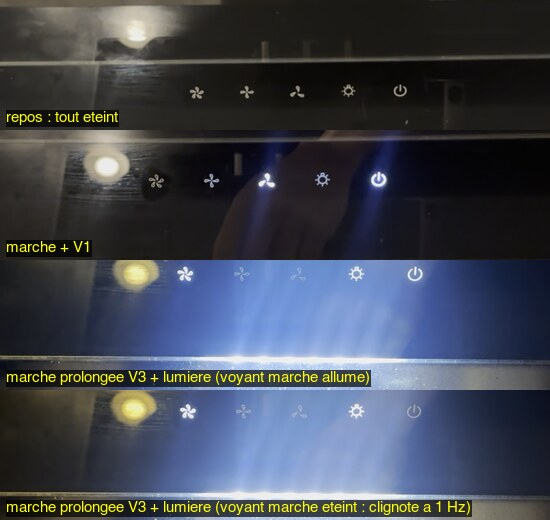
docs/photos/panneau-etats.jpg
