Djoko-cli/haier-cchp21ebb-hotte-matter/docs/photos/recadrages/c1_left.jpg

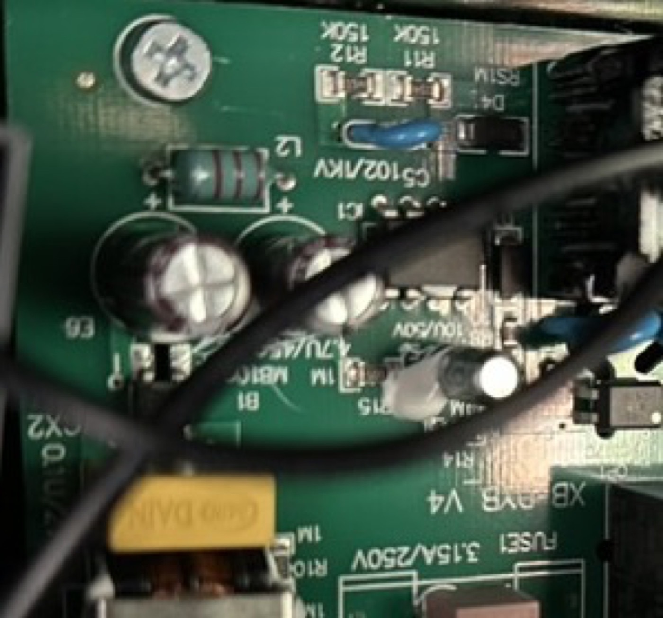
docs/photos/recadrages/c1_left.jpg
