Djoko-cli/haier-cchp21ebb-hotte-matter/docs/photos/recadrages/c4_bottom.jpg

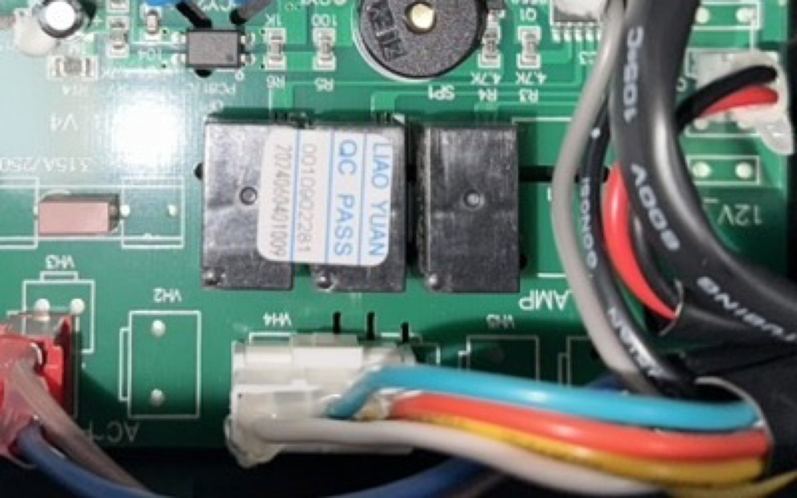
docs/photos/recadrages/c4_bottom.jpg
