Djoko-cli/haier-cchp21ebb-hotte-matter/docs/photos/recadrages/c6_right.jpg

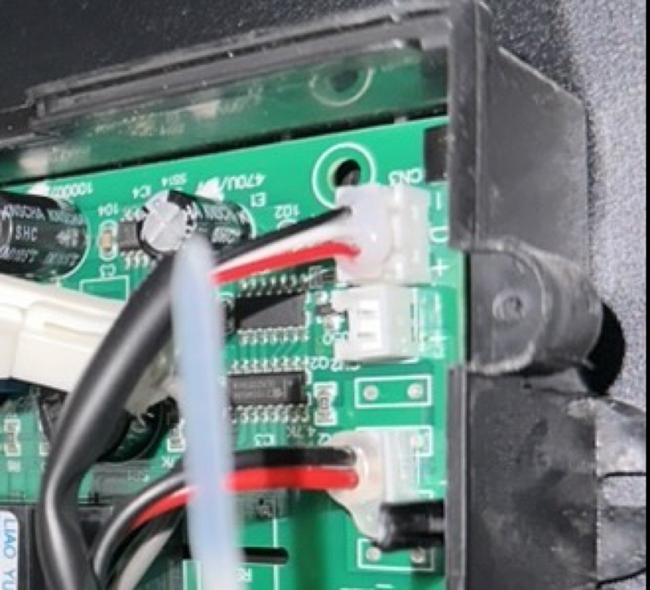
docs/photos/recadrages/c6_right.jpg
