Djoko-cli/haier-cchp21ebb-hotte-matter/docs/photos/recadrages/z_cn3_6.jpg

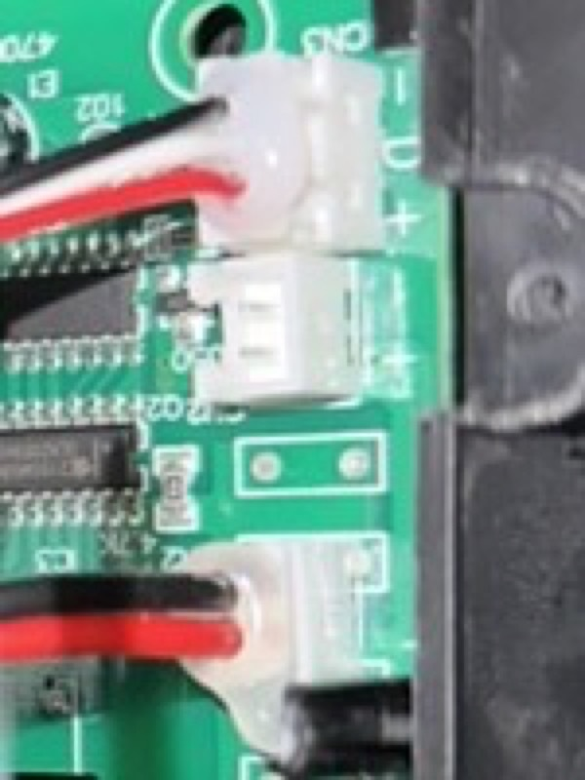
docs/photos/recadrages/z_cn3_6.jpg
