Djoko-cli/haier-cchp21ebb-hotte-matter/cao/plateau-boitier.scad

// Plateau du boitier de mesure (projet hotte Haier) : bac a rebord et clips, en PETG.
// Conception : docs/superpowers/specs/2026-11-04-plateau-boitier-design.md
//
// Reperes : origine au coin bas-gauche de la carte vue cote composants (X1 au bord gauche,
// USB-C du module vers le haut a droite). La carte occupe [0, W] x [0, H].
//
// Exports (sortie dans cao/sortie/, ignore par git) :
//   openscad -D 'piece="plateau"' -o cao/sortie/plateau-boitier.stl cao/plateau-boitier.scad
//   openscad -D 'piece="essai"'   -o cao/sortie/plateau-essai.stl   cao/plateau-boitier.scad

piece = "plateau";      // "plateau", "essai" ou "cadre" (contour pleine taille, pour verifier la carte)

// --- carte (mesuree au pied a coulisse le 04/11) ---
W = 70.0;               // largeur, bord a bord
H = 50.0;               // hauteur, bord a bord
e_carte = 1.63;         // epaisseur
trou_d = 2.0;           // diametre des trous de coin
entraxe_x = 65.8;       // entre centres des trous de coin
entraxe_y = 45.8;
trou_mx = (W - entraxe_x) / 2;   // centre des trous depuis les bords (2,1 : calcule, trous supposes centres)
trou_my = (H - entraxe_y) / 2;
relief = 2.1;           // plus haut relief cote soudures

// --- plateau ---
jeu = 0.4;              // jeu entre la carte et le rebord (le PETG rentre d'environ 0,1 mm a l'interieur)
paroi = 2.0;            // epaisseur du rebord
fond = 2.0;             // epaisseur du fond
vide = 4.5;             // hauteur libre sous la carte (relief + jeu)
depasse = 0.8;          // le rebord depasse la face composants de tant
plot_d = 3.6;           // plots sous les trous de coin
teton_d = 1.7;          // tetons de centrage (moins que trou_d)
teton_h = 1.2;          // moins que e_carte : ils centrent, ils ne tiennent pas

// --- clips (milieu des deux grands cotes) ---
clip_l = 12;            // largeur de la languette
clip_ep = 1.2;          // epaisseur de la languette (plus fine que le rebord : elle plie)
fente = 0.8;            // fentes de part et d'autre
levre = 0.6;            // recouvrement du bord de la carte (0,6 : la languette plie de 0,9 mm, environ 3 % en PETG)
levre_jeu = 0.15;       // jeu vertical sous la levre

// --- pattes a collier de serrage ---
patte_l = 12;           // longueur le long du rebord
patte_p = 10;           // saillie vers l'exterieur
collier_l = 4.2;        // fente : largeur du collier + jeu
collier_w = 1.8;        // fente : epaisseur du collier + jeu
collier_ecart = 6;      // entre les deux fentes d'une patte
patte_xh_y = 27.3;      // en face de X1 (rangees 09 a 12)
patte_usb_x = 56;       // sous l'USB-C du module (colonnes R a X)

// --- patins adhesifs (desactives : pas de patins le 04/11) ---
patins = false;
patin_d = 10.5;
patin_p = 0.8;

$fn = 48;
eps = 0.01;

z_carte = fond + vide;                  // dessous de la carte
h_rebord = vide + e_carte + depasse;    // au-dessus du fond
z_haut = fond + h_rebord;
x0 = -jeu; y0 = -jeu; x1 = W + jeu; y1 = H + jeu;   // interieur du bac

trous = [[trou_mx, trou_my], [W - trou_mx, trou_my], [trou_mx, H - trou_my], [W - trou_mx, H - trou_my]];

module bac() {
    difference() {
        translate([x0 - paroi, y0 - paroi, 0])
            cube([x1 - x0 + 2 * paroi, y1 - y0 + 2 * paroi, z_haut]);
        translate([x0, y0, fond]) cube([x1 - x0, y1 - y0, h_rebord + eps]);
        // fentes des clips, jusqu'au fond
        for (cote = [0, 1]) for (s = [-1, 1]) {
            yy = cote == 0 ? y0 - paroi - eps : y1 - eps;
            translate([W / 2 + s * (clip_l / 2 + fente / 2) - fente / 2, yy, fond])
                cube([fente, paroi + 2 * eps, h_rebord + eps]);
        }
        // languettes amincies : on retire l'exterieur du rebord entre les fentes
        for (cote = [0, 1]) {
            yy = cote == 0 ? y0 - paroi - eps : y1 + clip_ep;
            translate([W / 2 - clip_l / 2, yy, fond])
                cube([clip_l, paroi - clip_ep + eps, h_rebord + eps]);
        }
        if (patins) for (p = trous)
            translate([p[0], p[1], -eps]) cylinder(d = patin_d, h = patin_p + eps);
    }
}

// levre d'un clip, cote interieur ; cote = 0 en bas (y0), 1 en haut (y1)
module levre_clip(cote) {
    z0 = z_carte + e_carte + levre_jeu;
    avance = jeu + levre;
    profil = [[0, z0], [avance, z0], [avance, z0 + 0.3], [0, z0 + 0.3 + avance]];
    h_lang = z0 + 0.3 + avance;
    // la languette monte jusqu'au haut de la levre
    translate([W / 2 - clip_l / 2, cote == 0 ? y0 - clip_ep : y1, fond])
        cube([clip_l, clip_ep, h_lang - fond]);
    translate([W / 2 - clip_l / 2, 0, 0])
        if (cote == 0)
            translate([0, y0, 0]) rotate([90, 0, 90])
                linear_extrude(clip_l) polygon(profil);
        else
            translate([0, y1, 0]) mirror([0, 1, 0]) rotate([90, 0, 90])
                linear_extrude(clip_l) polygon(profil);
}

module plots() {
    for (p = trous) translate([p[0], p[1], fond - eps]) {
        cylinder(d = plot_d, h = vide + eps);
        translate([0, 0, vide]) cylinder(d = teton_d, h = teton_h + eps);
        translate([0, 0, vide + teton_h]) cylinder(d1 = teton_d, d2 = teton_d - 0.6, h = 0.3);
    }
}

// patte plate prolongeant le fond, percee de deux fentes pour un collier
module patte(centre, dir) {   // dir : [0,1] vers le haut, [-1,0] vers la gauche
    vertical = dir[0] == 0;
    difference() {
        if (vertical)
            translate([centre - patte_l / 2, y1 + paroi - eps, 0]) cube([patte_l, patte_p, fond]);
        else
            translate([x0 - paroi - patte_p + eps, centre - patte_l / 2, 0]) cube([patte_p, patte_l, fond]);
        for (s = [-1, 1])
            if (vertical)
                translate([centre + s * collier_ecart / 2 - collier_w / 2,
                           y1 + paroi + patte_p / 2 - collier_l / 2, -eps])
                    cube([collier_w, collier_l, fond + 2 * eps]);
            else
                translate([x0 - paroi - patte_p / 2 - collier_l / 2,
                           centre + s * collier_ecart / 2 - collier_w / 2, -eps])
                    cube([collier_l, collier_w, fond + 2 * eps]);
    }
}

module plateau() {
    bac();
    plots();
    levre_clip(0);
    levre_clip(1);
    patte(patte_xh_y, [-1, 0]);
    patte(patte_usb_x, [0, 1]);
}

// piece d'essai : le coin bas-gauche (plot, teton, rebord) et le clip du bas
module essai() {
    intersection() {
        plateau();
        translate([x0 - paroi - eps, y0 - paroi - eps, -eps]) cube([14, 14, 20]);
    }
    translate([-W / 2 + 25, 0, 0]) intersection() {
        plateau();
        translate([W / 2 - clip_l / 2 - 6, y0 - paroi - eps, -eps]) cube([clip_l + 12, 12, 20]);
    }
}

// cadre de controle : le contour interieur du bac, pleine taille, 2 mm de haut sur 0,6 mm de fond ajoure.
// La carte doit y tomber sans forcer, avec un jeu visible tout autour.
module cadre() {
    difference() {
        translate([x0 - paroi, y0 - paroi, 0]) cube([x1 - x0 + 2 * paroi, y1 - y0 + 2 * paroi, 2]);
        translate([x0, y0, 0.6]) cube([x1 - x0, y1 - y0, 2]);
        translate([x0 + 6, y0 + 6, -eps]) cube([x1 - x0 - 12, y1 - y0 - 12, 1]);
    }
}

if (piece == "essai") essai(); else if (piece == "cadre") cadre(); else plateau();
