Djoko-cli/haier-cchp21ebb-hotte-matter/tools/rendu_plaque.py

#!/usr/bin/env python3
# -*- coding: utf-8 -*-
"""Rendu SVG des plans de plaque a pastilles (projet hotte Haier).

  python3 tools/rendu_plaque.py [plan.json ...] [--sortie DOSSIER]

Sans plan donne : docs/fabrication/plan-boitier.json et plan-adaptateur.json ; sortie dans
docs/fabrication/ (ou --sortie). Pour chaque plan (format lu par verifier_plaque.py) :
  <carte>-composants.svg   vue cote composants (colonne 1 a gauche)
  <carte>-soudures.svg     vue cote soudures, en miroir (colonne 1 a droite)
Sans plan donne, en plus : supermini-brochage.svg (brochage reel de la SuperMini violette, releve le
28/09) et banc-breadboard.svg (banc de la tache 16 : generateur sur la breadboard, sonde sur le
boitier de mesure detache de la hotte).

Conventions du dessin (rappelees dans la legende de chaque figure) :
  - la face regardee est en trait plein ; ce qui est sur l'autre face est pale ;
  - pont de soudure : trait gris epais entre deux pastilles voisines ; fil nu : trait gris fin,
    soude aux points ronds seulement ; fil isole : sa couleur (rouge, marron, gris, noir ; rouge du 5V cote composants) ;
  - etape 7 (etage d'injection) : pointille violet ; option 5b (analyseur) : pointille bleu-vert ;
  - BC547 : le trait jaune du contour est la face plate ;
  - marquages au feutre du plan : numerotes sur la vue cote composants, listes dans la legende.
Aucune dependance externe. Texte en UTF-8, polices sans empattement.
"""
import json
import math
import os
import re
import sys
import unicodedata

ICI = os.path.dirname(os.path.abspath(__file__))
RANGEES = "ABCDEFGHIJKLMNOPQRSTUVWXYZ"
PAS = 2.54
POLICE = "Helvetica, Arial, sans-serif"
MOINS = "−"

# Brochage releve sur la photo de l'utilisateur (28/09), vue cote composants, USB-C a gauche.
HAUT = ["5V", "GND", "3V3", "20", "19", "18", "15", "14", "9", "8"]
BAS = ["TX", "RX", "0", "1", "2", "3", "4", "5", "6", "7"]

C = {
    "fond": "#ffffff", "texte": "#1b1f23", "gris": "#5f6670",
    "plaque": "#f4ecd9", "plaque_bord": "#b49e70", "cuivre": "#e2b05e", "cuivre_bord": "#a6772c",
    "etain": "#c3c8cd", "etain_bord": "#6c737a", "nu_bord": "#4f565d",
    "rouge": "#d62828", "vert": "#1f9a3a", "bleu": "#1f66d1", "noir": "#1e1e1e", "orange": "#f08c00",
    "blanc": "#ffffff", "marron": "#8b5a2b", "gris_isole": "#8f969d", "violet_module": "#6a3d9a",
    "e7": "#8e44ad", "e5b": "#0b8584", "feutre": "#1a4fbf", "plat": "#f2a900",
}
COULEUR_FIL = {"rouge": C["rouge"], "vert": C["vert"], "bleu": C["bleu"], "noir": C["noir"],
               "orange": C["orange"], "blanc": C["blanc"], "marron": C["marron"], "gris": C["gris_isole"]}
NOM_PICOT = {"TPM": "TP" + MOINS, "TPP": "TP+", "TPDP": "TP_Dp", "TPDC": "TP_Dc"}
COUL_PICOT = {"TPM": "noir", "TPP": "rouge", "TPDP": "blanc", "TPDC": "marron"}
FILS_CN3 = {"-": "noir", "D": "blanc", "+": "rouge"}
FILS_SORTIE = {"1": "noir", "2": "rouge", "3": "blanc", "4": "marron"}
NOM_SORTIE = {"1": "1 " + MOINS, "2": "2 +", "3": "3 Dp", "4": "4 Dc"}
NOM_X1 = {"1": ("1", MOINS, "noir"), "2": ("2", "+", "rouge"), "3": ("3", "Dp", "blanc"), "4": ("4", "Dc", "marron")}
SIGNE = {"-": MOINS, "D": "D", "+": "+"}

REGLAGES = {
    # k : pixels par mm ; marges : gauche, droite, haut, bas (mm, du centre du trou extreme au bord)
    "boitier": {"k": 15.0, "marges": (5.8, 5.8, 3.4, 3.4), "coins": "tous", "titre": "Boîtier de mesure",
                "fils_ext": 0},
    "adaptateur": {"k": 26.0, "marges": (5.8, 2.3, 3.4, 2.3), "coins": "haut-gauche", "titre": "Adaptateur",
                   "fils_ext": 170},
}


# ----------------------------------------------------------------------------- utilitaires
def trou(t):
    t = t.strip().upper()
    return RANGEES.index(t[0]), int(t[1:])


def plat(s):
    """minuscules sans accents, pour chercher des mots dans les notes"""
    return "".join(ch for ch in unicodedata.normalize("NFD", s or "") if unicodedata.category(ch) != "Mn").lower()


def etape_de(x):
    if x.get("monte") is False:
        return "reserve"
    e = str(x.get("etape", ""))
    return e if e in ("7", "5b") else ""


def esc(s):
    return str(s).replace("&", "&amp;").replace("<", "&lt;").replace(">", "&gt;").replace('"', "&quot;")


def pale(hexa, f=0.72):
    h = hexa.lstrip("#")
    r, g, b = int(h[0:2], 16), int(h[2:4], 16), int(h[4:6], 16)
    r, g, b = [int(round(v + (255 - v) * f)) for v in (r, g, b)]
    return "#%02x%02x%02x" % (r, g, b)


def valeur_courte(v):
    v = (v or "").split(" (")[0].strip().replace(".", ",")
    if re.fullmatch(r"\d+", v):
        v += " Ω"
    return v


def nom_ref(ref):
    return {"RBE": "R_be"}.get(ref, ref)


def couleur_dans(note):
    """couleur d'un fil isole : le mot qui suit « fil », sinon la premiere couleur citee dans la note"""
    n = plat(note)
    m = re.search(r"\bfil (rouge|vert|bleu|noir|orange|marron|gris)\b", n)
    if m:
        return m.group(1)
    trouves = [(m.start(), mot) for mot in ("rouge", "vert", "bleu", "noir", "orange", "marron", "gris")
               for m in [re.search(r"\b" + mot + r"\b", n)] if m]
    return min(trouves)[1] if trouves else None


def largeur_texte(s, taille, gras=False):
    l = 0.0
    for ch in s:
        if ch in "il.,:;|!'()[]fjtI":
            l += 0.3
        elif ch in "mwMW":
            l += 0.86
        elif ch.isupper() or ch.isdigit() or ch in "_" + MOINS + "+":
            l += 0.66
        elif ch == " ":
            l += 0.28
        else:
            l += 0.55
    return l * taille * (1.06 if gras else 1.0)


def plage(z):
    a, b = z.split("-")
    return trou(a), trou(b)


def unit(ax, ay, bx, by):
    dx, dy = bx - ax, by - ay
    n = math.hypot(dx, dy) or 1.0
    return dx / n, dy / n


def rectangle_oriente(cx, cy, tx, ty, long_, large):
    nx, ny = -ty, tx
    h, w = long_ / 2.0, large / 2.0
    return [(cx + tx * h + nx * w, cy + ty * h + ny * w), (cx - tx * h + nx * w, cy - ty * h + ny * w),
            (cx - tx * h - nx * w, cy - ty * h - ny * w), (cx + tx * h - nx * w, cy + ty * h - ny * w)]


def boite_de(pts, marge=0.0):
    xs = [q[0] for q in pts]
    ys = [q[1] for q in pts]
    return (min(xs) - marge, min(ys) - marge, max(xs) + marge, max(ys) + marge)


ACCENTS = [(r"\bcote\b", "côté"), (r"\bapparait\b", "apparaît"), (r"\ba (droite|part|marquer)\b", r"à \1"),
           (r"\bou il\b", "où il"), (r"\brange\b", "rangé"), (r"\betape\b", "étape"), (r"\bferme\b", "fermé"), (r"\bcable\b", "câble")]


def accents(s):
    """remet les accents des mots courants des plans (ecrits sans accents) pour l'affichage"""
    for motif, rempl in ACCENTS:
        s = re.sub(motif, rempl, s)
    return s.replace("- (noir", MOINS + " (noir")


def coupe_texte(s, n):
    mots, lignes, cur = s.split(), [], ""
    for m in mots:
        if len(cur) + len(m) + 1 > n and cur:
            lignes.append(cur)
            cur = m
        else:
            cur = (cur + " " + m).strip()
    if cur:
        lignes.append(cur)
    return lignes


# ----------------------------------------------------------------------------- SVG
class Svg:
    def __init__(self, w, h):
        self.w, self.h = int(w), int(h)
        self.el = []

    def add(self, s):
        self.el.append(s)

    @staticmethod
    def _dash(dash):
        return (' stroke-dasharray="%s"' % dash) if dash else ""

    def ligne(self, pts, coul, ep, dash=None, cap="round"):
        d = "M" + " L".join("%.1f %.1f" % p for p in pts)
        self.add('<path d="%s" fill="none" stroke="%s" stroke-width="%.2f" stroke-linecap="%s" '
                 'stroke-linejoin="round"%s/>' % (d, coul, ep, cap, self._dash(dash)))

    def courbe(self, d, coul, ep, dash=None):
        self.add('<path d="%s" fill="none" stroke="%s" stroke-width="%.2f" stroke-linecap="round"%s/>'
                 % (d, coul, ep, self._dash(dash)))

    def poly(self, pts, fill, stroke=None, ep=1.0, dash=None, op=None):
        self.add('<polygon points="%s" fill="%s"%s%s%s/>' % (
            " ".join("%.1f,%.1f" % p for p in pts), fill,
            (' stroke="%s" stroke-width="%.2f" stroke-linejoin="round"' % (stroke, ep)) if stroke else "",
            self._dash(dash), (' fill-opacity="%.2f"' % op) if op is not None else ""))

    def cercle(self, x, y, r, fill, stroke=None, ep=1.0, dash=None):
        self.add('<circle cx="%.1f" cy="%.1f" r="%.2f" fill="%s"%s%s/>' % (
            x, y, r, fill, (' stroke="%s" stroke-width="%.2f"' % (stroke, ep)) if stroke else "", self._dash(dash)))

    def rect(self, x, y, w, h, fill, stroke=None, ep=1.0, rx=0, dash=None, op=None):
        self.add('<rect x="%.1f" y="%.1f" width="%.1f" height="%.1f" rx="%.1f" fill="%s"%s%s%s/>' % (
            x, y, w, h, rx, fill, (' stroke="%s" stroke-width="%.2f"' % (stroke, ep)) if stroke else "",
            self._dash(dash), (' fill-opacity="%.2f"' % op) if op is not None else ""))

    def texte(self, x, y, s, taille=11, coul=None, ancre="start", gras=False, italique=False, rot=None):
        tr = (' transform="rotate(%d %.1f %.1f)"' % (rot, x, y)) if rot else ""
        self.add('<text x="%.1f" y="%.1f" font-size="%.1f" fill="%s" text-anchor="%s"%s%s%s>%s</text>' % (
            x, y, taille, coul or C["texte"], ancre, ' font-weight="bold"' if gras else "",
            ' font-style="italic"' if italique else "", tr, esc(s)))

    def rendu(self):
        tete = ('<?xml version="1.0" encoding="UTF-8"?>\n'
                '<svg xmlns="http://www.w3.org/2000/svg" width="%d" height="%d" viewBox="0 0 %d %d" '
                'font-family="%s">\n<rect width="%d" height="%d" fill="%s"/>\n'
                % (self.w, self.h, self.w, self.h, POLICE, self.w, self.h, C["fond"]))
        return tete + "\n".join(self.el) + "\n</svg>\n"


class Placeur:
    """pose des etiquettes sans chevauchement (boites approximatives)"""

    def __init__(self):
        self.boites = []

    @staticmethod
    def _chev(a, b):
        return not (a[2] <= b[0] or b[2] <= a[0] or a[3] <= b[1] or b[3] <= a[1])

    def libre(self, b):
        return all(not self._chev(b, o) for o in self.boites)

    def bloque(self, b):
        self.boites.append(b)

    def boite(self, x, y, s, taille, ancre, gras=False):
        w = largeur_texte(s, taille, gras)
        x0 = x if ancre == "start" else (x - w / 2 if ancre == "middle" else x - w)
        return (x0 - 2, y - taille * 0.84, x0 + w + 2, y + taille * 0.26)

    def place(self, svg, x, y, s, taille, candidats, coul=None, gras=False, fond=True):
        choix = None
        for dx, dy, ancre in candidats:
            b = self.boite(x + dx, y + dy, s, taille, ancre, gras)
            if self.libre(b):
                choix = (dx, dy, ancre, b)
                break
        if choix is None:
            dx, dy, ancre = candidats[0]
            choix = (dx, dy, ancre, self.boite(x + dx, y + dy, s, taille, ancre, gras))
            print("  (etiquette forcee : %s)" % s)
        dx, dy, ancre, b = choix
        self.bloque(b)
        if fond:
            svg.rect(b[0], b[1], b[2] - b[0], b[3] - b[1], "#ffffff", op=0.86, rx=2)
        svg.texte(x + dx, y + dy, s, taille, coul, ancre, gras)
        return b


def autour(d, taille=10):
    """positions autour d'un point, a la distance d (px)"""
    h = taille * 0.36
    return [(d, h, "start"), (-d, h, "end"), (0, -d - 1, "middle"), (0, d + taille * 0.8, "middle"),
            (d * 0.8, -d * 0.8, "start"), (-d * 0.8, -d * 0.8, "end"), (d * 0.8, d * 0.8 + taille * 0.7, "start"),
            (-d * 0.8, d * 0.8 + taille * 0.7, "end"), (d * 1.9, h, "start"), (-d * 1.9, h, "end"),
            (0, -d * 1.9, "middle"), (0, d * 1.9 + taille * 0.8, "middle")]


# ----------------------------------------------------------------------------- geometrie d'une vue
class Vue:
    def __init__(self, plan, cote):
        self.plan = plan
        self.carte = plan["carte"]
        self.reg = REGLAGES[self.carte]
        self.miroir = cote == "soudures"
        self.k = self.reg["k"]
        self.ML, self.MR, self.MT, self.MB = self.reg["marges"]
        self.nc, self.nr = plan["colonnes"], plan["rangees"]
        self.W = self.ML + (self.nc - 1) * PAS + self.MR
        self.H = self.MT + (self.nr - 1) * PAS + self.MB
        self.ox = self.oy = 0.0

    def mm(self, r, c):
        return (self.ML + (c - 1) * PAS, self.MT + r * PAS)

    def P(self, x, y):
        if self.miroir:
            x = self.W - x
        return (self.ox + x * self.k, self.oy + y * self.k)

    def T(self, t):
        r, c = trou(t)
        return self.P(*self.mm(r, c))

    def Tm(self, t):
        r, c = trou(t)
        return self.mm(r, c)

    def pts(self, liste):
        return [self.P(x, y) for x, y in liste]

    def a_moi(self, face):
        return (face == "dessous") == self.miroir

    def sx(self, dx):
        """sens horizontal a l'ecran d'un deplacement dx (mm) de la vue composants"""
        return -dx if self.miroir else dx


def style_etape(x):
    e = etape_de(x)
    if e == "7":
        return C["e7"], "6 4"
    if e == "5b":
        return C["e5b"], "6 4"
    if e == "reserve":
        return C["gris"], "2 3"
    return None, None


def suffixe_etape(x):
    return {"7": " (7)", "5b": " (5b)"}.get(etape_de(x), "")


# ----------------------------------------------------------------------------- composants, vue composants
def tulipe(svg, vue, t, coul_et=None, dash=None):
    X, Y = vue.T(t)
    k = vue.k
    svg.rect(X - 1.15 * k, Y - 1.15 * k, 2.3 * k, 2.3 * k, "#d8d8d8" if not coul_et else "#ffffff",
             coul_et or "#555555", 1.6, rx=2, dash=dash)
    svg.cercle(X, Y, 0.6 * k, "#e9c46a" if not coul_et else "#ffffff", coul_et or "#8a6d1f", 1.2)


def geo_resistance(vue, br):
    a, b = vue.Tm(br["1"]), vue.Tm(br["2"])
    tx, ty = unit(a[0], a[1], b[0], b[1])
    d = math.hypot(b[0] - a[0], b[1] - a[1])
    L = min(6.4, d - 2.0)
    cx, cy = (a[0] + b[0]) / 2, (a[1] + b[1]) / 2
    return a, b, tx, ty, L, cx, cy


def corps_resistance(svg, vue, cp, pl):
    k = vue.k
    br = cp["broches"]
    note = plat(cp.get("note", ""))
    coul_et, dash = style_etape(cp)
    if "tulipe" in note:
        construction = "construction" in note
        for t in (br["1"], br["2"]):
            if construction:
                tulipe(svg, vue, t)
            else:
                tulipe(svg, vue, t, coul_et, dash)
    a, b, tx, ty, L, cx, cy = geo_resistance(vue, br)
    e1 = (cx - tx * L / 2, cy - ty * L / 2)
    e2 = (cx + tx * L / 2, cy + ty * L / 2)
    svg.ligne(vue.pts([a, e1]), coul_et or "#6b6b6b", 0.5 * k)
    svg.ligne(vue.pts([e2, b]), coul_et or "#6b6b6b", 0.5 * k)
    corps = rectangle_oriente(cx, cy, tx, ty, L, 2.4)
    svg.poly(vue.pts(corps), "#ecd9ae" if not coul_et else "#ffffff", coul_et or "#8a6d3b", 1.6, dash=dash)
    pl.bloque(boite_de(vue.pts(corps)))


def texte_resistance(svg, vue, cp, pl):
    k = vue.k
    coul_et, _ = style_etape(cp)
    a, b, tx, ty, L, cx, cy = geo_resistance(vue, cp["broches"])
    lib = "%s %s%s" % (nom_ref(cp["ref"]), valeur_courte(cp.get("valeur")), suffixe_etape(cp))
    X, Y = vue.P(cx, cy)
    taille = 11
    horizontal = abs(tx) > abs(ty)
    if horizontal and largeur_texte(lib, taille, True) < L * k - 6:
        svg.texte(X, Y + 4, lib, taille, coul_et or C["texte"], "middle", gras=True)
        return
    d = 1.3 * k + 3
    if horizontal:
        cands = [(0, -d - 1, "middle"), (0, d + 10, "middle")] + autour(d + 4, taille)
    else:
        cands = [(d, 4, "start"), (-d, 4, "end")] + autour(d + 4, taille)
    pl.place(svg, X, Y, lib, taille, cands, coul=coul_et or C["texte"], gras=True)


def geo_support(vue, cp):
    br = cp["broches"]
    m = re.search(r"corps (?:sur|au-dessus de) ([A-Z]\d+)", cp.get("note", ""))
    corps_t = m.group(1) if m and m.group(1) in br.values() else br.get("2")
    autre_t = [t for t in br.values() if t != corps_t][0]
    return corps_t, autre_t


def corps_support(svg, vue, cp, pl):
    k = vue.k
    br = cp["broches"]
    coul_et, dash = style_etape(cp)
    for t in br.values():
        tulipe(svg, vue, t, coul_et, dash)
        X, Y = vue.T(t)
        pl.bloque((X - 1.2 * k, Y - 1.2 * k, X + 1.2 * k, Y + 1.2 * k))
    corps_t, autre_t = geo_support(vue, cp)
    Xc, Yc = vue.T(corps_t)
    Xa, Ya = vue.T(autre_t)
    dxp, dyp = Xa - Xc, Ya - Yc
    mx, my = (Xc + Xa) / 2 + dyp * 0.45, (Yc + Ya) / 2 - dxp * 0.45
    svg.courbe("M%.1f %.1f Q%.1f %.1f %.1f %.1f" % (Xc, Yc, mx, my, Xa, Ya), coul_et or "#6b6b6b", 0.45 * k)
    svg.cercle(Xc, Yc, 1.3 * k, "#ecd9ae" if not coul_et else "#ffffff", coul_et or "#8a6d3b", 1.8, dash=dash)
    pl.bloque((Xc - 1.35 * k, Yc - 1.35 * k, Xc + 1.35 * k, Yc + 1.35 * k))


def texte_support(svg, vue, cp, pl):
    k = vue.k
    coul_et, _ = style_etape(cp)
    corps_t, autre_t = geo_support(vue, cp)
    Xc, Yc = vue.T(corps_t)
    Xa, Ya = vue.T(autre_t)
    lib = "%s %s%s" % (nom_ref(cp["ref"]), valeur_courte(cp.get("valeur")), suffixe_etape(cp))
    d = 1.6 * k
    if abs(Ya - Yc) > abs(Xa - Xc):
        cands = [(d, 4, "start"), (-d, 4, "end"), (0, (-d - 2) if Ya > Yc else (d + 10), "middle")]
    else:
        cands = [(0, -d - 2, "middle"), (0, d + 10, "middle"),
                 ((-d if Xa > Xc else d), 4, "end" if Xa > Xc else "start")]
    pl.place(svg, Xc, Yc, lib, 10.5, cands + autour(d + 6, 10.5), coul=coul_et or C["texte"], gras=True)
    svg.texte(Xc, Yc + 3.5, "debout", 8.5, coul_et or "#6b4f1d", "middle")


def geometrie_to92(vue, br):
    """contour TO-92 (mm, vue composants) ; la face plate est vers n : C a gauche quand on la regarde"""
    c, b, e = vue.Tm(br["C"]), vue.Tm(br["B"]), vue.Tm(br["E"])
    tx, ty = unit(c[0], c[1], e[0], e[1])
    nx, ny = -ty, tx
    R, a = 2.45, 1.05
    t1 = math.atan2(a, math.sqrt(R * R - a * a))
    t2 = math.pi - t1
    pts = []
    for i in range(41):
        th = t2 + (2 * math.pi + t1 - t2) * i / 40.0
        pts.append((b[0] + R * (math.cos(th) * tx + math.sin(th) * nx),
                    b[1] + R * (math.cos(th) * ty + math.sin(th) * ny)))
    h = math.sqrt(R * R - a * a)
    plat_ = [(b[0] + a * nx - h * tx, b[1] + a * ny - h * ty), (b[0] + a * nx + h * tx, b[1] + a * ny + h * ty)]
    return pts, plat_, (nx, ny), b


def corps_bc547(svg, vue, cp, pl):
    k = vue.k
    br = cp["broches"]
    coul_et, dash = style_etape(cp)
    pts, plat_, n, b = geometrie_to92(vue, br)
    svg.poly(vue.pts(pts), "#3a3a3a" if not coul_et else "#ffffff", coul_et or "#111111", 1.4, dash=dash)
    svg.ligne(vue.pts(plat_), coul_et or C["plat"], 0.5 * k, cap="butt")
    for nom in ("C", "B", "E"):
        X, Y = vue.T(br[nom])
        svg.cercle(X, Y, 0.5 * k, "#ffffff" if not coul_et else "#ffffff", coul_et or "#111111", 1.2)
        svg.texte(X, Y + 3.4, nom, 9.5, coul_et or C["texte"], "middle", gras=True)
    pl.bloque(boite_de(vue.pts(pts)))


def texte_bc547(svg, vue, cp, pl):
    k = vue.k
    br = cp["broches"]
    coul_et, _ = style_etape(cp)
    pts, plat_, n, b = geometrie_to92(vue, br)
    Xb, Yb = vue.P(*b)
    lib = "%s BC547%s" % (cp["ref"], suffixe_etape(cp))
    nsx, nsy = vue.sx(n[0]), n[1]
    d = 2.9 * k
    if abs(nsx) > abs(nsy):
        cands = [(-nsx * d, 4, "start" if nsx < 0 else "end"), (0, -d, "middle"), (0, d + 10, "middle")]
    else:
        cands = [(0, -nsy * d + (10 if nsy < 0 else 0), "middle"), (d, 4, "start"), (-d, 4, "end")]
    pl.place(svg, Xb, Yb, lib, 11, cands + autour(d + 8, 11), coul=coul_et or C["texte"], gras=True)
    fx, fy = (plat_[0][0] + plat_[1][0]) / 2, (plat_[0][1] + plat_[1][1]) / 2
    Xf, Yf = vue.P(fx + n[0] * 0.5, fy + n[1] * 0.5)
    if abs(nsx) > abs(nsy):
        cands = [(nsx * 4, 4, "start" if nsx > 0 else "end"), (0, -0.9 * k, "middle"), (0, 1.4 * k, "middle")]
    else:
        cands = [(0, 11 if nsy > 0 else -4, "middle"), (2.4 * k, 4, "start"), (-2.4 * k, 4, "end")]
    pl.place(svg, Xf, Yf, "face plate", 9.5, cands, coul=coul_et or "#9a6a00", gras=True)


def geo_supermini(vue, br):
    P5, P8, PTX, P7 = vue.Tm(br["5V"]), vue.Tm(br["8"]), vue.Tm(br["TX"]), vue.Tm(br["7"])
    ux, uy = unit(P5[0], P5[1], P8[0], P8[1])
    vx, vy = unit(P5[0], P5[1], PTX[0], PTX[1])
    cx = (P5[0] + P8[0] + PTX[0] + P7[0]) / 4
    cy = (P5[1] + P8[1] + PTX[1] + P7[1]) / 4

    def pt(a, b):
        return (cx + ux * a + vx * b, cy + uy * a + vy * b)
    return pt, (cx, cy)


def corps_supermini(svg, vue, cp, pl, fantome=False):
    k = vue.k
    br = cp["broches"]
    pt, centre = geo_supermini(vue, br)
    L, Wd = 25.6, 17.7
    corps = [pt(-L / 2, -Wd / 2), pt(L / 2, -Wd / 2), pt(L / 2, Wd / 2), pt(-L / 2, Wd / 2)]
    usb = [pt(-L / 2 - 1.1, -4.5), pt(-L / 2 + 6.2, -4.5), pt(-L / 2 + 6.2, 4.5), pt(-L / 2 - 1.1, 4.5)]
    ant = [pt(L / 2 - 2.6, -3.2), pt(L / 2 - 0.8, -3.2), pt(L / 2 - 0.8, 3.2), pt(L / 2 - 2.6, 3.2)]
    puce = [pt(-1.0, -3.0), pt(5.0, -3.0), pt(5.0, 3.0), pt(-1.0, 3.0)]
    if fantome:
        svg.poly(vue.pts(corps), "none", "#b9a3d3", 1.6, dash="6 4")
        svg.poly(vue.pts(usb), "none", "#c0c0c0", 1.2, dash="4 3")
        return
    svg.poly(vue.pts(corps), "#efe6f8", C["violet_module"], 2.2)
    svg.poly(vue.pts(puce), "#ddd0ec", "#9a86b8", 1)
    svg.poly(vue.pts(usb), "#dcdcdc", "#555555", 1.6)
    svg.poly(vue.pts(ant), "#f7f0c6", "#8f7d2a", 1.4)
    X, Y = vue.P(*pt(-L / 2 + 2.6, 0))
    svg.texte(X, Y + 4, "USB-C", 12, C["texte"], "middle", gras=True)
    X, Y = vue.P(*pt(L / 2 - 4.6, 0))
    svg.texte(X, Y + 4, "antenne", 11, "#6b5b12", "middle", gras=True)
    X, Y = vue.P(*pt(2.0, 0))
    svg.texte(X, Y - 4, "U1", 14, C["violet_module"], "middle", gras=True)
    svg.texte(X, Y + 11, "SuperMini", 10.5, C["violet_module"], "middle")
    svg.texte(X, Y + 24, "(sonde)", 10.5, C["violet_module"], "middle")
    for nom, t in br.items():
        X, Y = vue.T(t)
        svg.rect(X - 0.95 * k, Y - 0.95 * k, 1.9 * k, 1.9 * k, "#2b2b2b", None, rx=2)
        svg.cercle(X, Y, 0.42 * k, "#e9c46a")
        role = role_broche(nom)
        px, py = vue.Tm(t)
        dirx = vue.sx(centre[0] - px)
        svg.texte(X + (1.3 * k if dirx > 0 else -1.3 * k), Y + 4, nom, 11 if role[1] else 10, role[0],
                  "start" if dirx > 0 else "end", gras=bool(role[1]))
    pl.bloque(boite_de(vue.pts(corps)))


def role_broche(nom):
    return {
        "6": (C["marron"], True), "7": (C["e7"], True), "GND": (C["noir"], True), "5V": (C["rouge"], True),
        "3V3": (C["gris_isole"], True), "0": ("#4a79b8", True), "1": ("#4a79b8", True),
    }.get(nom, ("#8a8a8a", False))


def geo_xh(vue, cp):
    br = cp["broches"]
    pos = [vue.Tm(t) for t in br.values()]
    xs = [q[0] for q in pos]
    ys = [q[1] for q in pos]
    cx, cy = (min(xs) + max(xs)) / 2, (min(ys) + max(ys)) / 2
    vertical = (max(ys) - min(ys)) > (max(xs) - min(xs))
    n = len(pos)
    long_ = (n - 1) * 2.5 + 4.9
    tx, ty = (0, 1) if vertical else (1, 0)
    return cx, cy, vertical, long_, tx, ty


def corps_xh(svg, vue, cp, pl):
    k = vue.k
    br = cp["broches"]
    cx, cy, vertical, long_, tx, ty = geo_xh(vue, cp)
    corps = rectangle_oriente(cx, cy, tx, ty, long_, 5.75)
    svg.poly(vue.pts(corps), "#fbf7ee", "#5a5a5a", 2)
    if cp["type"] == "xh4":  # verrou vers le bord le plus proche (X1 : vers l'exterieur)
        s = -1 if cx < vue.W / 2 else 1
        ver = rectangle_oriente(cx + s * 3.3, cy, tx, ty, long_ * 0.55, 0.8)
        svg.poly(vue.pts(ver), "#5a5a5a", "#5a5a5a", 1)
    for nom, t in br.items():
        X, Y = vue.T(t)
        svg.rect(X - 0.4 * k, Y - 0.4 * k, 0.8 * k, 0.8 * k, "#c9a227", "#6b5712", 1)
        if cp["type"] == "xh4":
            num, noeud, coul = NOM_X1[nom]
            lib = "%s %s" % (num, noeud)
        else:
            lib, coul = SIGNE[nom], FILS_CN3[nom]
        s_int = 1 if cx < vue.W / 2 else -1
        d = vue.sx(s_int)
        cote = 0.75 * k if cp["type"] == "xh4" else 0.6 * k
        svg.rect(X + d * cote - (0 if d > 0 else 10), Y - 5, 10, 10, COULEUR_FIL[coul], "#333333", 1, rx=2)
        svg.texte(X + d * (cote + 13), Y + 4.5, lib, 12 if cp["type"] == "xh3" else 11.5, C["texte"],
                  "start" if d > 0 else "end", gras=True)
    pl.bloque(boite_de(vue.pts(corps), 1))


def texte_xh(svg, vue, cp, pl):
    k = vue.k
    cx, cy, vertical, long_, tx, ty = geo_xh(vue, cp)
    X, Y = vue.P(cx, cy - long_ / 2)
    n = len(cp["broches"])
    lib = "%s (XH %d br.)" % (cp["ref"], n)
    pl.place(svg, X, Y, lib, 11.5, [(0, -6, "middle"), (vue.sx(3.0) * k, -6, "start"), (vue.sx(-3.0) * k, -6, "end")]
             + autour(12, 11.5), gras=True)
    if cp["type"] == "xh4":
        s = -1 if cx < vue.W / 2 else 1
        Xv, Yv = vue.P(cx + s * 3.3, cy + long_ / 2)
        pl.place(svg, Xv, Yv, "verrou", 10, [(0, 13, "middle"), (0, 25, "middle")], coul=C["gris"])
    else:
        Xv, Yv = vue.P(cx, cy + long_ / 2)
        pl.place(svg, Xv, Yv, "sens imposé : voir le gabarit", 10.5,
                 [(0, 15, "middle"), (0, 28, "middle"), (vue.sx(-2.9) * k, 15, "end"), (vue.sx(-2.9) * k, 28, "end")],
                 coul=C["rouge"], gras=True)


def corps_picot(svg, vue, cp, pl):
    k = vue.k
    X, Y = vue.T(cp["broches"]["1"])
    svg.rect(X - 1.25 * k, Y - 1.25 * k, 2.5 * k, 2.5 * k, "#1e1e1e", None, rx=1.5)
    svg.rect(X - 0.35 * k, Y - 0.35 * k, 0.7 * k, 0.7 * k, "#e9c46a")
    pl.bloque((X - 1.3 * k, Y - 1.3 * k, X + 1.3 * k, Y + 1.3 * k))


def texte_picot(svg, vue, cp, pl):
    k = vue.k
    X, Y = vue.T(cp["broches"]["1"])
    nom = NOM_PICOT.get(cp["ref"], cp["ref"])
    coul = COULEUR_FIL[COUL_PICOT.get(cp["ref"], "noir")]
    texte_coul = "#ffffff" if coul in (C["noir"], C["rouge"], C["marron"]) else C["texte"]
    w = largeur_texte(nom, 12, True) + 10
    h = 19
    cands = [(1.5 * k, -h / 2), (-1.5 * k - w, -h / 2), (-w / 2, -1.5 * k - h), (-w / 2, 1.5 * k),
             (1.5 * k, -1.5 * k - h + 4), (-1.5 * k - w, -1.5 * k - h + 4), (1.5 * k, 1.5 * k - 4),
             (-1.5 * k - w, 1.5 * k - 4)]
    b = None
    for dx, dy in cands:
        bb = (X + dx, Y + dy, X + dx + w, Y + dy + h)
        if pl.libre(bb):
            b = bb
            break
    if b is None:
        b = (X + cands[0][0], Y + cands[0][1], X + cands[0][0] + w, Y + cands[0][1] + h)
        print("  (etiquette forcee : %s)" % nom)
    pl.bloque(b)
    svg.rect(b[0], b[1], w, h, coul, "#333333", 1.2, rx=4)
    svg.texte(b[0] + w / 2, b[1] + 14, nom, 12, texte_coul, "middle", gras=True)


def geo_barrette(vue, cp):
    br = cp["broches"]
    pos = [vue.Tm(t) for t in br.values()]
    xs = [q[0] for q in pos]
    ys = [q[1] for q in pos]
    cx, cy = (min(xs) + max(xs)) / 2, (min(ys) + max(ys)) / 2
    vertical = (max(ys) - min(ys)) > (max(xs) - min(xs))
    tx, ty = (0, 1) if vertical else (1, 0)
    return cx, cy, vertical, tx, ty, len(pos)


def barrette_fermee(cp):
    note = plat(cp.get("note", ""))
    return cp["type"] == "barrette2" and ("ferme par defaut" in note or "cavalier ferme" in note)


def corps_barrette(svg, vue, cp, pl):
    k = vue.k
    br = cp["broches"]
    coul_et, dash = style_etape(cp)
    cx, cy, vertical, tx, ty, n = geo_barrette(vue, cp)
    corps = rectangle_oriente(cx, cy, tx, ty, n * 2.54, 2.5)
    svg.poly(vue.pts(corps), "#1e1e1e" if not coul_et else "#ffffff", coul_et or "#1e1e1e", 1.4, dash=dash)
    ferme = barrette_fermee(cp)
    if ferme:
        cav = rectangle_oriente(cx, cy, tx, ty, 2 * 2.54 + 0.5, 2.9)
        svg.poly(vue.pts(cav), "#1d3a8a", "#0e1f4d", 1.4)
    for num, t in br.items():
        X, Y = vue.T(t)
        if ferme:
            continue
        svg.rect(X - 0.35 * k, Y - 0.35 * k, 0.7 * k, 0.7 * k, "#e9c46a" if not coul_et else coul_et)
        if cp["type"] == "analyseur3":
            lib = num
        elif cp["ref"] == "J2":
            lib = {"1": "+", "2": "5V"}.get(num, num)
        else:
            lib = num
        coul_txt = "#ffffff" if not coul_et else coul_et
        if vertical:
            svg.texte(X + 0.52 * k, Y + 3.5, lib, 8.5, coul_txt, "start", gras=True)
        else:
            svg.texte(X, Y - 0.52 * k, lib, 8.5, coul_txt, "middle", gras=True)
    pl.bloque(boite_de(vue.pts(corps), 1))


def texte_barrette(svg, vue, cp, pl):
    k = vue.k
    coul_et, _ = style_etape(cp)
    cx, cy, vertical, tx, ty, n = geo_barrette(vue, cp)
    X, Y = vue.P(cx, cy)
    if cp["type"] == "barrette2":
        ferme = barrette_fermee(cp)
        lib = "%s : cavalier fermé" % cp["ref"] if ferme else "%s OUVERT" % cp["ref"]
        d = 1.9 * k
        cands = [(d, 4, "start"), (-d, 4, "end"), (0, -n * 1.27 * k - 5, "middle"), (0, n * 1.27 * k + 13, "middle")]
        pl.place(svg, X, Y, lib, 11.5, cands + autour(d + 10, 11.5), coul=C["rouge"] if not ferme else "#1d3a8a",
                 gras=True)
    else:
        lib = "%s%s" % (cp["ref"], suffixe_etape(cp))
        d = 1.9 * k
        cands = [(0, -d - 2, "middle"), (0, d + 11, "middle"), (n * 1.27 * k + 6, 4, "start"),
                 (-n * 1.27 * k - 6, 4, "end")]
        pl.place(svg, X, Y, lib, 11, cands + autour(d + 10, 11), coul=coul_et or C["texte"], gras=True)


def fils_entrants(svg, vue, cp, pale_=False):
    """fils de la fiche CN3 (colonne 1) ou du cable de sortie (colonne 2), entres cote composants"""
    k = vue.k
    br = cp["broches"]
    cn3 = cp["type"] == "fils_cn3"
    table = FILS_CN3 if cn3 else FILS_SORTIE
    for nom, t in br.items():
        x, y = vue.Tm(t)
        coul = COULEUR_FIL[table[nom]]
        x0 = -(vue.reg["fils_ext"] - 8) / vue.k
        if cn3:
            chemin = [(x0, y - 0.45), (x - 0.9, y - 0.45), (x, y)]
            ep = 0.36 * k
        else:
            chemin = [(x0, y + 0.55), (x - 1.5, y + 0.55), (x, y)]
            ep = 0.46 * k
        if pale_:
            svg.ligne(vue.pts(chemin), pale(coul if table[nom] != "blanc" else "#999999", 0.62), 0.25 * k)
            continue
        svg.ligne(vue.pts(chemin), "#222222", ep + 3)
        svg.ligne(vue.pts(chemin), coul, ep)
        X, Y = vue.T(t)
        svg.cercle(X, Y, 0.34 * k, "#9aa0a6", "#333333", 1)


def texte_fils_entrants(svg, vue, cp, pl):
    br = cp["broches"]
    cn3 = cp["type"] == "fils_cn3"
    for nom, t in br.items():
        x, y = vue.Tm(t)
        X, Y = vue.P(-(vue.reg["fils_ext"] - 8) / vue.k, y + (-0.45 if cn3 else 0.55))
        lib = ("fiche CN3 %s" % SIGNE[nom]) if cn3 else ("câble %s" % NOM_SORTIE[nom])
        svg.texte(X + 2, Y - 0.36 * vue.k - 3, lib, 11, C["texte"], "start", gras=True)


CORPS = {"resistance": corps_resistance, "support2": corps_support, "BC547": corps_bc547,
         "supermini": corps_supermini, "xh4": corps_xh, "xh3": corps_xh, "picot": corps_picot,
         "barrette2": corps_barrette, "analyseur3": corps_barrette}
TEXTES = {"resistance": texte_resistance, "support2": texte_support, "BC547": texte_bc547,
          "xh4": texte_xh, "xh3": texte_xh, "picot": texte_picot, "barrette2": texte_barrette,
          "analyseur3": texte_barrette, "fils_cn3": texte_fils_entrants, "sortie4": texte_fils_entrants}


# ----------------------------------------------------------------------------- vue soudures
def fantome(svg, vue, cp):
    """contour pale d'une piece posee de l'autre cote"""
    t = cp["type"]
    br = cp["broches"]
    coul = "#b7ab92"
    if t == "supermini":
        corps_supermini(svg, vue, cp, None, fantome=True)
    elif t == "BC547":
        pts, plat_, n, b = geometrie_to92(vue, br)
        svg.poly(vue.pts(pts), "none", coul, 1.3, dash="4 3")
        svg.ligne(vue.pts(plat_), "#e8c983", 3, cap="butt")
    elif t == "resistance":
        a, b, tx, ty, L, cx, cy = geo_resistance(vue, br)
        svg.poly(vue.pts(rectangle_oriente(cx, cy, tx, ty, L, 2.4)), "none", coul, 1.3, dash="4 3")
    elif t in ("xh4", "xh3"):
        cx, cy, vertical, long_, tx, ty = geo_xh(vue, cp)
        svg.poly(vue.pts(rectangle_oriente(cx, cy, tx, ty, long_, 5.75)), "none", coul, 1.3, dash="4 3")
    elif t in ("barrette2", "analyseur3"):
        cx, cy, vertical, tx, ty, n = geo_barrette(vue, cp)
        svg.poly(vue.pts(rectangle_oriente(cx, cy, tx, ty, n * 2.54, 2.5)), "none", coul, 1.3, dash="4 3")
    elif t in ("fils_cn3", "sortie4"):
        fils_entrants(svg, vue, cp, pale_=True)


def soudures_composant(svg, vue, cp, pl):
    k = vue.k
    coul_et, dash = style_etape(cp)
    note = plat(cp.get("note", ""))
    construction = cp["type"] == "resistance" and "tulipe" in note and "construction" in note
    for nom, t in cp["broches"].items():
        X, Y = vue.T(t)
        if coul_et and not construction:
            svg.cercle(X, Y, 1.0 * k, "#ffffff", coul_et, 1.8, dash="4 3")
            svg.cercle(X, Y, 0.42 * k, "#ffffff", coul_et, 1)
        else:
            svg.cercle(X, Y, 1.0 * k, C["etain"], C["etain_bord"], 1.2)
            svg.cercle(X, Y, 0.28 * k, "#6d6d6d")
        pl.bloque((X - 0.95 * k, Y - 0.95 * k, X + 0.95 * k, Y + 0.95 * k))


def textes_soudures(svg, vue, pl, comps):
    k = vue.k
    for cp in comps:
        coul_et, _ = style_etape(cp)
        typ = cp["type"]
        br = cp["broches"]
        for nom, t in br.items():
            X, Y = vue.T(t)
            if typ == "supermini":
                role = role_broche(nom)
                pt, centre = geo_supermini(vue, br)
                px, _ = vue.Tm(t)
                dirx = vue.sx(centre[0] - px)
                d = 1.2 * k
                cands = [(d if dirx > 0 else -d, 4, "start" if dirx > 0 else "end"),
                         (0, -d - 1, "middle"), (0, d + 9, "middle"),
                         (-d if dirx > 0 else d, 4, "end" if dirx > 0 else "start")]
                pl.place(svg, X, Y, nom, 10.5 if role[1] else 9.5, cands, coul=role[0], gras=bool(role[1]))
                continue
            if typ == "picot":
                lib = NOM_PICOT.get(cp["ref"], cp["ref"])
            elif typ == "BC547":
                lib = "%s.%s" % (cp["ref"], nom)
            elif typ == "xh4":
                lib = "X1.%s %s" % (NOM_X1[nom][0], NOM_X1[nom][1])
            elif typ == "xh3":
                lib = "XH3 %s" % SIGNE[nom]
            elif typ == "fils_cn3":
                lib = "CN3 %s" % SIGNE[nom]
            elif typ == "sortie4":
                lib = "câble %s" % NOM_SORTIE[nom]
            elif typ == "barrette2":
                lib = "%s.%s" % (cp["ref"], nom)
                if cp["ref"] == "J2":
                    lib += {"1": " (+)", "2": " (5V)"}.get(nom, "")
            elif typ == "analyseur3":
                lib = "ANA.%s" % nom
            else:
                lib = nom_ref(cp["ref"])
            pl.place(svg, X, Y, lib, 9.5, autour(1.05 * k, 9.5), coul=coul_et or C["texte"], gras=True)


# ----------------------------------------------------------------------------- liaisons
def segments(vue, l):
    chemin = l.get("chemin") or [l["de"], l["a"]]
    return [vue.T(t) for t in chemin]


def obstacles_liaison(vue, l, pl):
    k = vue.k
    pts = segments(vue, l)
    w = {"pont": 0.6, "fil_nu": 0.35, "fil_isole": 0.6}.get(l.get("genre"), 0.4) * k
    for (x1, y1), (x2, y2) in zip(pts, pts[1:]):
        pl.bloque((min(x1, x2) - w, min(y1, y2) - w, max(x1, x2) + w, max(y1, y2) + w))


def dessine_liaison(svg, vue, l, pl=None, pale_=False):
    k = vue.k
    genre = l.get("genre")
    pts = segments(vue, l)
    e = etape_de(l)
    coul_et = C["e7"] if e == "7" else (C["e5b"] if e == "5b" else None)
    dash = "7 5" if coul_et else None
    if pale_:
        if genre == "fil_isole":
            coul = COULEUR_FIL.get(couleur_dans(l.get("note", "")) or "", "#888888")
            svg.ligne(pts, pale(coul, 0.6), 0.5 * k, dash=dash)
        else:
            svg.ligne(pts, pale(coul_et or "#8a8f95", 0.55), 0.28 * k if genre == "fil_nu" else 0.45 * k, dash=dash)
        return
    if genre == "pont":
        if coul_et:
            svg.ligne(pts, coul_et, 1.2 * k, dash="5 3")
            svg.ligne(pts, "#ffffff", 0.75 * k)
        else:
            svg.ligne(pts, C["etain_bord"], 1.3 * k)
            svg.ligne(pts, C["etain"], 0.98 * k)
    elif genre == "fil_nu":
        if coul_et:
            svg.ligne(pts, coul_et, 0.4 * k, dash=dash)
        else:
            svg.ligne(pts, C["nu_bord"], 0.5 * k)
            svg.ligne(pts, "#cfd4d9", 0.2 * k)
        for X, Y in (pts[0], pts[-1]):
            svg.cercle(X, Y, 0.6 * k, "#ffffff" if coul_et else C["etain"], coul_et or C["etain_bord"], 1.4,
                       dash="3 2" if coul_et else None)
    elif genre == "fil_isole":
        nomc = couleur_dans(l.get("note", "")) or "noir"
        coul = COULEUR_FIL[nomc]
        bord = "#000000" if nomc != "noir" else "#8a8a8a"
        svg.ligne(pts, bord, 0.9 * k + 2.4, dash=dash)
        svg.ligne(pts, coul, 0.9 * k, dash=dash)
        note = l.get("note", "")
        m = re.search(r"au-dessus de ([A-Z]\d+)", note)
        chemin = l.get("chemin") or [l["de"], l["a"]]
        if "manchon" in plat(note) and m:
            seg = segment_contenant(chemin, m.group(1))
            if seg:
                (x1, y1), (x2, y2) = vue.Tm(seg[0]), vue.Tm(seg[1])
                tx, ty = unit(x1, y1, x2, y2)
                cx, cy = vue.Tm(m.group(1))
                man = rectangle_oriente(cx, cy, tx, ty, 15.0, 1.5)
                svg.poly(vue.pts(man), "#ffffff", "#333333", 1.4, op=0.45)
                if pl is not None:
                    cands = []
                    for s_ in (-2.5, 2.5, -5.0, 5.0, 0.0):
                        Xm, Ym = vue.P(cx + tx * s_, cy + ty * s_)
                        for dx_, anc in ((1.0 * k, "start"), (-1.0 * k, "end")):
                            cands.append((Xm - vue.P(cx, cy)[0] + dx_, Ym - vue.P(cx, cy)[1] + 4, anc))
                    Xm, Ym = vue.P(cx, cy)
                    pl.place(svg, Xm, Ym, "manchon", 10.5, cands, coul="#333333", gras=True)
        for X, Y in (pts[0], pts[-1]):
            svg.cercle(X, Y, 0.6 * k, C["etain"], C["etain_bord"], 1.4)


def chemin_complet(chemin):
    tous = []
    for a, b in zip(chemin, chemin[1:]):
        (r1, c1), (r2, c2) = trou(a), trou(b)
        if r1 == r2:
            s = 1 if c2 > c1 else -1
            tous += ["%s%d" % (RANGEES[r1], c) for c in range(c1, c2 + s, s)]
        elif c1 == c2:
            s = 1 if r2 > r1 else -1
            tous += ["%s%d" % (RANGEES[r], c1) for r in range(r1, r2 + s, s)]
    return tous


def segment_contenant(chemin, t):
    for a, b in zip(chemin, chemin[1:]):
        if t in chemin_complet([a, b]):
            return a, b
    return None


# ----------------------------------------------------------------------------- zones
def style_zone(nom):
    """(remplissage, trait, pointille, libelle) ou None si la zone n'est pas dessinee"""
    n = plat(nom)
    if n in ("fixation", "gaine", "decoupe", "supermini", "fils isoles", "arret de traction", "epine de masse",
             "fils"):
        return None
    if "etape 7" in n or n.startswith("injection"):
        return ("#f7f0fb", C["e7"], "7 4", "zone de l'étape 7 (trous vides)")
    if "5b" in n or n.startswith("analyseur"):
        return ("#e9f6f5", C["e5b"], "7 4", "zone 5b (trous vides)")
    if "voie 2" in n:
        return ("#edf3fb", "#5b84c4", "3 3", "voie 2 (architecture B) : réservée, vide")
    if n.startswith("garde"):
        return ("#f1f1f1", "#9a9a9a", "2 3", "garde")
    if "couloir" in n:
        return ("#f6f6f6", "#9a9a9a", "2 3", "couloir USB-C : rien de haut")
    if n == "bus":
        return ("#fbecec", "#d9a0a0", None, "bus : +, D_panneau, D_carte, " + MOINS)
    if n.startswith("ecoute"):
        return ("#eef7ea", "#8fbf80", None, "écoute, voie 1")
    if n.startswith("separation"):
        return ("#ebe4d3", "#b8ab8c", "2 3", None)
    if n.startswith("fenetre"):
        return (None, "#333333", "5 3", "fenêtre" + (" (cavalier)" if "j1" in n else " (XH3)"))
    return ("#f3f3f3", "#999999", "3 3", nom)


def rect_zone(vue, z):
    (r1, c1), (r2, c2) = plage(z["trous"])
    m = 1.3
    x1, y1 = vue.mm(min(r1, r2), min(c1, c2))
    x2, y2 = vue.mm(max(r1, r2), max(c1, c2))
    return boite_de(vue.pts([(x1 - m, y1 - m), (x2 + m, y1 - m), (x2 + m, y2 + m), (x1 - m, y2 + m)]))


def dessine_zones(svg, vue):
    for z in vue.plan.get("zones", []):
        st = style_zone(z["nom"])
        if not st:
            continue
        fill, stroke, dash, lib = st
        X0, Y0, X1, Y1 = rect_zone(vue, z)
        svg.rect(X0, Y0, X1 - X0, Y1 - Y0, fill or "none", stroke, 1.3, rx=4, dash=dash)


def textes_zones(svg, vue, pl):
    for z in vue.plan.get("zones", []):
        st = style_zone(z["nom"])
        if not st or not st[3]:
            continue
        fill, stroke, dash, lib = st
        X0, Y0, X1, Y1 = rect_zone(vue, z)
        coul = stroke if stroke not in ("#999999", "#9a9a9a", "#333333") else C["gris"]
        w, h = X1 - X0, Y1 - Y0
        cands = [(3, -3, "start"), (w - 3, -3, "end"), (3, h + 11, "start"), (w - 3, h + 11, "end"),
                 (3, 11, "start"), (w - 3, 11, "end"), (3, h - 4, "start"), (w - 3, h - 4, "end"),
                 (w / 2, -3, "middle"), (w / 2, h + 11, "middle")]
        pl.place(svg, X0, Y0, lib, 10, cands, coul=coul)
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
