Djoko-cli/haier-cchp21ebb-hotte-matter/(commit log)

2026-09-24 Consigner la spec de reconnaissance et la recherche initiale
    Sous-projet 1 (reconnaissance de la ligne D entre le panneau tactile et
    la carte de puissance XB_DYB_V4), valide section par section avec l'utilisateur
    les 24 et 25/09, puis revise apres une relecture adverse (securite 230 V,
    electronique et firmware, coherence avec le protocole compagnon de la
    ScreenBar).
    - docs/SPEC-RECONNAISSANCE.md : objectif, regles de securite, etapes -1
    a 7, adaptateur et boitier de mesure exterieur, firmware sonde,
    profil hotte du protocole compagnon v1, outils Mac, banc de validation
    - docs/BRIEF-RECHERCHE.md : recherche du 24/09 (57 sources)
    - docs/photos/ : photos de la carte et de l'etiquette (nume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
2026-09-27 Ecrire le plan d'implementation de la sonde de reconnaissance
    29 taches en 7 parties : fiches de terrain, outils Python d'analyse,
    firmware de base (capture RMT continue, console), mode machine sur l'USB
    et captures de reference, banc et generateur, Wi-Fi et UDP H1, injection
    bornee et cloture. Les taches [BANC avec l'utilisateur] (16, 16b, 21, 24) se font
    avec la carte ; toutes les autres sans.
    Chaque tache a ete executee dans une copie de travail pendant la
    redaction : le plan rejoue de bout en bout redonne la copie a l'octet
    pres (75 fichiers), tests hote et 159 tests Python verts, envs sonde et
    generateur compiles sans avertissement. Relu pour la coherence et la
    couverture de la spec, p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
2026-09-27 Ecrire les fiches de terrain : securite, journal et cablage
2026-09-27 Ajouter les signaux synthetiques et la simulation de la sonde
2026-09-27 Ajouter la lecture des captures de la sonde
2026-09-27 Ajouter le decoupage en trames et le decodeur UART
2026-09-27 Ajouter les decodeurs distance d'impulsion et Manchester et le classement auto
2026-09-27 Ajouter l'outil d'analyse des captures
2026-09-27 Poser le projet de la sonde : version, configuration, reglages et bornes de capture
2026-09-27 Scinder json_out de la ScreenBar : u64, evenements trame et injection, liste blanche hotte
2026-09-27 Ecrire le decoupeur de la capture : parties de 110 durees, horodatage, mode changements
2026-09-27 Brancher la capture RMT continue, les fronts de GPIO6 et la console USB
2026-09-27 Ajouter le versement des captures de reference
2026-09-27 Ajouter les motifs du banc en C++, croises avec signaux.py
2026-09-27 Ajouter les verdicts du banc et sa procedure
2026-09-27 Ajouter le Wi-Fi de la sonde et la commande wifi
2026-09-27 Copier l'enveloppe H1 de la ScreenBar
2026-09-27 Ecrire la procedure du banc par le Wi-Fi et sur la batterie
2026-09-27 Ajouter les garde-fous de l'injection et leurs reglages en NVS
2026-09-27 Ajouter la commande impulsions du generateur et la procedure du critere 5
2026-09-27 Mettre a jour le README et les renvois de la spec, retirer anyMachine
2026-09-27 Consigner l'observation d'usage de l'etape -1 (video du 27/09)
    Disposition du panneau (V3, V2, V1, lumiere, marche), un bip identique de
    200 ms a 4,11 kHz pour chaque appui, lumiere independante de la marche,
    vitesse active qui arrete le moteur, et marche prolongee native (voyant
    marche clignotant a 1 Hz, moteur a la meme vitesse). Restent : vitesse
    sans marche, extinction seule de la marche, appuis longs, reprise apres
    coupure, duree de la marche prolongee.
2026-09-27 Completer l'etape -1 avec les reponses de l'utilisateur
    Vitesse sans marche : rien. La marche ne s'eteint pas seule (au moins
    30 min). Marche prolongee native de 15 min. Appuis longs : aucun effet.
    Apres une coupure, rien ne se rallume, un seul bip au rebranchement.
2026-09-27 Noter l'absence de bip pour une vitesse sans marche
2026-09-27 Noter l'analyseur commande, l'absence d'oscilloscope et les couleurs du cable de sortie
2026-09-27 Consigner le pas de CN3 : JST PH 2,0 mm
2026-09-27 Corriger le pas de CN3 : XH tres probable d'apres la longueur de l'embase
2026-09-27 Confirmer le pas de CN3 (XH) et noter la colle de la fiche du panneau
2026-09-28 Generateur : ne plus attendre la console pour les lignes de progression
    Console fermee, Serial.printf attendait 2 s par ligne (HWCDC : 20 x 100 ms)
    et etirait d'autant la pause : une trame toutes les 2 s au banc 0 du 28/09.
    Ligne entiere ou sautee, comme la sonde (spec 8.7) ; la ligne 'fini' donne
    le nombre de lignes sautees.
2026-09-28 Sonde : s'arreter au marqueur de fin du RMT dans le bloc dernier
    Reception a nombre pair de durees : le marqueur de fin (duree nulle) ouvre
    un mot, dont le C6 remplit la seconde moitie avec la derniere duree recue,
    niveau compris. Le decoupeur sautait le zero et fondait cette copie avec
    l'originale : derniere duree doublee, t_us avance d'autant. Banc 0 du 28/09 :
    krona, trame 0 (repos pris 18 ms avant, sous le silence de 19 ms), 2000 us
    lus 4000, soit 0xFF lu 0xFE ; reproduit avec uart9600inv (pause 3 ms),
    208 us lus 416.
    Dans le bloc dernier, rien ne compte apres la premiere duree nulle.
    testDureesNulles porte desormais sur les blocs non derniers : un zero dans
    le bloc dernier est le marqu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
2026-09-28 Consigner le banc 0 : firmwares seuls, 9 motifs OK
    Generateur relie directement a la sonde (GPIO7 -> GPIO6, sans etages) :
    1000 / 1000 trames au bit pres pour chaque motif, ecart max 1 us, rafale
    complete sans perte (10 000 fronts/s). Defauts trouves et corriges en
    route : b5013d1 (generateur) et 3449bf7 (sonde). Pause du generateur
    notee : +48 us median, 3 a 10 pauses sur 1000 allongees de 1 a 4 ms.
2026-09-28 Sonde : dire pourquoi 'wifi' refuse, sans montrer le mot de passe
    Le 28/09, un mot de passe colle a ete refuse sans raison lisible, puis
    accepte une fois tape a la main : le texte copie portait un caractere hors
    ASCII imprimable (le collage du terminal, lui, est propre : verifie octet
    par octet avec un texte sans secret). netWifiRefus donne la regle en cause
    et, pour un octet interdit, sa position et sa valeur (espace insecable :
    0xC2) ; netWifiValides en decoule. BANC.md 8.1 : taper le mot de passe a
    la main, et la console depuis le depot avec -f direct (sans log2file).
2026-09-28 Consigner le banc 0 par le Wi-Fi : krona 4500 / 4500, 0 trou de n
    Sonde sur l'USB du Mac (pas la batterie), sur le bureau, RSSI -75 a
    -64 dBm : 4 500 trames krona au bit pres par le Wi-Fi, 0 trou de n sur
    7 179 lignes, compteurs de la sonde a +0, H1 sans rejet ni renvoi, aucune
    perte de connexion. Reste la meme mesure sur la batterie (tache 21).
2026-09-28 Etape 1 : mesurer sur les broches de CN3 si la colle gene l'aiguille
    La fiche du panneau porte une goutte de colle a la sortie des fils (28/09) :
    l'aiguille peut ne pas passer. Alternative, hotte debranchee : retirer la
    fiche par son boitier et poser la pointe sur la broche de CN3 ; meme mesure
    d'isolation, le panneau n'etant relie qu'a CN3. Fiche remise au point 7.
2026-09-28 Etape 1 : feu vert (isolation OL) ; etape 0 : puces, relais et acces
    Etape 1 (28/09, multimetre automatique de l'utilisateur) : les six mesures entre
    les broches de la fiche et CN3 (-, D, +) donnent OL ; le - de CN3 est relie
    a la terre (0 ohm, note, pas un defaut) ; terre de la fiche vers la masse
    de la carcasse : moins de 1 ohm. Feu vert pour construire l'adaptateur.
    Etape 0, d'apres les videos IMG_9111 et IMG_9112 : IC2 SOP-14 sans
    marquage, IC3 ULN2003H, IC4 XL1509-5.0 (abaisseur 5 V, cote basse
    tension), relais caches par une etiquette de controle ; acces au boitier
    sans outil. Trois images de la video versees (sans metadonnees). Restent
    les lignes 5 et 6 (cable du panneau, cheminement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
2026-09-28 Sonde : annonces Wi-Fi et injection sans attente sur l'USB
    Les deux annonce() (reseau, injection) partent seules, hors de toute
    commande : sans session en 'json log 1', elles faisaient un Serial.println,
    qui attend 2 s quand un Mac alimente la sonde sans lire son port (HWCDC,
    meme mecanisme que le generateur au banc 0 du 28/09) ; la capture aurait
    pu deborder pendant ce temps. jsonTexteUsb : ligne entiere ou rien,
    perdue et comptee comme textNb. Inventaire fait : les autres ecritures sur
    l'USB repondent a une commande tapee, partent au demarrage, ou sont deja
    protegees (lignes trame).
2026-09-28 Etape 0 : boitier de mesure provisoire dehors, module final dans la hotte
    Decision de l'utilisateur (28/09) : pendant la reconnaissance, le boitier de mesure
    reste hors de la hotte (manipulations, batterie, analyseur, Wi-Fi) ; le
    module final ira dans le boitier electronique, en boitier imprime 3D.
2026-09-28 Spec du produit Matter (sous-projet 2) et ajouts a la reconnaissance, a relire
    SPEC-PRODUIT.md : conception tiree des decisions de l'utilisateur du 28/09, validees
    partie par partie (Maison : ventilateur 3 paliers + lumiere, critere des
    voyants chiffre ; logiciel en couches, pilote de D simule puis A/B/C apres
    l'etape 6 ; materiel : SuperMini sous condition radio, + de CN3 protege,
    boitier ASA ; verification ; ordre des travaux), et de son amendement du
    soir (ASA impose, pas de thermometre, temperature de la puce surveillee).
    Relue sous trois angles (coherence, technique, securite) et corrigee ;
    questions ouvertes au 13. Projet a relire par l'utilisateur.
    AJOUTS-RECONNAISSANCE.md : ajouts (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
2026-09-28 Spec du produit : questions de relecture tranchees par l'utilisateur le 29/09
    Q23, Q26, Q27, Q34 a Q40 tranchees ; Q19 : preference (baisser d'abord
    l'emission, garder le RXEF025) ; Q41 : proposition retenue par defaut
    (UL1007 pour la reconnaissance, fil 105 C pour la traversee du produit).
    Ajouts : test 6 sans minuterie et correction F1 de WIRING.md valides.
2026-09-29 Guide de fabrication, plans verifies et brochage reel de la SuperMini
    FABRICATION.md : ou poser chaque piece, ordre de soudure et controles trou
    par trou pour l'adaptateur (coin de plaque 8 x 7), le cable de sortie, le
    boitier de mesure (plaque 5 x 7, 24 x 18 trous) et le banc de la tache 16.
    Plans dans docs/fabrication/plan-*.json : trois conceptions independantes,
    deux juges, synthese, relecture contradictoire (electrique, securite,
    fabrication) et correction ; verifies par tools/verifier_plaque.py (liaisons,
    courts-circuits, regle 10, SuperMini non retournee) dans les quatre
    configurations, test tools/tests/test_plaque.py. Dessins (vues cote
    composants et cote soudures en miroir, brochage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
2026-09-29 Verser les ajouts a la reconnaissance (blocs A1 a E3 et AC)
    Etape -1b, scenarios 7b et 7c de l'etape 5, tests 5 et 6 de l'etape 6,
    sequence d'arret de l'etape 7, mesure radio M1 et ses regles de securite.
    F1 etait deja dans WIRING.md ; D4 est retire par l'amendement du 28/09.
2026-09-29 Premier plan d'implementation du produit Matter (points 2 a 4 de la spec)
    Automate et hotte simulee testes sur le Mac, couche Matter et compagnon du
    build produit, outils du Mac, banc Matter avec l'utilisateur : 18 taches. Les taches
    1 a 11 ont ete executees a blanc dans un clone neuf ; les sorties attendues
    sont celles obtenues.
2026-09-29 Ajouter la table des transitions et les reglages de l'automate de la hotte
2026-09-29 Ecrire l'automate de la hotte : ordres, confiance, sequences, regle d'or
2026-09-29 Ajouter l'interface du pilote de ligne et la hotte simulee
2026-09-29 Tester l'automate de bout en bout avec la hotte simulee
2026-09-29 Ajouter la correspondance Matter et le regroupement des ecritures d'EP1
2026-09-29 Ajouter la surveillance de la temperature de la puce et des tensions
2026-09-29 Ajouter les briques du protocole compagnon du produit
2026-09-29 Ecrire la procedure du banc Matter et presenter le module produit
2026-10-13 Sortir les codes d'appairage du depot et ajouter la garde des vrais identifiants
    - tools/codes_appairage.py tire une fois les codes dans src/produit/codes_appairage.h,
    fichier local ignore par git ; config_produit.h s'arrete sur un #error sans lui ;
    en-tete factice pour les tests hote.
    - tools/garde.py (copie adaptee de celle de maillage-zigbee) refuse les identifiants
    de garde.local.txt dans les fichiers suivis et les messages des commits pousses.
    - Spec 8.2 et banc Matter mis a jour ; .gitignore des donnees locales.
2026-10-13 Passer le role Thread du produit au FED par defaut
    Le reglage 'matter med 0|1' devient 'matter role 0|1|2' (0 eligible routeur,
    1 MED, 2 FED) : nouvelle cle NVS 'role', enveloppe _SetThreadDeviceType qui pose
    FullEndDevice, defaut -DMATTER_THREAD_ROLE=2. Bloc matter du compagnon :
    role_demarrage 'fed'. Spec 4.7 et 6.1, banc Matter (B12 compare les trois roles).
2026-10-14 Republier le palier reel apres chaque sequence et noter les reflets
    - Apres toute sequence (sauf remplacee), le noeud republie l'etat reel, meme
    inchange : un geste reste dans le palier courant ne laisse plus la valeur du
    doigt publiee (banc Matter, B1).
    - 'matter journal' note aussi nos reflets, horodates (64 entrees).
    - Option -DHOTTE_MULTISPEED=1 (essai B14, SpeedMax = 3), desactivee par defaut.
2026-10-14 Rallumer a la derniere vitesse au bouton de la tuile de Maison
    Maison rallume toujours par un PercentSetting = 100 seul (banc B2). Moteur a
    l'arret, une fenetre de regroupement qui ne contient que ce 100 % est lue comme
    le bouton : derniere vitesse. Moteur en marche, 100 % reste V3. Tests hote.
2026-10-14 Banc Matter : bouton de la tuile (B2), regle 4 du 3.3 revisee
2026-10-14 Ignorer la lecture perimee qui suit un appui au panneau
    La carte reagit a un appui avec un delai ; une trame d'etat partie entre-temps
    redisait l'etat d'avant et defaisait la deduction : V1, V3, V1 publies en
    150 ms. Pendant confirmationMs, une telle lecture est ignoree ; au-dela, ou si
    elle differe de l'etat d'avant, elle s'applique. Test hote.
2026-10-14 Banc Matter : noter l'anomalie de la lecture perimee et sa correction
2026-10-14 Noter le cluster dans le journal des ecritures de Matter
    OnOff et FanMode ont tous deux l'attribut 0 : sans le cluster, une ecriture
    de la lumiere s'affichait « FanMode ».
2026-10-14 Plan du produit : cocher la tache 13 du banc Matter
2026-10-31 Ignorer les pages Archify locales
2026-11-03 Fabrication : ignorer les reperes imprimes sur la plaque, seul A1 fait foi
2026-11-03 Journal : controle 17 du module de la sonde, conforme
2026-11-03 Achats : ajouter le ruban Kapton, oublie de la liste
2026-11-03 Achats : ajouter la tulipe, le fil de cablage, les entretoises nylon et le flux
    Ils etaient dans la nomenclature de FABRICATION.md, ajoutee le 29/09,
    mais jamais reportes dans la liste d'achats de la spec.
2026-11-03 Achats : fils du boitier deja la, fixation par plateau imprime en PETG
2026-11-03 Fabrication : conversion des reperes du plan vers les reperes imprimes de la plaque
2026-11-03 Fabrication : lettres imprimees en miroir cote soudures (A <-> X), constate sur la plaque
2026-11-04 Fabrication : fils du boitier en marron, gris et rouge, jamais en Dupont
    Les fils Dupont coupes (vert, bleu, orange) ne prennent pas l'etain,
    constate le 04/11 sur le fil de GPIO6. GPIO6 passe en marron, 3V3 en
    gris, le 5V cote composants en rouge marque au feutre. Rendu des
    dessins mis a jour (couleurs et legende) et dessins regeneres.
2026-11-04 Feuille de route lisible par Jalons : 8 phases, plans renommes phase-N
    Nouvelle spec docs/superpowers/specs/2026-11-04-feuille-de-route.md (les
    3 sous-projets en 8 phases). Les parties des deux plans passent au
    premier niveau de plans/ sous des noms phase-N, leurs en-tetes dans leur
    dossier ; liens corriges. Taches faites cochees ; les bancs 16, 16b, 21
    et 24 reportes en phase 4. Trois plans neufs : boitier de mesure, bancs
    de la sonde, reconnaissance sur la hotte.
2026-11-04 Boitier de mesure : fil rouge du 5V pose et controle
2026-11-04 Boitier de mesure : controles complets conformes
2026-11-04 Boitier de mesure : plateau en PETG, bac a rebord et clips (OpenSCAD)
    Conception courte dans docs/superpowers/specs/2026-11-04-plateau-boitier-design.md
    (approche B choisie par Djoko le 04/11) et fichier parametrique
    cao/plateau-boitier.scad, avec une piece d'essai (coin et clip) a imprimer
    d'abord. Exports dans cao/sortie/, ignore par git.
2026-11-04 Plateau du boitier : piece d'essai conforme, impression complete lancee
2026-11-04 Plateau du boitier : cotes reelles de la carte (70,0 x 50,0 x 1,63) et cadre de controle
    Le premier bac, dessine sur 69,5 x 49,5 calcules depuis les entraxes,
    etait trop etroit : carte forcee et courbee, une languette cassee. Jeu
    porte a 0,4 mm, trous recentres a 2,1 mm des bords, jeu sous les levres
    a 0,15 mm. Nouvelle piece "cadre" : le contour pleine taille sur 2 mm,
    pour verifier la carte en quelques minutes avant un bac complet.
2026-11-04 Fabrication : ruban d'electricien PVC admis a defaut de Kapton sur la coque USB-C
2026-11-04 Boitier de mesure : controle 16, coque USB-C isolee
2026-11-04 Boitier de mesure : plateau imprime, carte posee
2026-11-04 Phase 3 finie : boitier de mesure monte, controle et pose sur son plateau
2026-11-04 Banc : generateur sur une nanoESP32-C6 en attendant une SuperMini
    Variante du banc de la breadboard (FABRICATION 10) : la carte reste a cote,
    trois fils Dupont pour 5V, GND et GPIO7. Firmware generateur flashe par
    l'USB natif et console verifiee.
2026-11-04 Phase 4 : banc de la tâche 16 monté sur la breadboard, contrôles hors tension conformes
2026-11-04 Banc 16, variante 1 : 8 motifs a 1000/1000, rafale sans perte, ecart max 1 us
    Marge de --duree portee a 60 s (premier uart500 coupe a 964 trames).
2026-11-05 Banc 16, variante 2 : 8 motifs a 1000/1000, rafale sans perte, ecart max 2 us
    Decalage suggere -1,2 us (le 1 nF ralentit la remontee de la LIGNE),
    aucun necessaire. Marge de lancement des motifs portee a 180 s.
2026-11-05 Banc 16 fini : critere 6 (25,7 mA par l'USB) et conclusions
2026-11-05 hotte_udp cle : caler le decoupage avant la demande (reponse perdue en mode machine)
    Le 05/11, 'hotte_udp.py cle <port>' a echoue deux fois par « aucune reponse
    en 5 s », et la cle de la sonde changeait quand meme. Cause : la sonde etait
    restee en mode machine (json 1 bail 0 d'un enregistrement interrompu). Dans
    ce mode, Ctrl-U et la ligne vide ne renvoient rien ; le nouveau decoupage
    restait donc non cale et jetait, comme reste d'une ligne ancienne, la
    premiere ligne complete recue : la reponse de 'json cle nouvelle', emise
    seule et tout de suite. lire_build passait, car la reponse de 'json hello'
    suit les lignes deja en file. L'appel direct a reussi apres un 'json 0'.
    Correctif : prepar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
2026-11-05 Banc 16b, variante 1 : etage d'ecoute a 1,01 us (descendant), asymetrie 1,24 us
    Captures du FX2 par sigrok-cli (PulseView 0.4.2 fige sous Rosetta), delais
    calcules sur tous les fronts. uart9600 et wtc : 20 / 20 trames cote sonde,
    decalage suggere +0,6 et +0,7 us. Incident du diviseur 5b (R6 a 47 ohms)
    consigne.
2026-11-09 Banc 16b fini : variante 2, asymetrie 2,0 a 2,6 us, tol_us garde a 20 us
    uart9600 et wtc a 20 / 20 cote sonde (decalage suggere -1,2 et -0,6 us).
    Variation entre captures en variante 2 consignee, cause non etablie.
    Tache 3 de la phase 4 cochee.
2026-11-09 Sonde Wi-Fi : balayage de tous les canaux, point d'acces le plus fort
    Le balayage rapide par defaut d'Arduino-ESP32 3.3.12 rejoignait le
    premier point d'acces qui repond, meme lointain : -90 a -95 dBm au banc 21,
    avec des lignes perdues. Apres le correctif, quatre demarrages sur quatre
    rejoignent le point d'acces proche (-63 a -68 dBm).
2026-11-09 Sonde : canal et empreinte du point d'acces dans reseau/ip
    Pour savoir a quel point d'acces la sonde se rattache (banc 21 : -63 ou
    -93 dBm selon l'alimentation), le bloc wifi porte le canal et une empreinte
    de 4 chiffres hexadecimaux tiree du BSSID (FNV-1a replie sur 16 bits) :
    deux points d'acces se distinguent sans que leur adresse MAC sorte de la
    sonde. json_check les accepte (facultatifs pour les captures anterieures,
    presents ensemble, nuls hors connexion, jamais un BSSID entier) ;
    verse_capture les admet.
2026-11-10 Sonde : balayage Wi-Fi du demarrage dans reseau/ip
    Avant la premiere connexion, la sonde balaie tous les canaux et publie
    dans wifi.balayage le nombre de points d'acces captes et, pour son
    reseau, les 4 plus forts (canal, empreinte, signal ; jamais la MAC).
    Banc 21 : sur batterie, elle rejoint parfois un point d'acces lointain ;
    ce releve dit si le proche manquait au balayage ou n'a pas ete choisi.
    Schema, filtre de verse_capture (cles admises a chaque niveau), tests
    et doc a jour.
2026-11-10 Banc 21 consigne : batterie OK, consommation, critere 4 reporte
    Batterie Anker 30 min OK ; consommation Wi-Fi actif 91 mA au repos,
    95 a 141 mA sous krona (pointes 223 mA). Critere 4 en echec deux fois :
    le 09/11, mauvais point d'acces (corrige par le balayage du demarrage) ;
    le 10/11, coupures Wi-Fi periodiques entre le point d'acces et la sonde,
    mises hors de cause la sonde, son firmware et son alimentation. Le §8.4
    se refera quand un ping de 2 min sera propre.
2026-11-10 Banc 24 consigne : injection 10/10, collision 10/10, etage sur plaque d'essai
    Criteres 5 au BANC §7 : refus, injection simple, collision, bus occupe,
    desarmement seul, fin et demontage. Etage d'injection sur la plaque d'essai,
    R3 dans les contacts M01-Q01 du boitier ; pose soudee reportee (contacts
    pas encore recus).
2026-11-11 Phase 4 finie : critère 4 et étage soudé déplacés en phase 5
    Les deux points reportés de la phase 4 deviennent des préalables dans le
    plan de la phase 5 : le critère 4 (dix minutes de krona par le Wi-Fi)
    avant l'étape 5, l'étage d'injection soudé avant l'étape 7.
